Sadrita404/Differential-Swerve-Robot/USEFUL/BOM.xlsx

Differential Swerve Robot BOM
Summary |  |  |  |  | Low ($) | High ($)
Mechanical only |  |  |  |  | $110.00 | $158.00
Electrical, PCB build |  |  |  |  | $221.00 | $231.00
Electrical, breadboard build |  |  |  |  | $57.00 | $66.00
Total, PCB build |  |  |  |  | $331.00 | $389.00 | PCB at PCBWay price; JLC is cheaper. Excludes filament.
Total, breadboard build |  |  |  |  | $167.00 | $224.00 | No PCB, headers, JST, terminals, DIP switches, or buck. Excludes filament.
Category | Item | Spec | Qty needed | What to buy | Cost low ($) | Cost high ($) | Source | Notes | PCB build | Breadboard build
Mechanical | NEMA 17 stepper | 38-48mm body | 8 | 1x 10-pack | $60.00 | $90.00 | Amazon | Price depends on length. 2 spares in the pack. Motor wires included. | Y | Y
Mechanical | Pancake NEMA 17 stepper | Pancake | 1 | 1 | $10.00 | $10.00 | Amazon | Turret axis | Y | Y
Mechanical | M4x12 button head bolt | M4x12 | ~150 | Assortment / box | $10.00 | $20.00 | Amazon (budget) or McMaster | Amazon quality is usually poor; McMaster costs more | Y | Y
Mechanical | M3x10 button head bolt | M3x10 | 36 | Box | $5.00 | $5.00 | Amazon |  | Y | Y
Mechanical | U624 U-groove bearing | 4x13x7mm | 48-64 | 48: 40-pack + 10-pack; 64: 2x 40-pack | $22.00 | $30.00 | Amazon | 12-16 per module. More bearings = more stability, more friction. Packs: 10 for $7, 40 for $15 | Y | Y
Mechanical | 608 bearing | 8x22x7mm | 8 | 1x 10-pack | $3.00 | $3.00 | Amazon |  | Y | Y
Electrical | PCB (12-channel stepper carrier) | 4-layer, ~125x125mm | 1 | Fab order | $150.00 | $150.00 | PCBWay quote | PCBWay quoted $150. JLC is cheaper; replace with a JLC quote to lower this. 12 channels, only 9 used. | Y | N
Electrical | A4988 stepper driver | Stepstick | 9 | 1x 10-pack | $13.00 | $13.00 | Amazon | TMC2209, DRV8825 work as well | Y | Y
Electrical | Electrolytic capacitor | 100uF, 30V+ | 9 | Assortment | $1.00 | $1.00 | Amazon | Pennies each | Y | Y
Electrical | Pin headers, male + female | 2.54mm | As needed | Assortment | $5.00 | $5.00 | Amazon | Look for packs that have both male and female | Y | N
Electrical | JST XH male header | XH | 9 | Assortment | $8.00 | $8.00 | Amazon | Mating connectors usually come with motors | Y | N
Electrical | Screw terminal block | 2-pin, 5.08mm pitch | 3 | Assortment | $4.00 | $4.00 | Amazon |  | Y | N
Electrical | DIP switch | 3-position | 2 | Assortment | $5.00 | $5.00 | Amazon |  | Y | N
Electrical | MCU | ESP32/2560 etc. | 1 | 1 | $5.00 | $10.00 | Amazon |  | Y | Y
Electrical | Li-ion battery pack |  | 1 | 1 | $30.00 | $30.00 | Amazon |  | Y | Y
Electrical | Breadboard + jumper wires |  | 1 set | Kit | $8.00 | $12.00 | Amazon | Breadboard Approximate | N | Y
Electrical | 5V buck converter (optional) |  | 0-1 | 1 | $0.00 | $5.00 | Amazon | Only if powering the MCU from the main battery; a power bank works otherwise | Y | N
