Sadrita404/Differential-Swerve-Robot/PCB_ELECTRICAL/2_ASSEMBLY_DATA/12SW_standard/12StepperPCB_RevB_12SW_BOM.csv

Reference | Value | Footprint | MPN | Qty
C1,C4,C7,C10,C13,C16,C19,C22,C25,C28,C31,C34 | 100uF/50V | Capacitor_THT:CP_Radial_D8.0mm_P3.50mm | EEU-FR1H101 | 12
C37,C38 | 1000uF/50V | Capacitor_THT:CP_Radial_D12.5mm_P5.00mm | EEU-FR1H102 | 2
D1 | SMBJ30A | Diode_SMD:D_SMB | SMBJ30A | 1
J1-J12 | Stepstick_Ctrl | Connector_PinSocket_2.54mm:PinSocket_1x08_P2.54mm_Vertical | PPTC081LFBN-RC | 12
J13-J24 | Stepstick_Pwr | Connector_PinSocket_2.54mm:PinSocket_1x08_P2.54mm_Vertical | PPTC081LFBN-RC | 12
J25-J36 | Motor_JST_XH | Connector_JST:JST_XH_B4B-XH-A_1x04_P2.50mm_Vertical | B4B-XH-A(LF)(SN) | 12
J49 | IDC_Control_26p | Connector_IDC:IDC-Header_2x13_P2.54mm_Vertical | 302-S261 | 1
J50 | EN_Header | Connector_PinHeader_2.54mm:PinHeader_1x03_P2.54mm_Vertical | PREC003SAAN-RC | 1
J51 | VDD_5V_IN | TerminalBlock_Phoenix:TerminalBlock_Phoenix_MKDS-1,5-2-5.08_1x02_P5.08mm_Horizontal | 1715721 | 1
J52 | VMOT_IN_A | TerminalBlock_Phoenix:TerminalBlock_Phoenix_MKDS-3-2-5.08_1x02_P5.08mm_Horizontal | 1711725 | 1
J53 | VMOT_IN_B | TerminalBlock_Phoenix:TerminalBlock_Phoenix_MKDS-3-2-5.08_1x02_P5.08mm_Horizontal | 1711725 | 1
SW1-SW12 | Microstep_Sel | Button_Switch_THT:SW_DIP_SPSTx03_Slide_9.78x9.8mm_W7.62mm_P2.54mm | 206-3 | 12
