Sadrita404/Differential-Swerve-Robot/CAD_STLS/MAIN.step

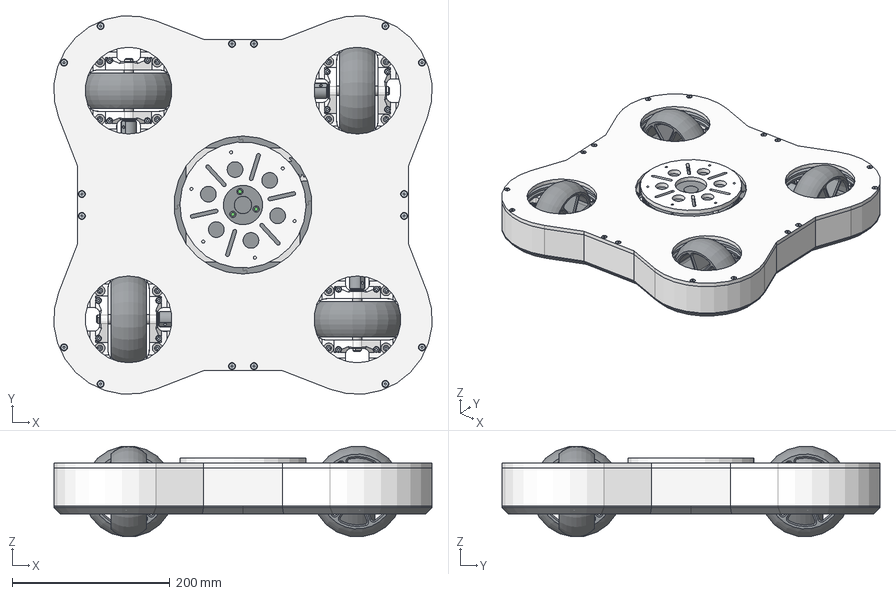
[picture p1: CAD file, 2026-11-04]
CAD_STLS/MAIN.step
479.2 x 479.2 x 114.7 mm
Hex socket countersunk head screw M4x0.7 x 8 x 16
1inSpacer:1__Solid1 x 5
AdapterPlate:1__Solid1
Spur Gear2:1__Solid1
17HM08-1204S Nema17 Pancake 21mm:1__Solid7 x 2
Spur Gear1:1__Solid1
PCB:1__Solid1
SlipRing:1__Solid1
Polycarbonate lid
17HM08-1204S Nema17 Pancake 21mm:1__Solid6
17HM08-1204S Nema17 Pancake 21mm:1__Solid13
17HM08-1204S Nema17 Pancake 21mm:1__Solid11
17HM08-1204S Nema17 Pancake 21mm:1__Solid4
17HM08-1204S Nema17 Pancake 21mm:1__Solid8
17HM08-1204S Nema17 Pancake 21mm:1__Solid9
17HM08-1204S Nema17 Pancake 21mm:1__Solid5
17HM08-1204S Nema17 Pancake 21mm:1__Solid3
17HM08-1204S Nema17 Pancake 21mm:1__Solid12
17HM08-1204S Nema17 Pancake 21mm:1__Solid10
17HM08-1204S Nema17 Pancake 21mm:1__Solid14
17HM08-1204S Nema17 Pancake 21mm:1__Solid1
17HM08-1204S Nema17 Pancake 21mm:1__Solid2
Hex socket head cap screw M4x0.70 x 8 x 32
Hex socket head cap screw M4x0.70 x 15 x 48
PCBspacer:1__Solid1 x 3
ModuleScaleTest:1__Solid79 x 32
SideCover x 4
Recessed Mount x 4
Hex socket head cap screw M4x0.70 x 12 x 44
8mm Axle x 4
Stepper Motor Gear x 8
Wheel x 4
Spacer 2 x 4
Raised Mount x 4
Inner Differential Gear x 4
Differential Ring Gear x 8
bas x 4
Revised Bearing x 4
Wheel Well x 4
Spacer 1 x 4
countersunk flat head cross recess screw_din_17HM19-2004S-9-solid1 x 8
radial ball bearing_68_din-1-solid1 x 8
nema17_middle-1-solid1 x 8
countersunk flat head cross recess screw_din_17HM19-2004S-7-solid1 x 8
nema17_bottom-1-solid2 x 8
countersunk flat head cross recess screw_din_17HM19-2004S-8-solid1 x 8
countersunk flat head cross recess screw_din_17HM19-2004S-10-solid1 x 8
nema17_bottom-1-solid1 x 8
nema17_top-1-solid1 x 8
nema17_shaft-1-solid1 x 8
radial ball bearing_68_din-3-solid1 x 8
Bearing Clip x 4
WheelGuard x 4
COVER__Boss-Extrude1_1 x 8
INNER RACE__Cut-Revolve1 x 8
BALL__Revolve1_6 x 64
COVER__Boss-Extrude1 x 8
OUTER RACE__Chamfer1 x 8
