Sadrita404/Differential-Swerve-Robot/CAD_STLS/Cover.dxf

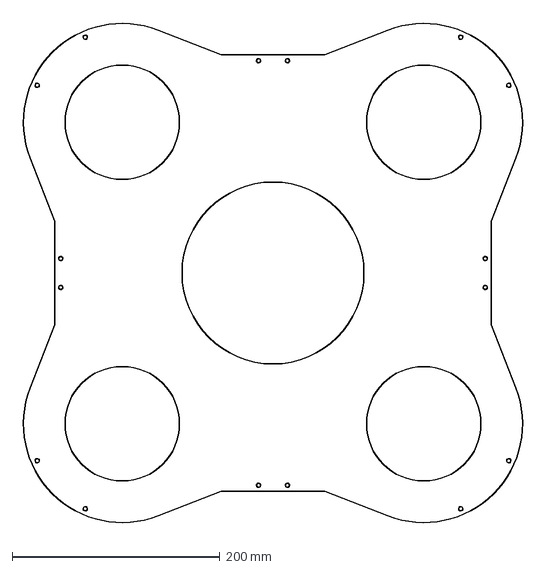
[picture p2: CAD file, 2026-11-04]
CAD_STLS/Cover.dxf
494.4 x 494.4 mm
