Sadrita404/Differential-Swerve-Robot/CAD_STLS/STL/DSP2_ShaftSpacer_4X.stl

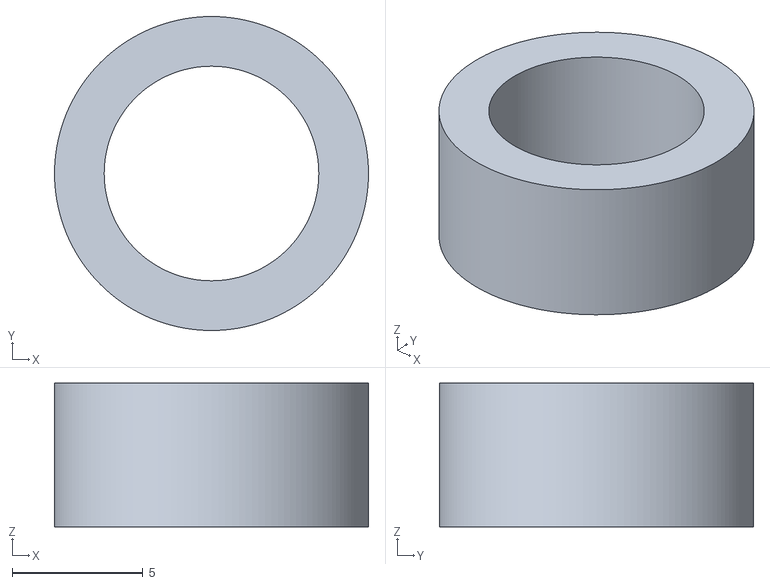
[picture p3: CAD file, 2026-11-04]
CAD_STLS/STL/DSP2_ShaftSpacer_4X.stl
12.0 x 12.0 x 5.50
