Sadrita404/Differential-Swerve-Robot/CAD_STLS/STL/PrintedLid/DSP2_PrintedLidQuater_4X.stl

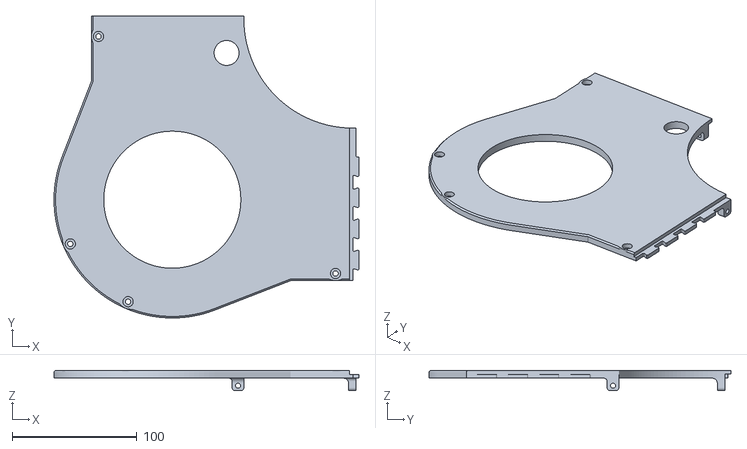
[picture p4: CAD file, 2026-11-04]
CAD_STLS/STL/PrintedLid/DSP2_PrintedLidQuater_4X.stl
244.9 x 242.5 x 16.4
