Sadrita404/Differential-Swerve-Robot/USEFUL/Roller spacing jig.stl

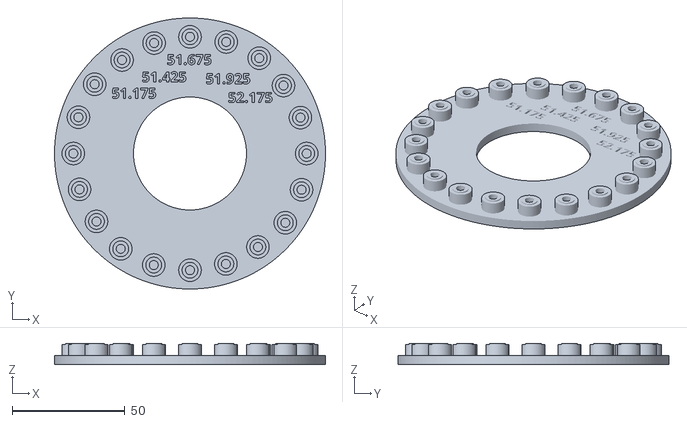
[picture p5: CAD file, 2026-11-04]
USEFUL/Roller spacing jig.stl
120.0 x 120.0 x 9.50
