Sadrita404/Differential-Swerve-Robot/CAD_STLS/STL/DSP2_TurretBase_1X.stl

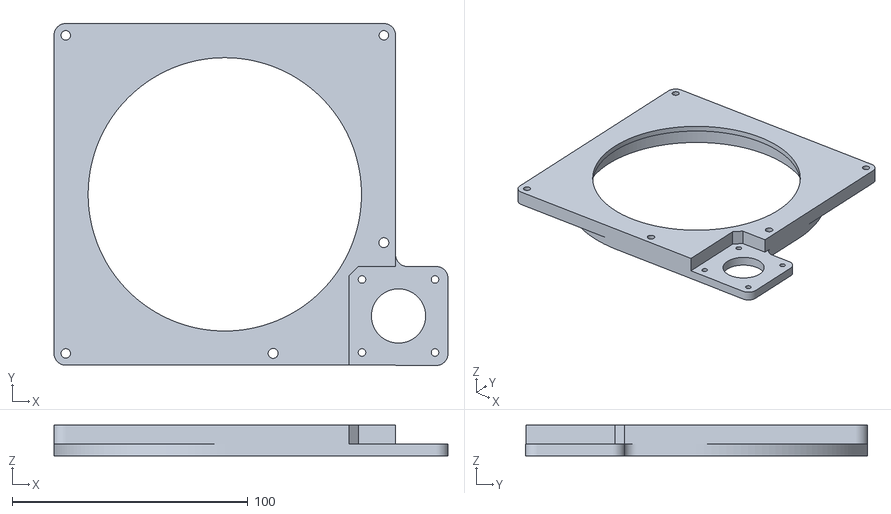
[picture p6: CAD file, 2026-11-04]
CAD_STLS/STL/DSP2_TurretBase_1X.stl
167.2 x 145.1 x 13.0
