Sadrita404/Differential-Swerve-Robot/USEFUL/StepperShaftClearanceJig.stl

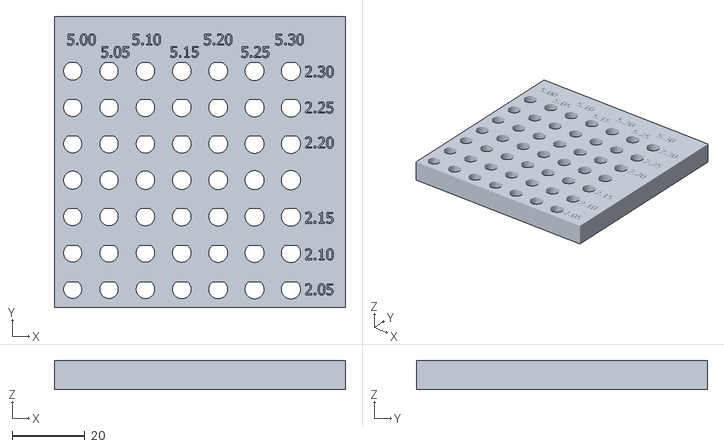
[picture p7: CAD file, 2026-11-04]
USEFUL/StepperShaftClearanceJig.stl
80.0 x 80.0 x 8.00
