Sadrita404/Differential-Swerve-Robot/CAD_STLS/STL/DSP2_WheelFrame_4X.stl

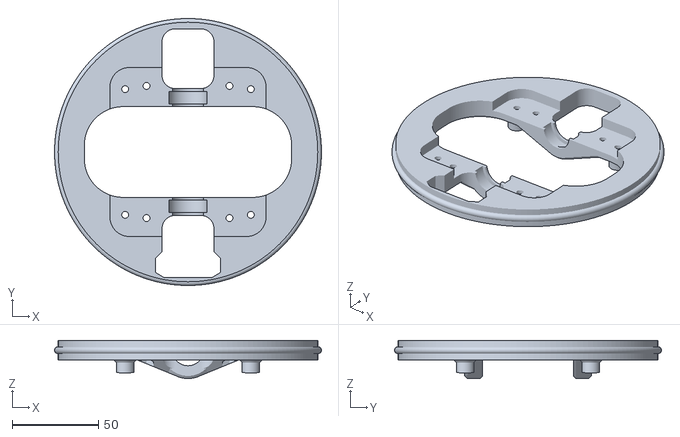
[picture p8: CAD file, 2026-11-04]
CAD_STLS/STL/DSP2_WheelFrame_4X.stl
154.5 x 154.5 x 22.0
