Sadrita404/Differential-Swerve-Robot/CAD_STLS/STL/DSP2_Ring_8X.stl

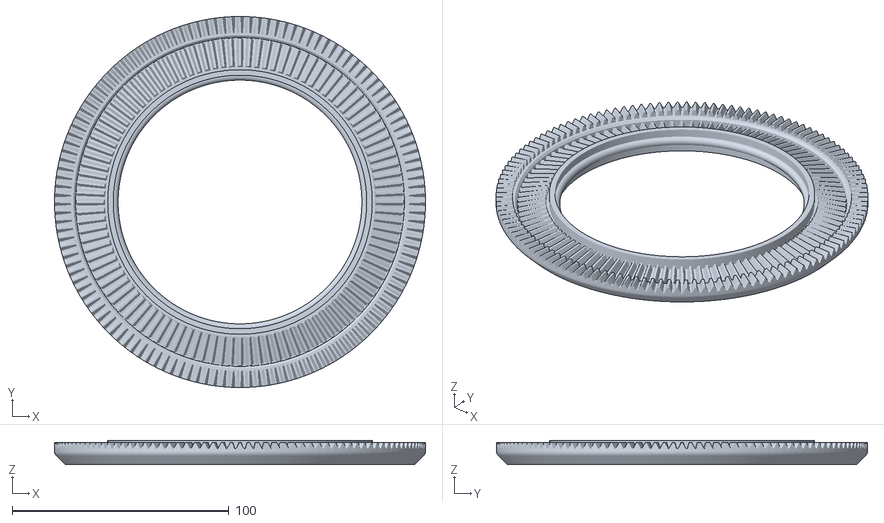
[picture p9: CAD file, 2026-11-04]
CAD_STLS/STL/DSP2_Ring_8X.stl
171.2 x 171.2 x 11.2
