Sadrita404/Differential-Swerve-Robot/CAD_STLS/STL/DSP2_ShortMount_4X.stl

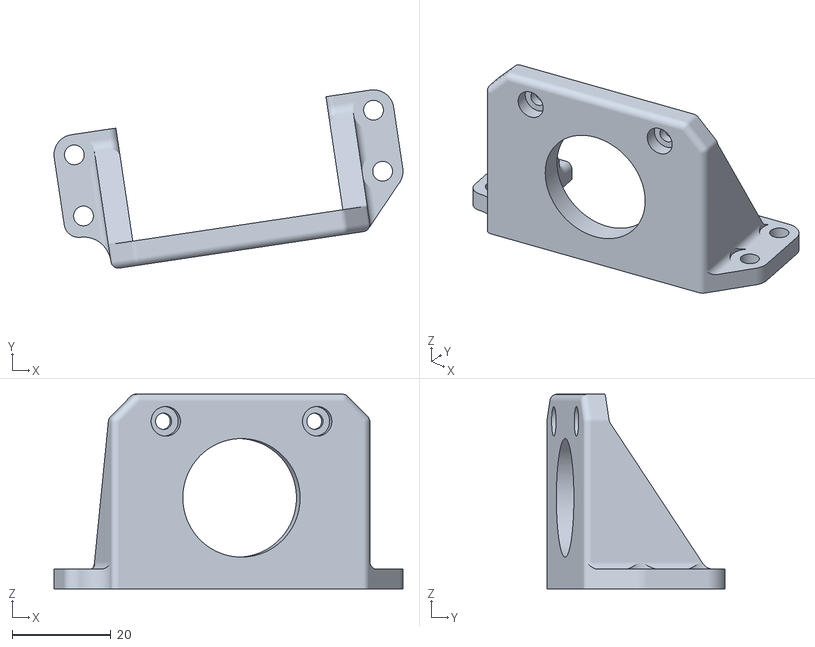
[picture p10: CAD file, 2026-11-04]
CAD_STLS/STL/DSP2_ShortMount_4X.stl
70.7 x 36.1 x 39.4
