Sadrita404/Differential-Swerve-Robot/CAD_STLS/STL/DSP2_TurretGear_1X.stl

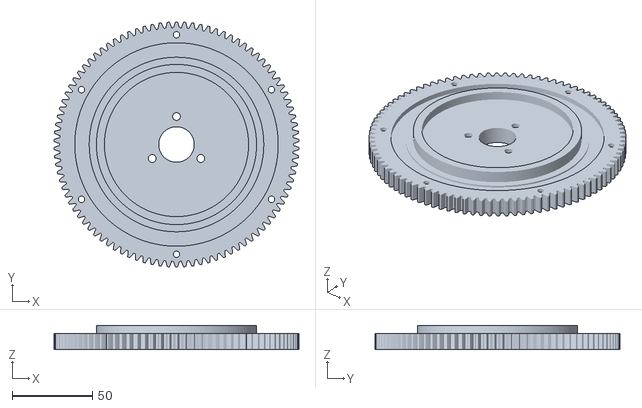
[picture p11: CAD file, 2026-11-04]
CAD_STLS/STL/DSP2_TurretGear_1X.stl
153.0 x 153.0 x 15.0
