Sadrita404/Differential-Swerve-Robot/CAD_STLS/STL/DSP2_Base_4X.stl

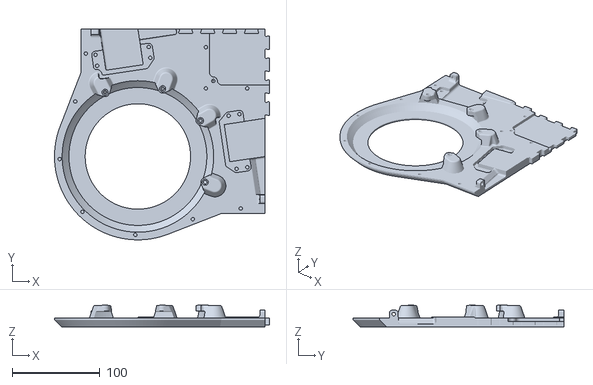
[picture p12: CAD file, 2026-11-04]
CAD_STLS/STL/DSP2_Base_4X.stl
244.9 x 240.0 x 24.8
