Sadrita404/Differential-Swerve-Robot/CAD_STLS/STL/DSP2_Side_4X.stl

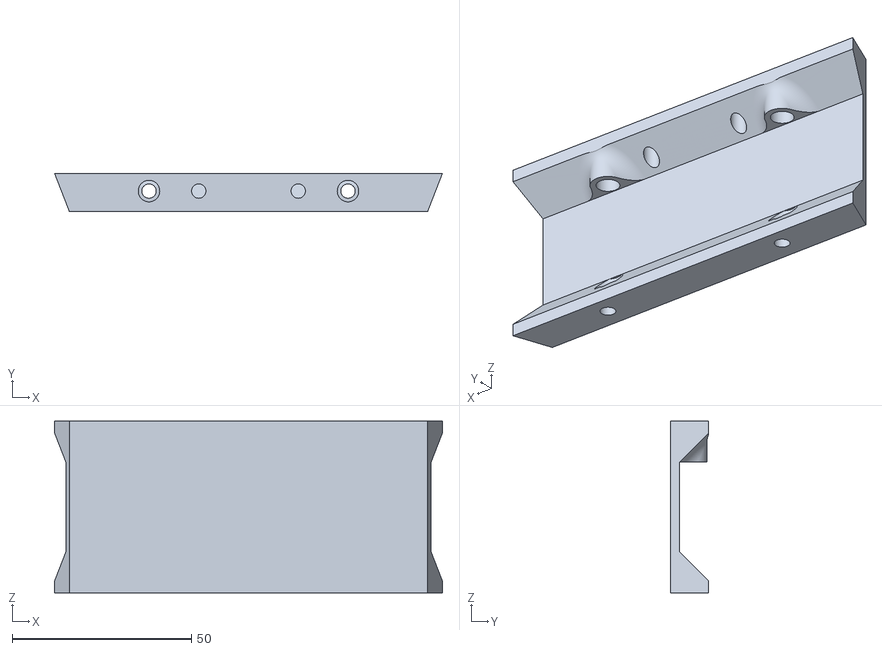
[picture p13: CAD file, 2026-11-04]
CAD_STLS/STL/DSP2_Side_4X.stl
108.3 x 10.7 x 48.0
