Sadrita404/Differential-Swerve-Robot/CAD_STLS/STL/DSP2_Wheel_4X.stl

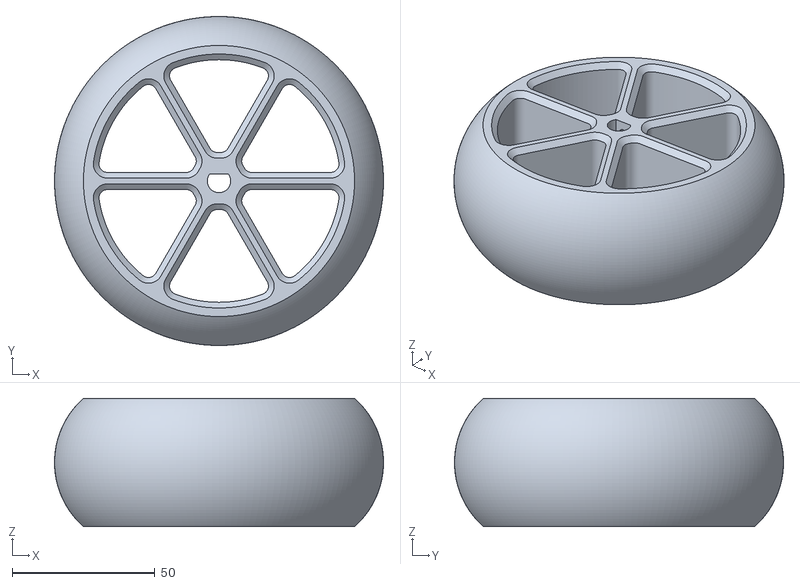
[picture p14: CAD file, 2026-11-04]
CAD_STLS/STL/DSP2_Wheel_4X.stl
115.3 x 115.3 x 45.0
