Sadrita404/Differential-Swerve-Robot/CAD_STLS/STL/DSP2_6820Bearing_1X.stl

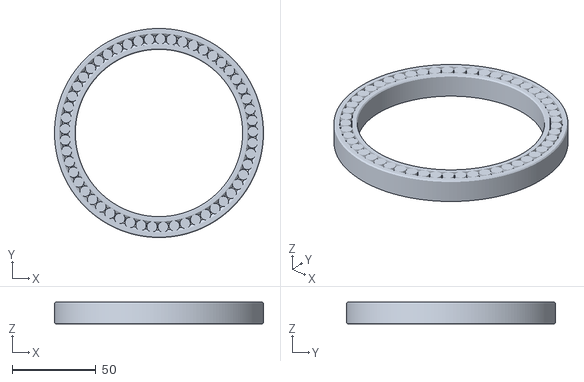
[picture p15: CAD file, 2026-11-04]
CAD_STLS/STL/DSP2_6820Bearing_1X.stl
125.0 x 125.0 x 13.0
