Sadrita404/Differential-Swerve-Robot/CAD_STLS/STL/DSP2_WheelClamp_8X.stl

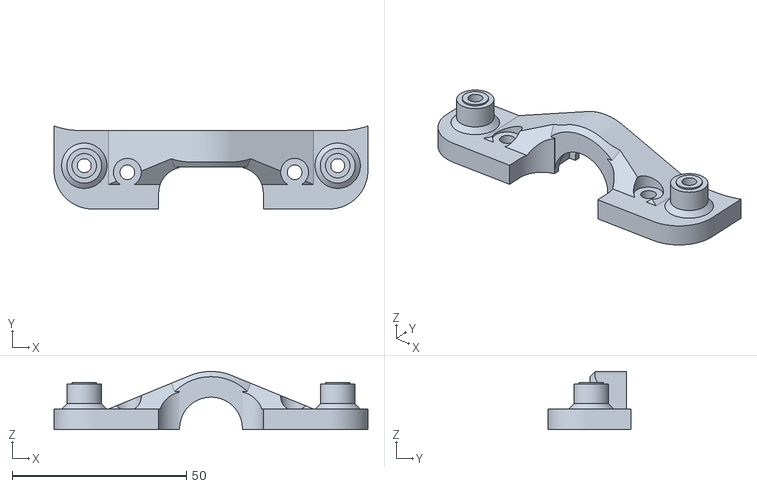
[picture p16: CAD file, 2026-11-04]
CAD_STLS/STL/DSP2_WheelClamp_8X.stl
90.1 x 23.9 x 16.7
