Sadrita404/Differential-Swerve-Robot/CAD_STLS/STL/DSP2_TurretSpacer_5X.stl

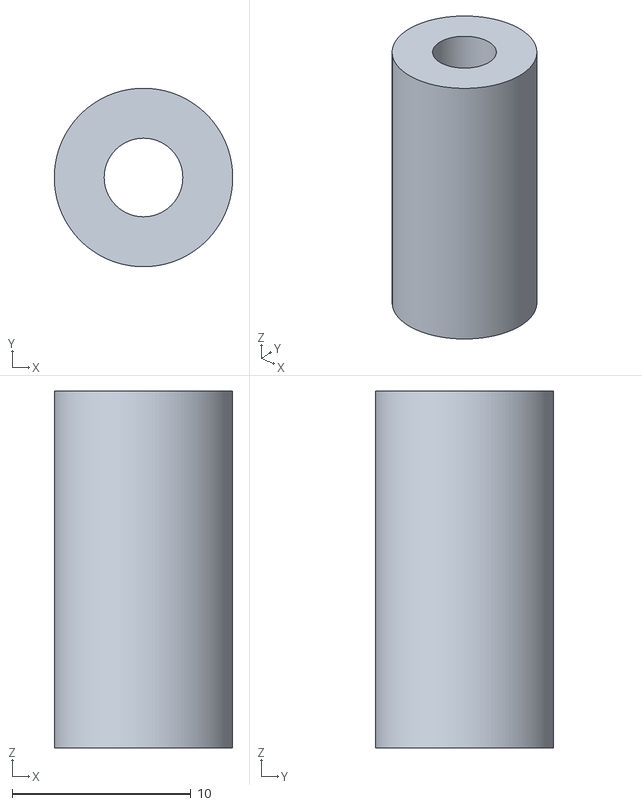
[picture p17: CAD file, 2026-11-04]
CAD_STLS/STL/DSP2_TurretSpacer_5X.stl
10.0 x 10.0 x 20.0
