Sadrita404/Differential-Swerve-Robot/CAD_STLS/STL/DSP2_TurretAdapterPlate_1X.stl

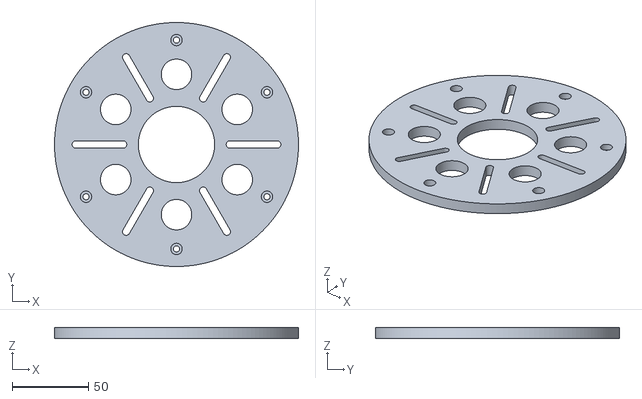
[picture p18: CAD file, 2026-11-04]
CAD_STLS/STL/DSP2_TurretAdapterPlate_1X.stl
160.0 x 160.0 x 7.00
