Sadrita404/Differential-Swerve-Robot/CAD_STLS/STL/DSP2_ShaftBevelGear_4X.stl

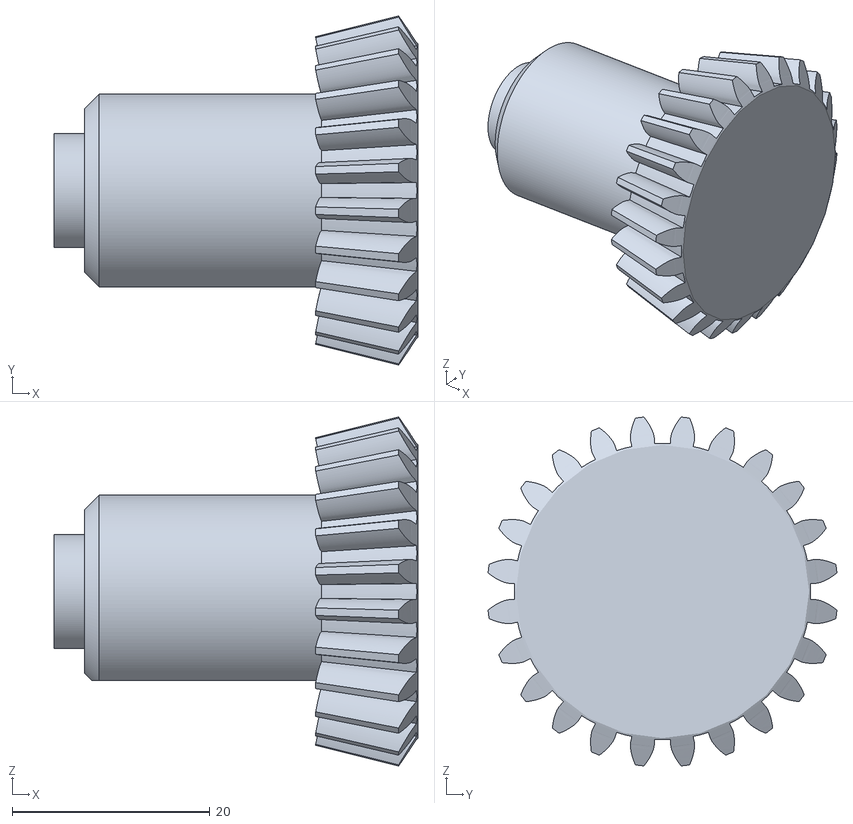
[picture p19: CAD file, 2026-11-04]
CAD_STLS/STL/DSP2_ShaftBevelGear_4X.stl
36.8 x 35.3 x 35.3
