Sadrita404/Differential-Swerve-Robot/CAD_STLS/STL/DSP2_WheelGuard_4X.stl

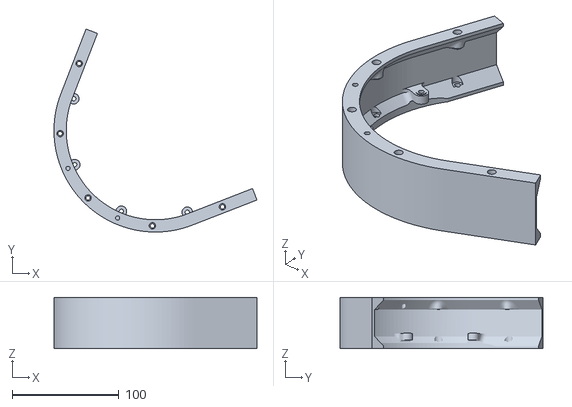
[picture p20: CAD file, 2026-11-04]
CAD_STLS/STL/DSP2_WheelGuard_4X.stl
190.0 x 190.0 x 48.0
