Sadrita404/Differential-Swerve-Robot/CAD_STLS/STL/DSP2_AdapterPlateSpacer_6X.stl

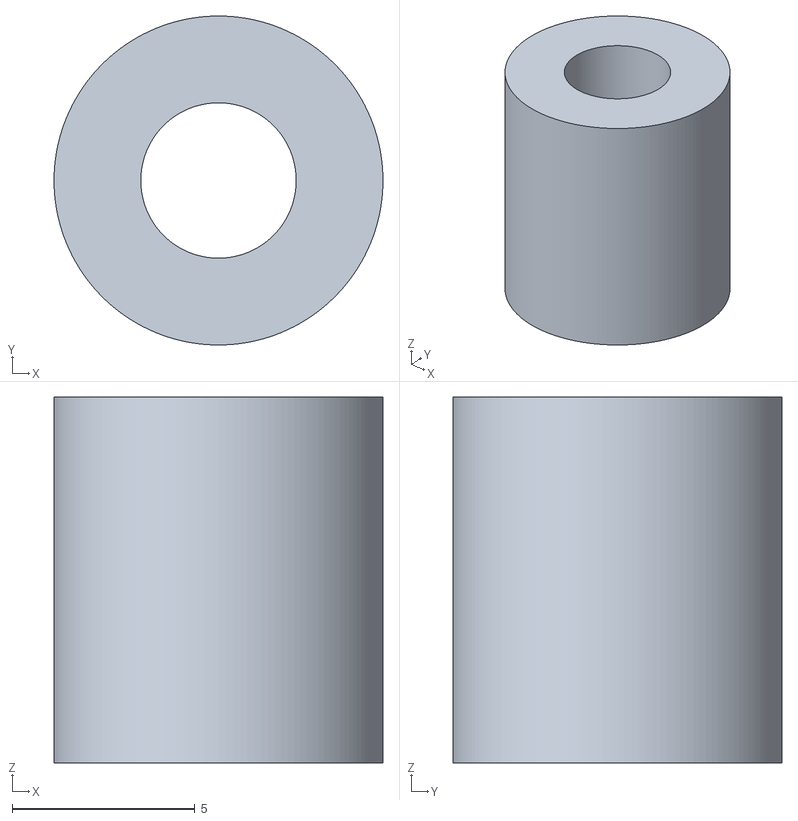
[picture p21: CAD file, 2026-11-04]
CAD_STLS/STL/DSP2_AdapterPlateSpacer_6X.stl
9.00 x 9.00 x 10.0
