Sadrita404/Differential-Swerve-Robot/CAD_STLS/STL/DSP2_TallMount_4X.stl

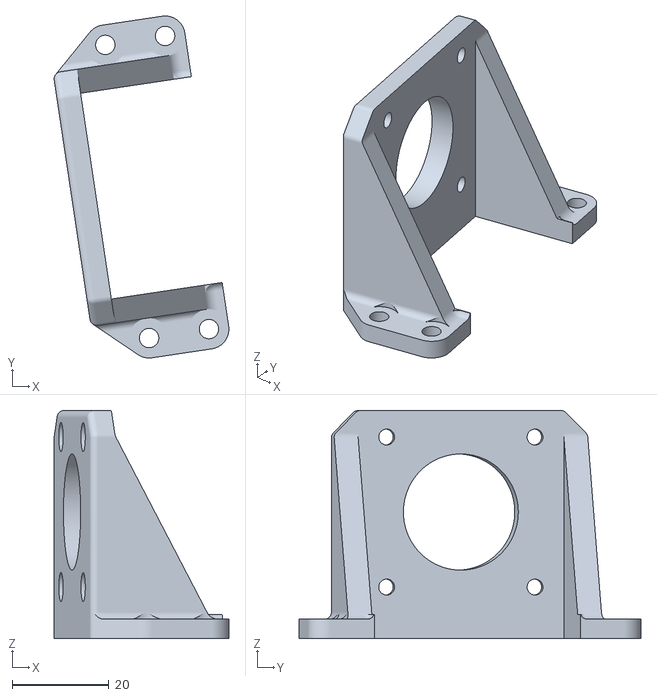
[picture p22: CAD file, 2026-11-04]
CAD_STLS/STL/DSP2_TallMount_4X.stl
36.1 x 70.7 x 47.1
