Sadrita404/Differential-Swerve-Robot/CAD_STLS/STL/DSP2_Axle_4x.stl

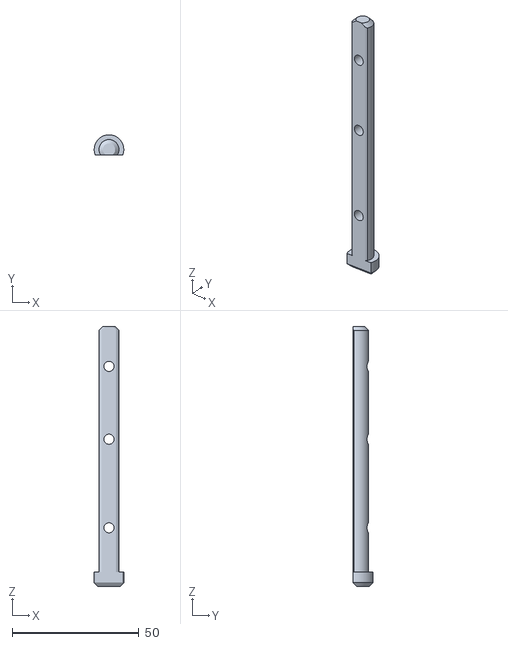
[picture p23: CAD file, 2026-11-04]
CAD_STLS/STL/DSP2_Axle_4x.stl
11.7 x 8.09 x 102.8
