Sadrita404/Differential-Swerve-Robot/PCB_ELECTRICAL/2_ASSEMBLY_DATA/2SW_variant/12StepperPCB_RevB_2SW_Schematic.pdf

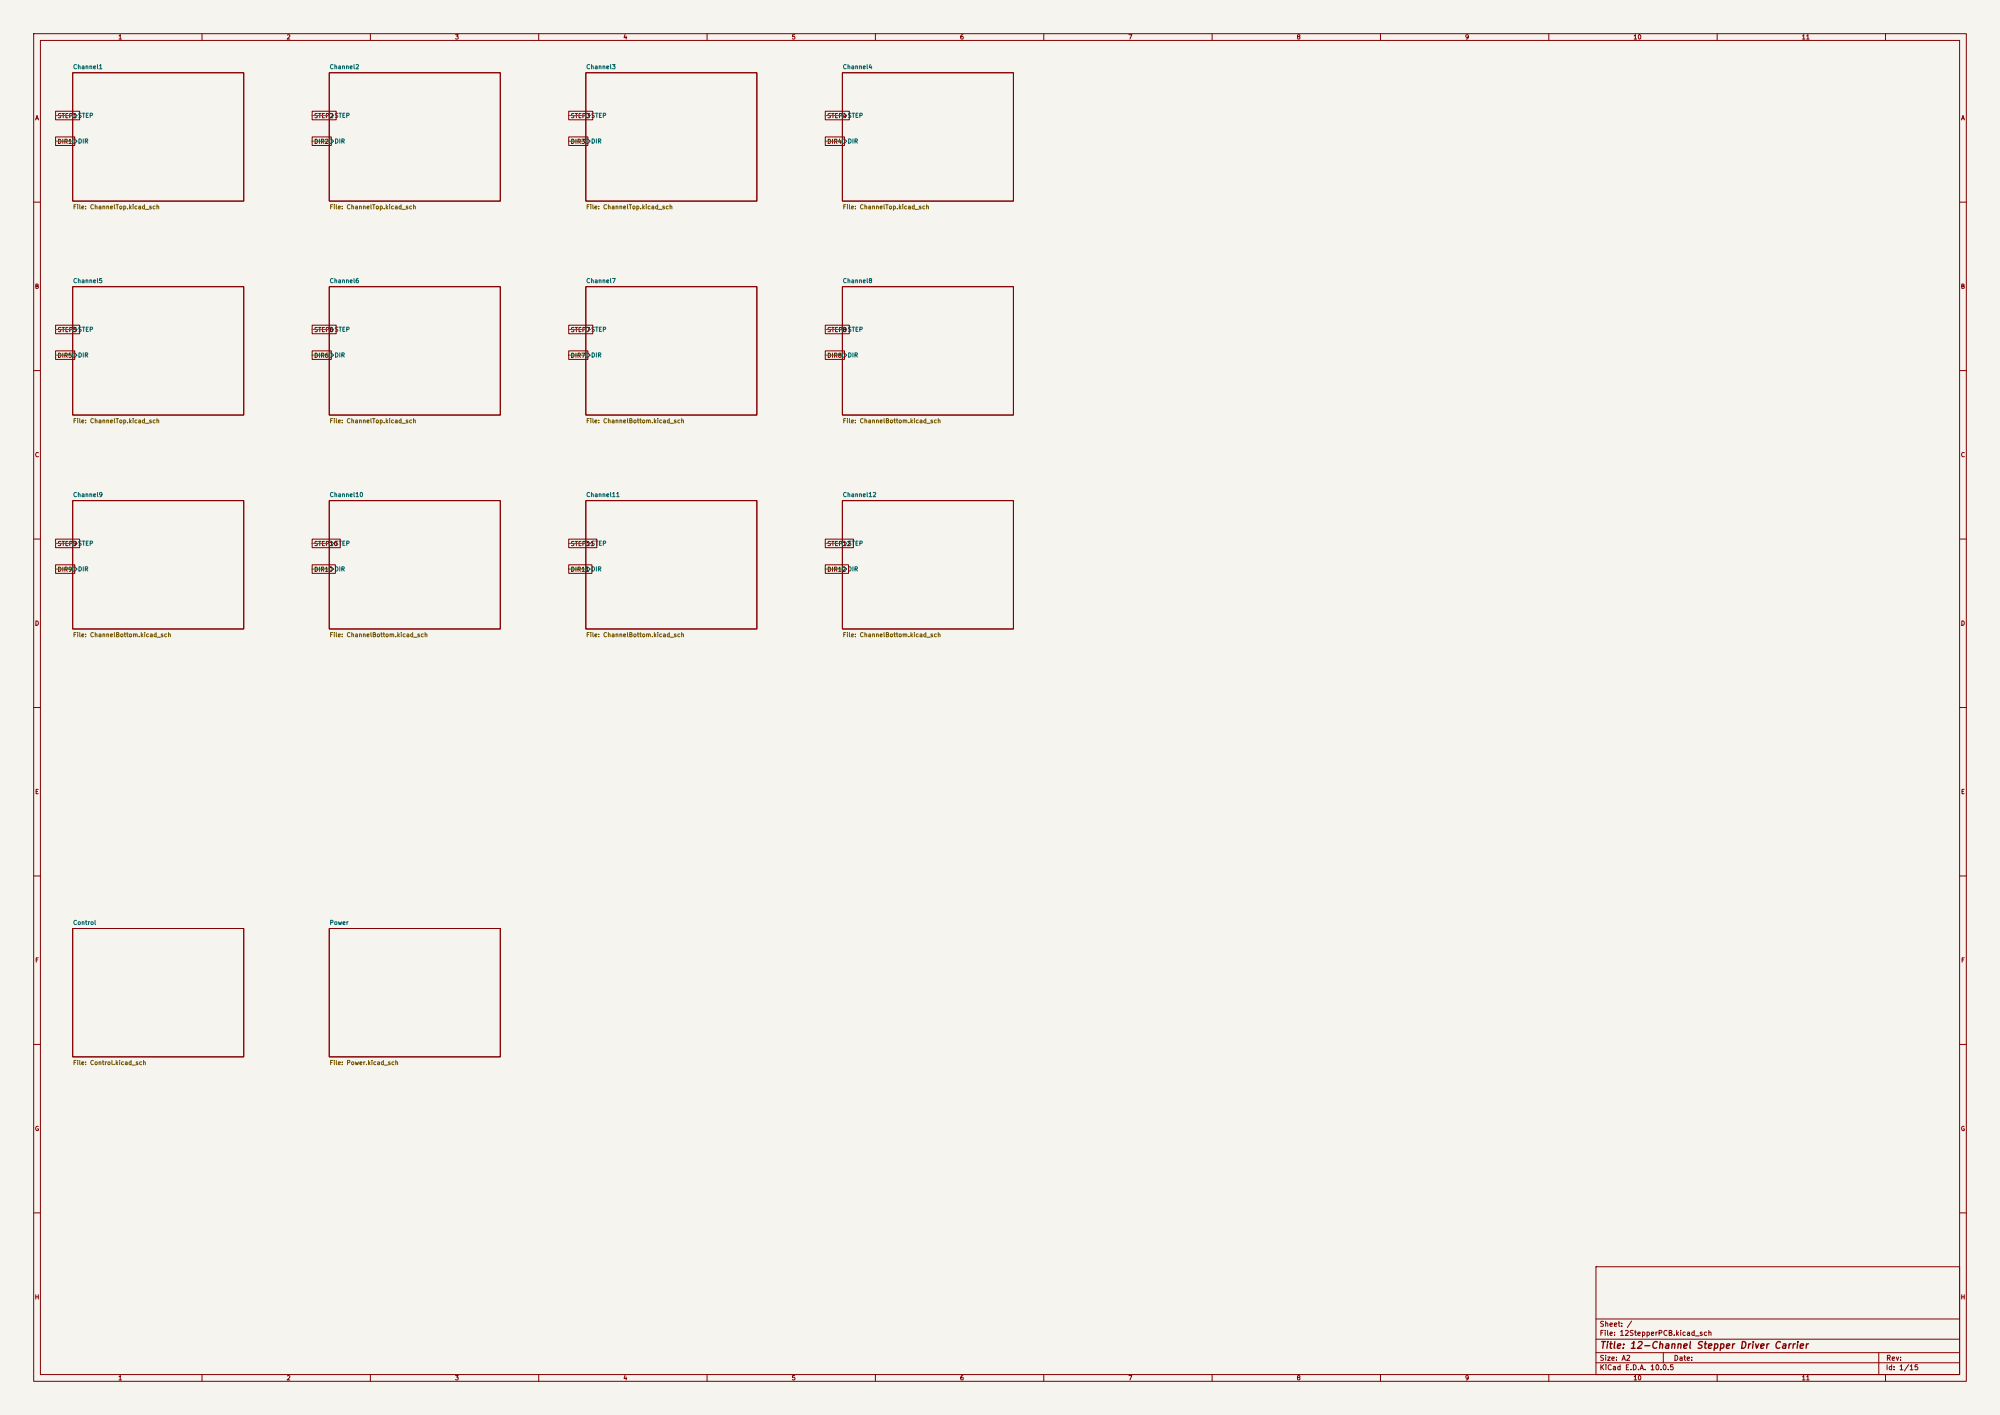
[picture p24: page 1]

Sheet: /
File: 12StepperPCB.kicad_sch
Title: 12-Channel Stepper Driver Carrier

Size: A2 | Rev:
KiCad E.D.A. 10.0.5 | Id: 1/15

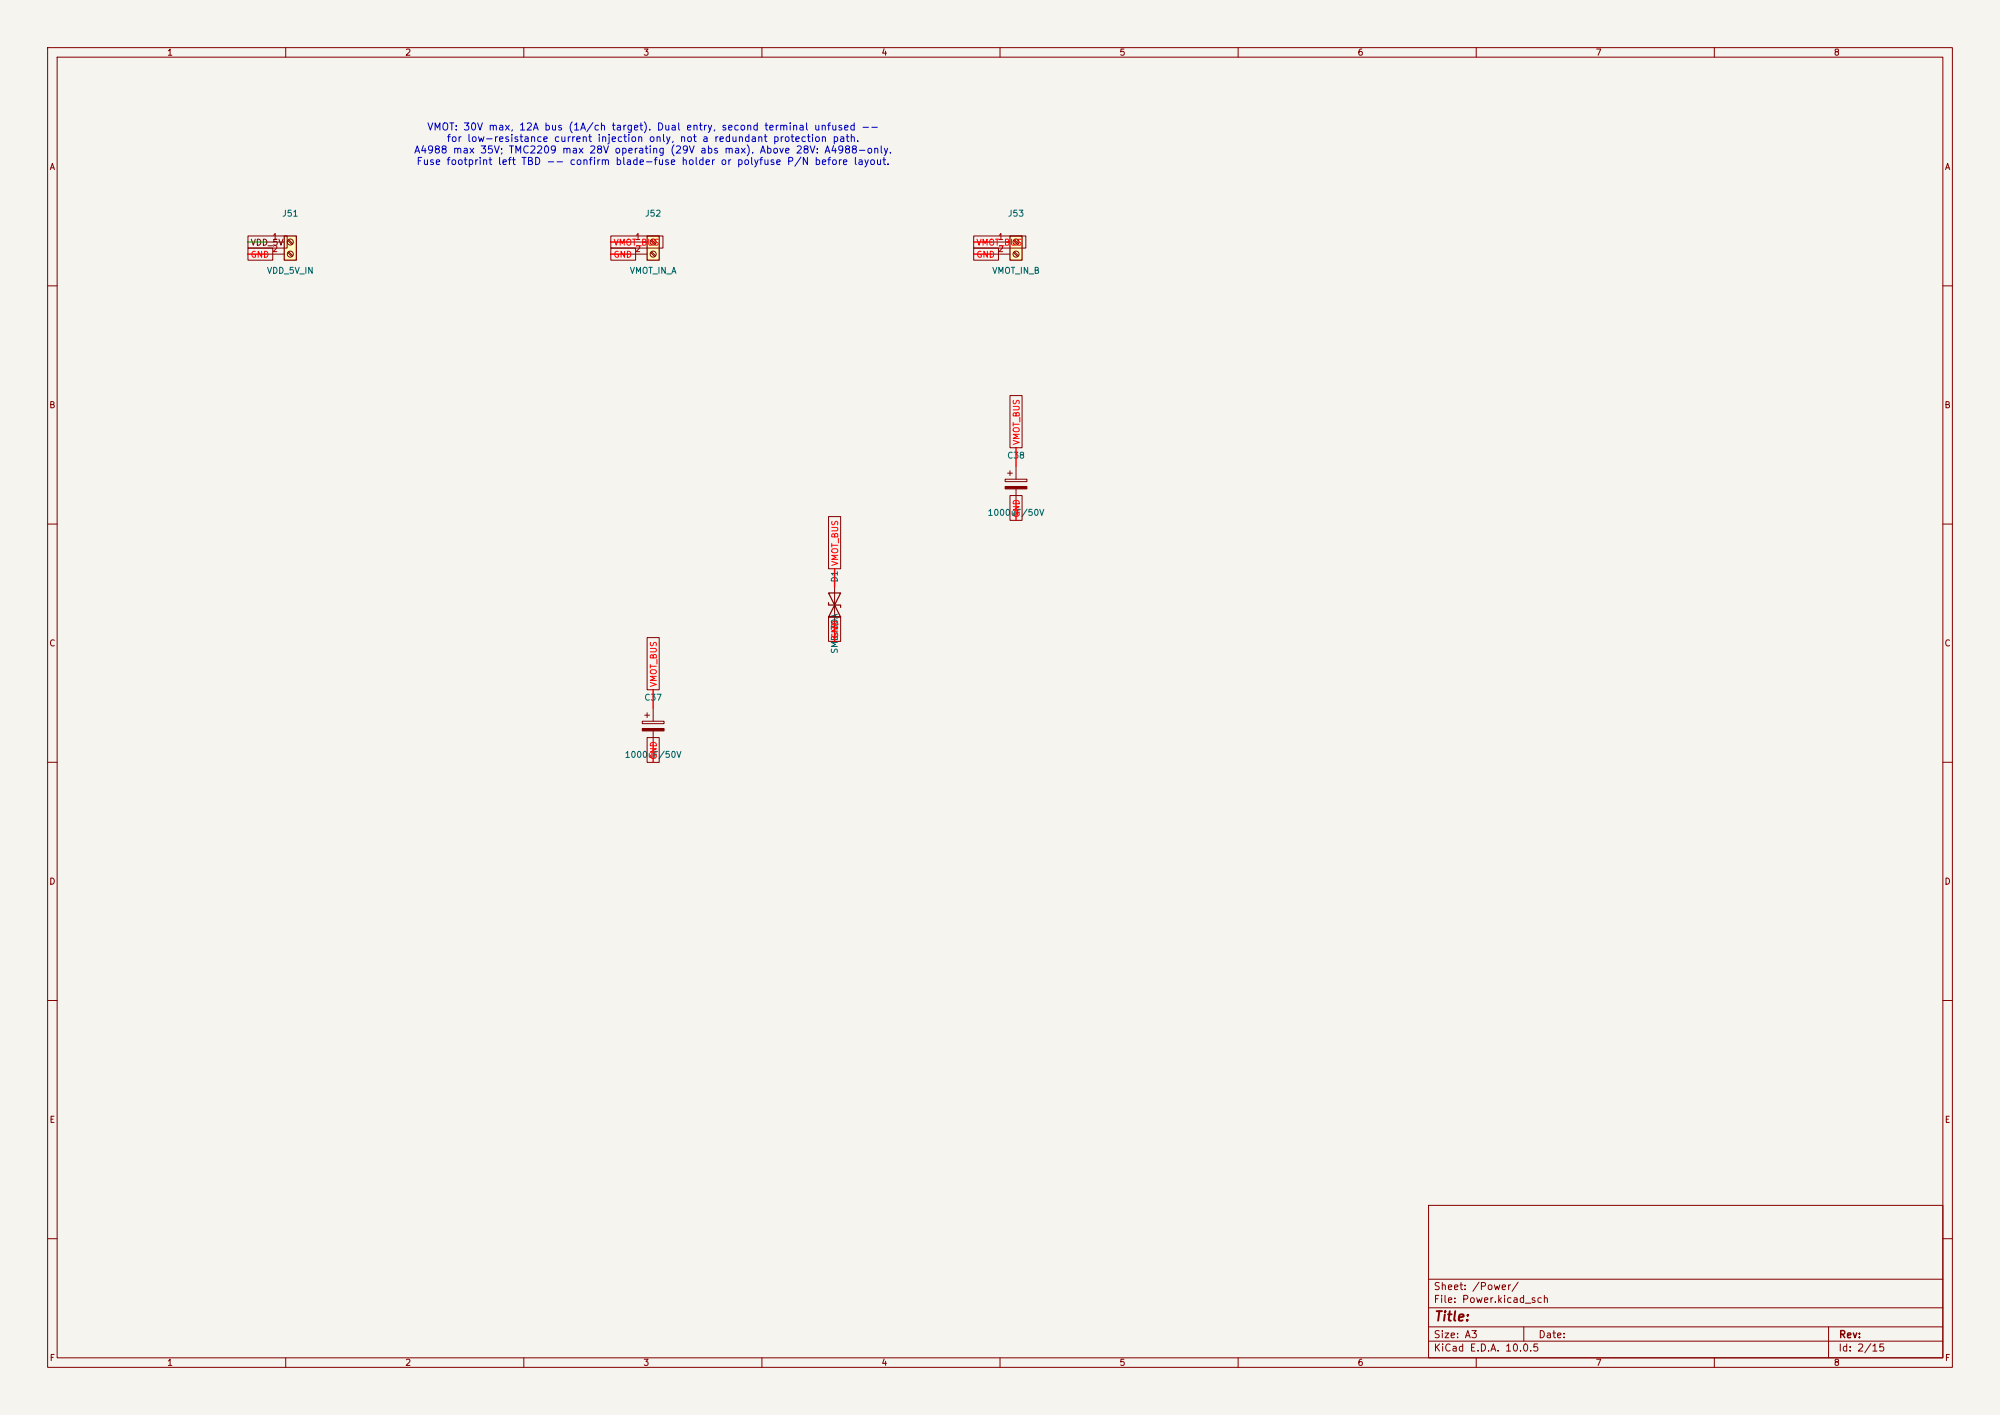
[picture p25: page 2]

VMOT: 30V max, 12A bus (1A/ch target). Dual entry, second terminal unfused --
for low-resistance current injection only, not a redundant protection path.
A4988 max 35V; TMC2209 max 28V operating (29V abs max). Above 28V: A4988-only.
Fuse footprint left TBD -- confirm blade-fuse holder or polyfuse P/N before layout.

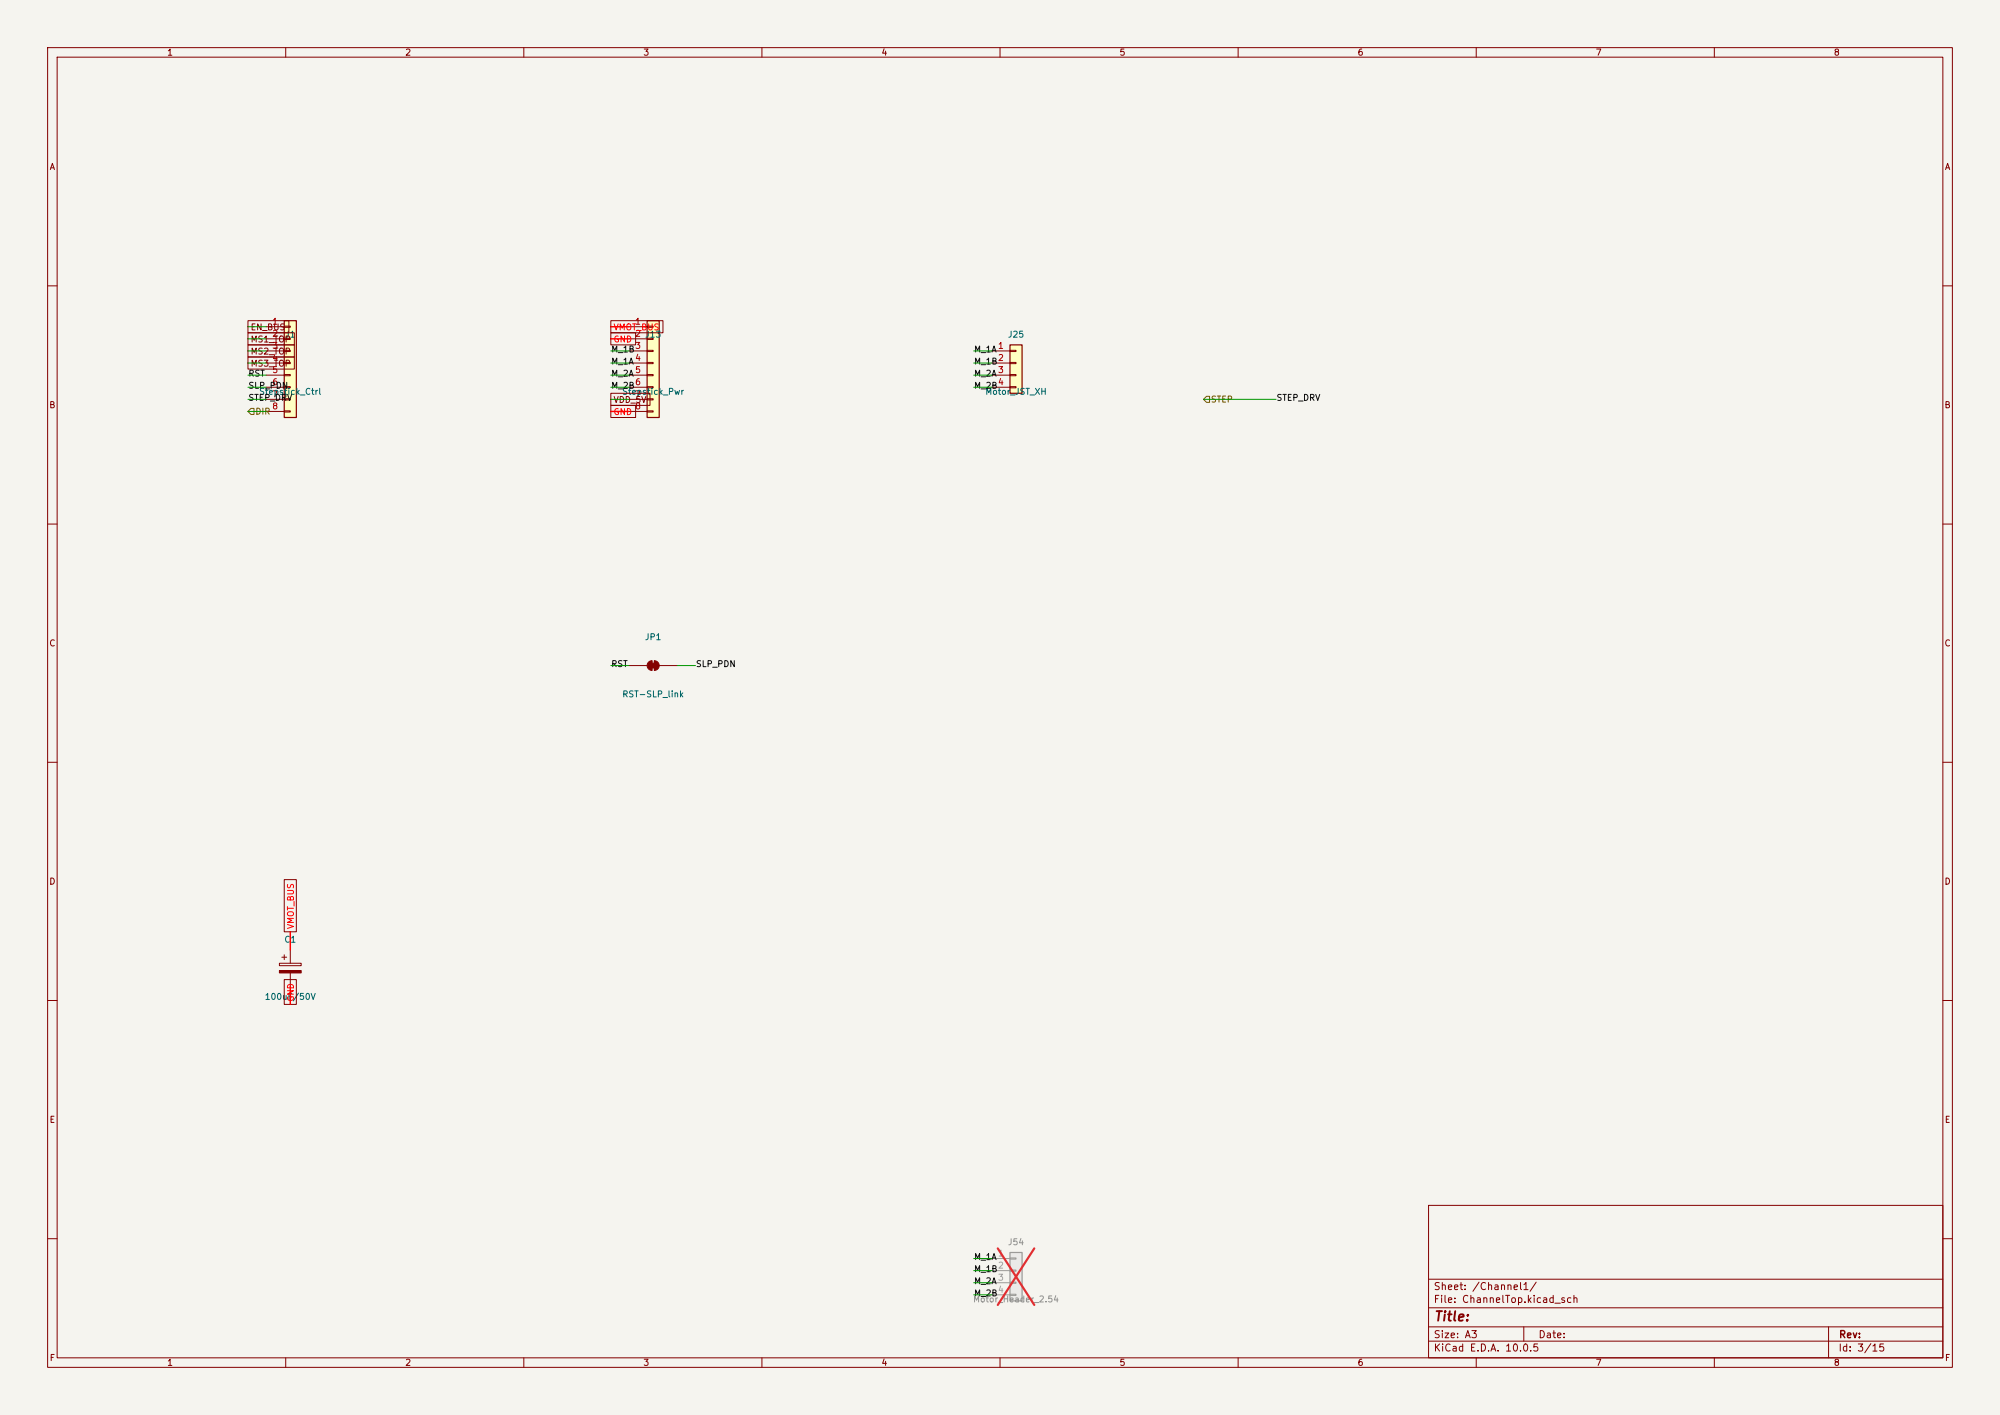
[picture p26: page 3]

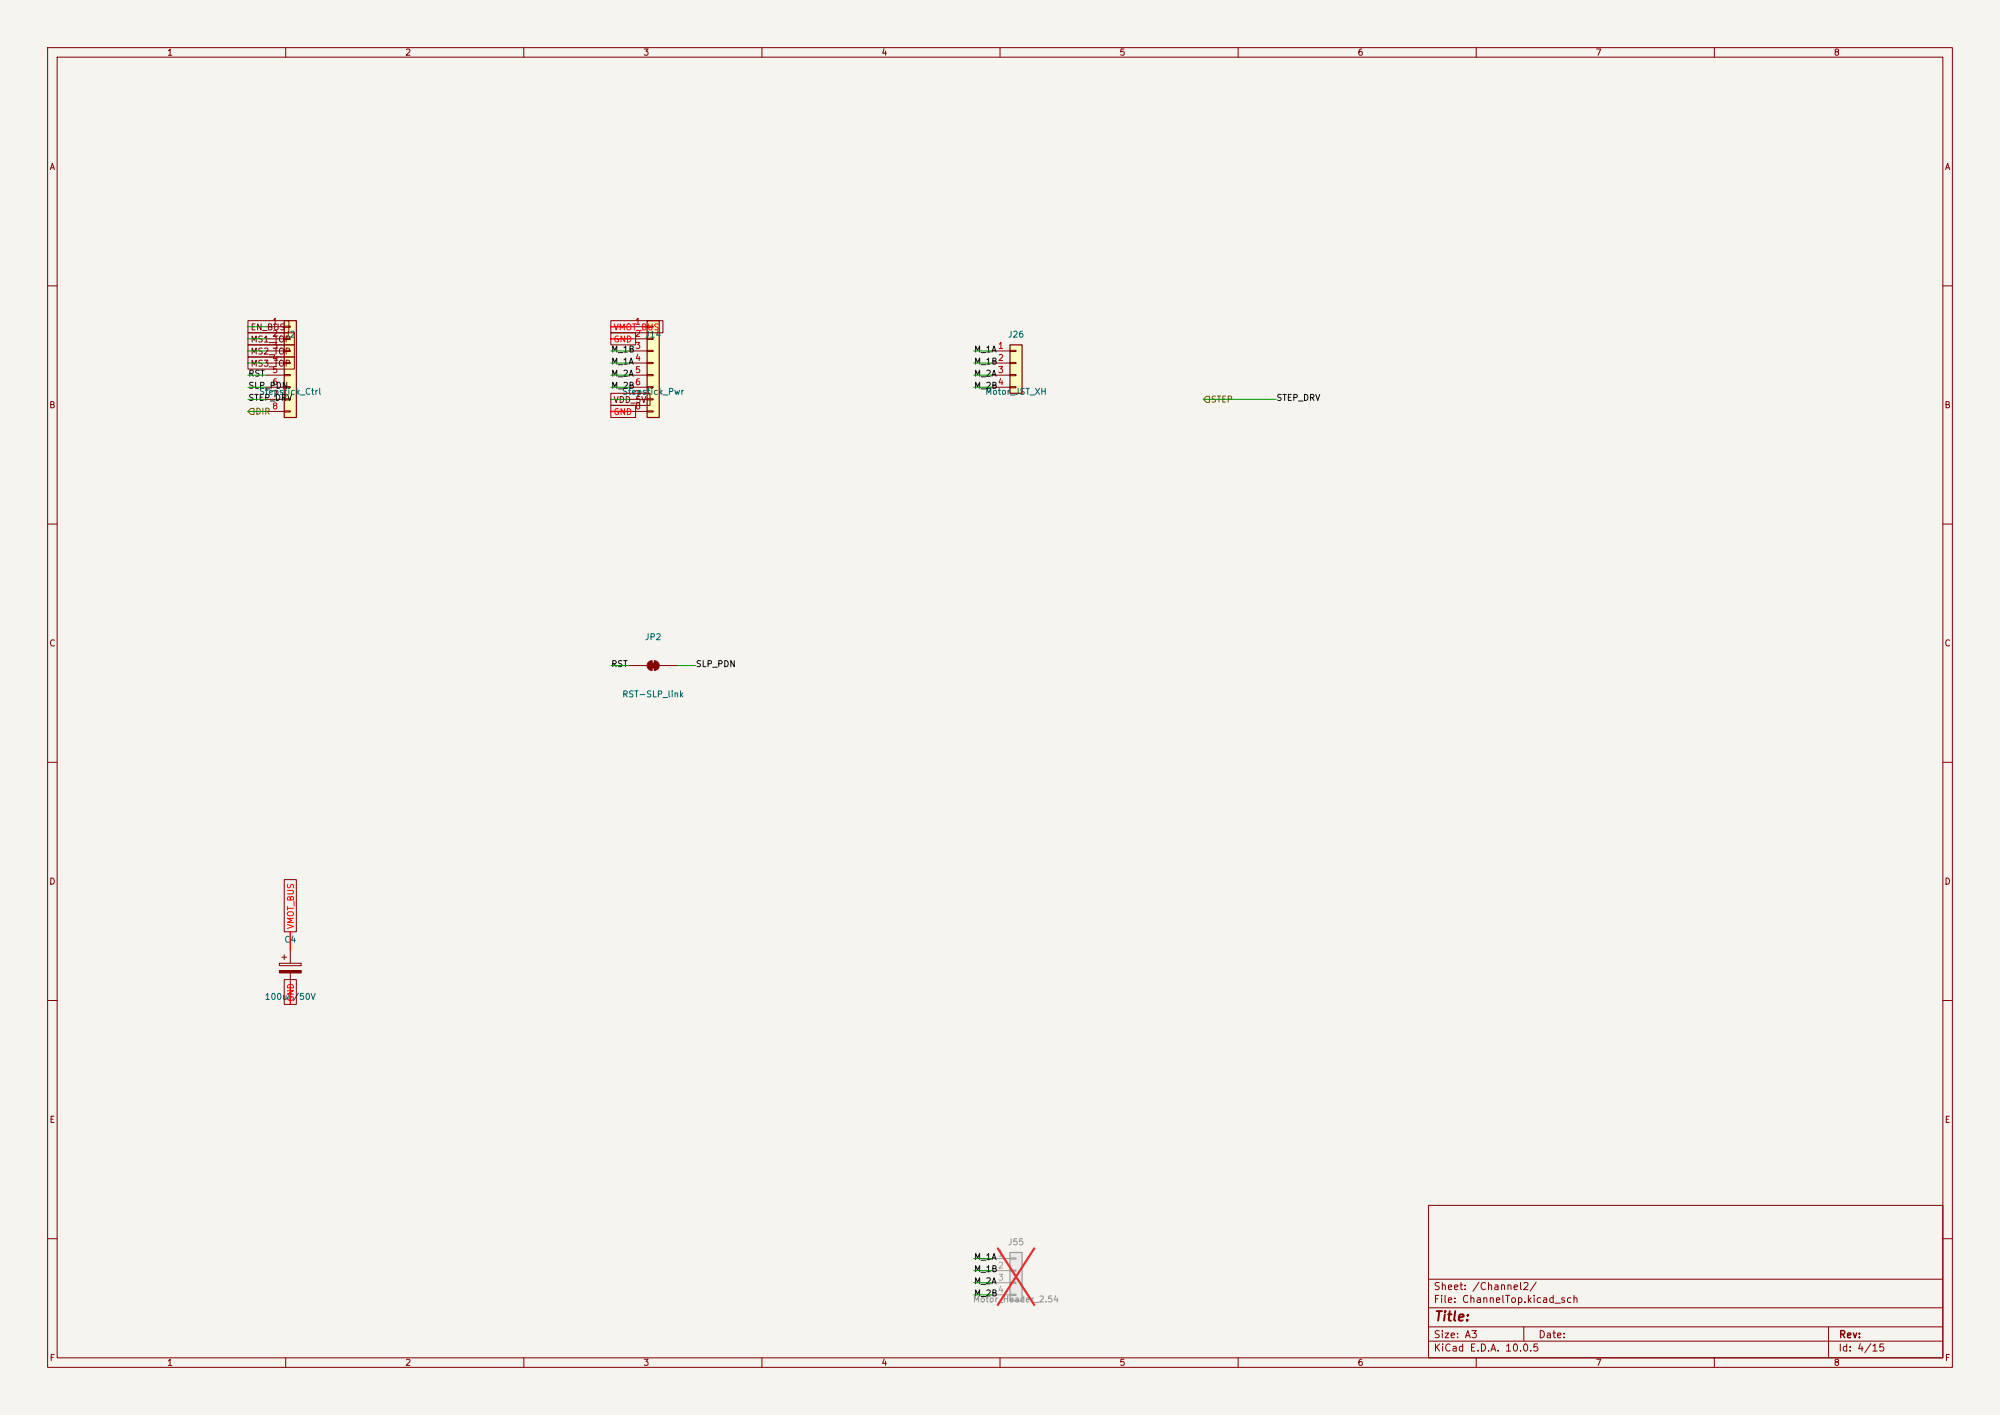
[picture p27: page 4]

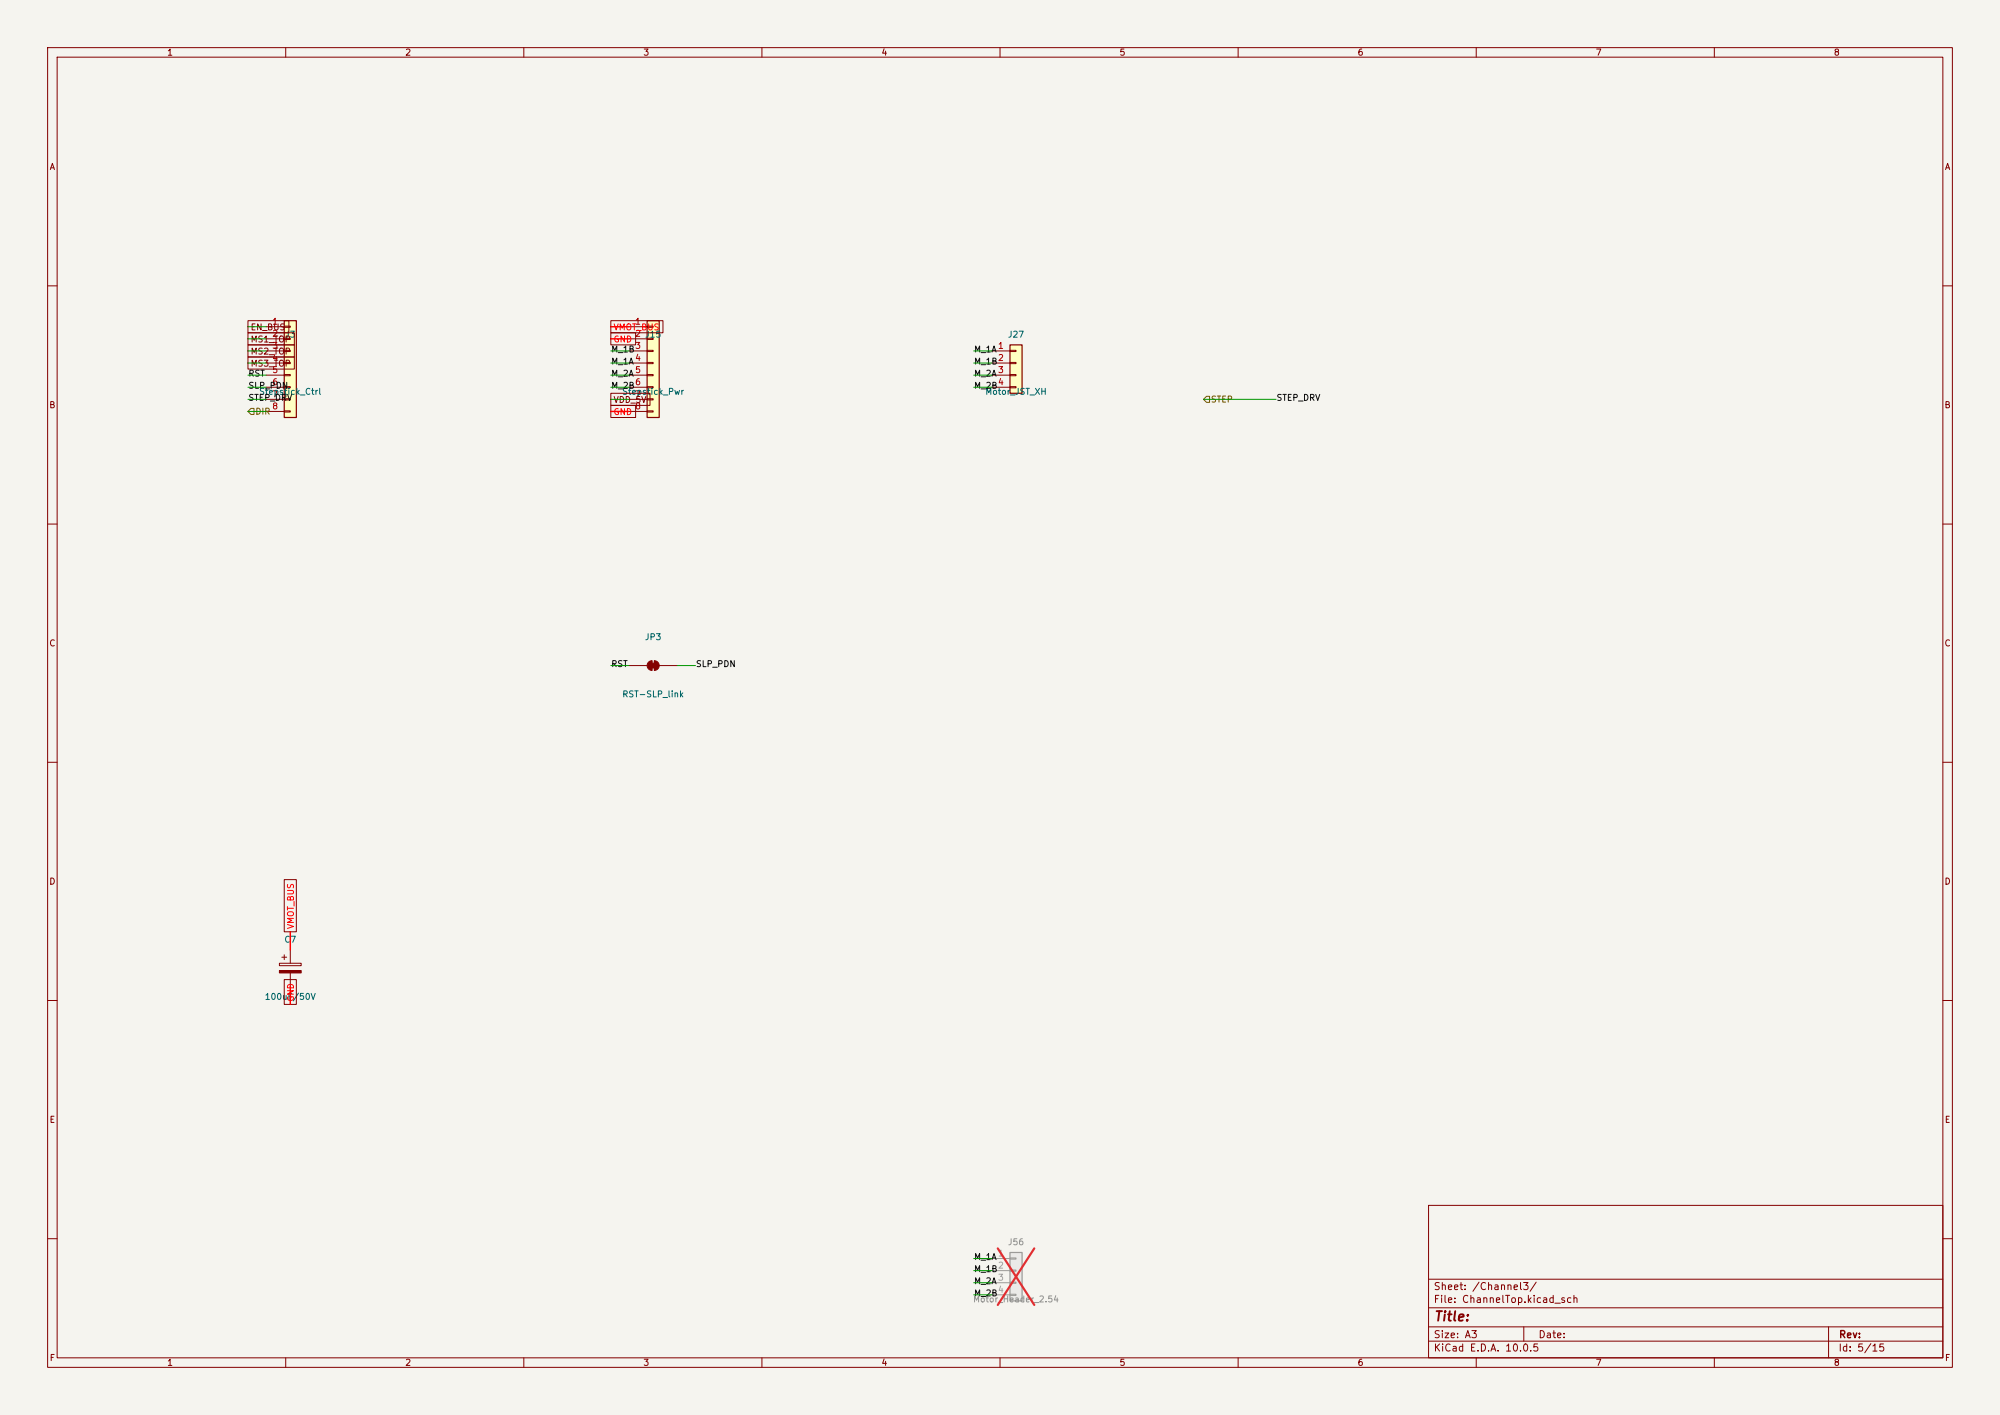
[picture p28: page 5]

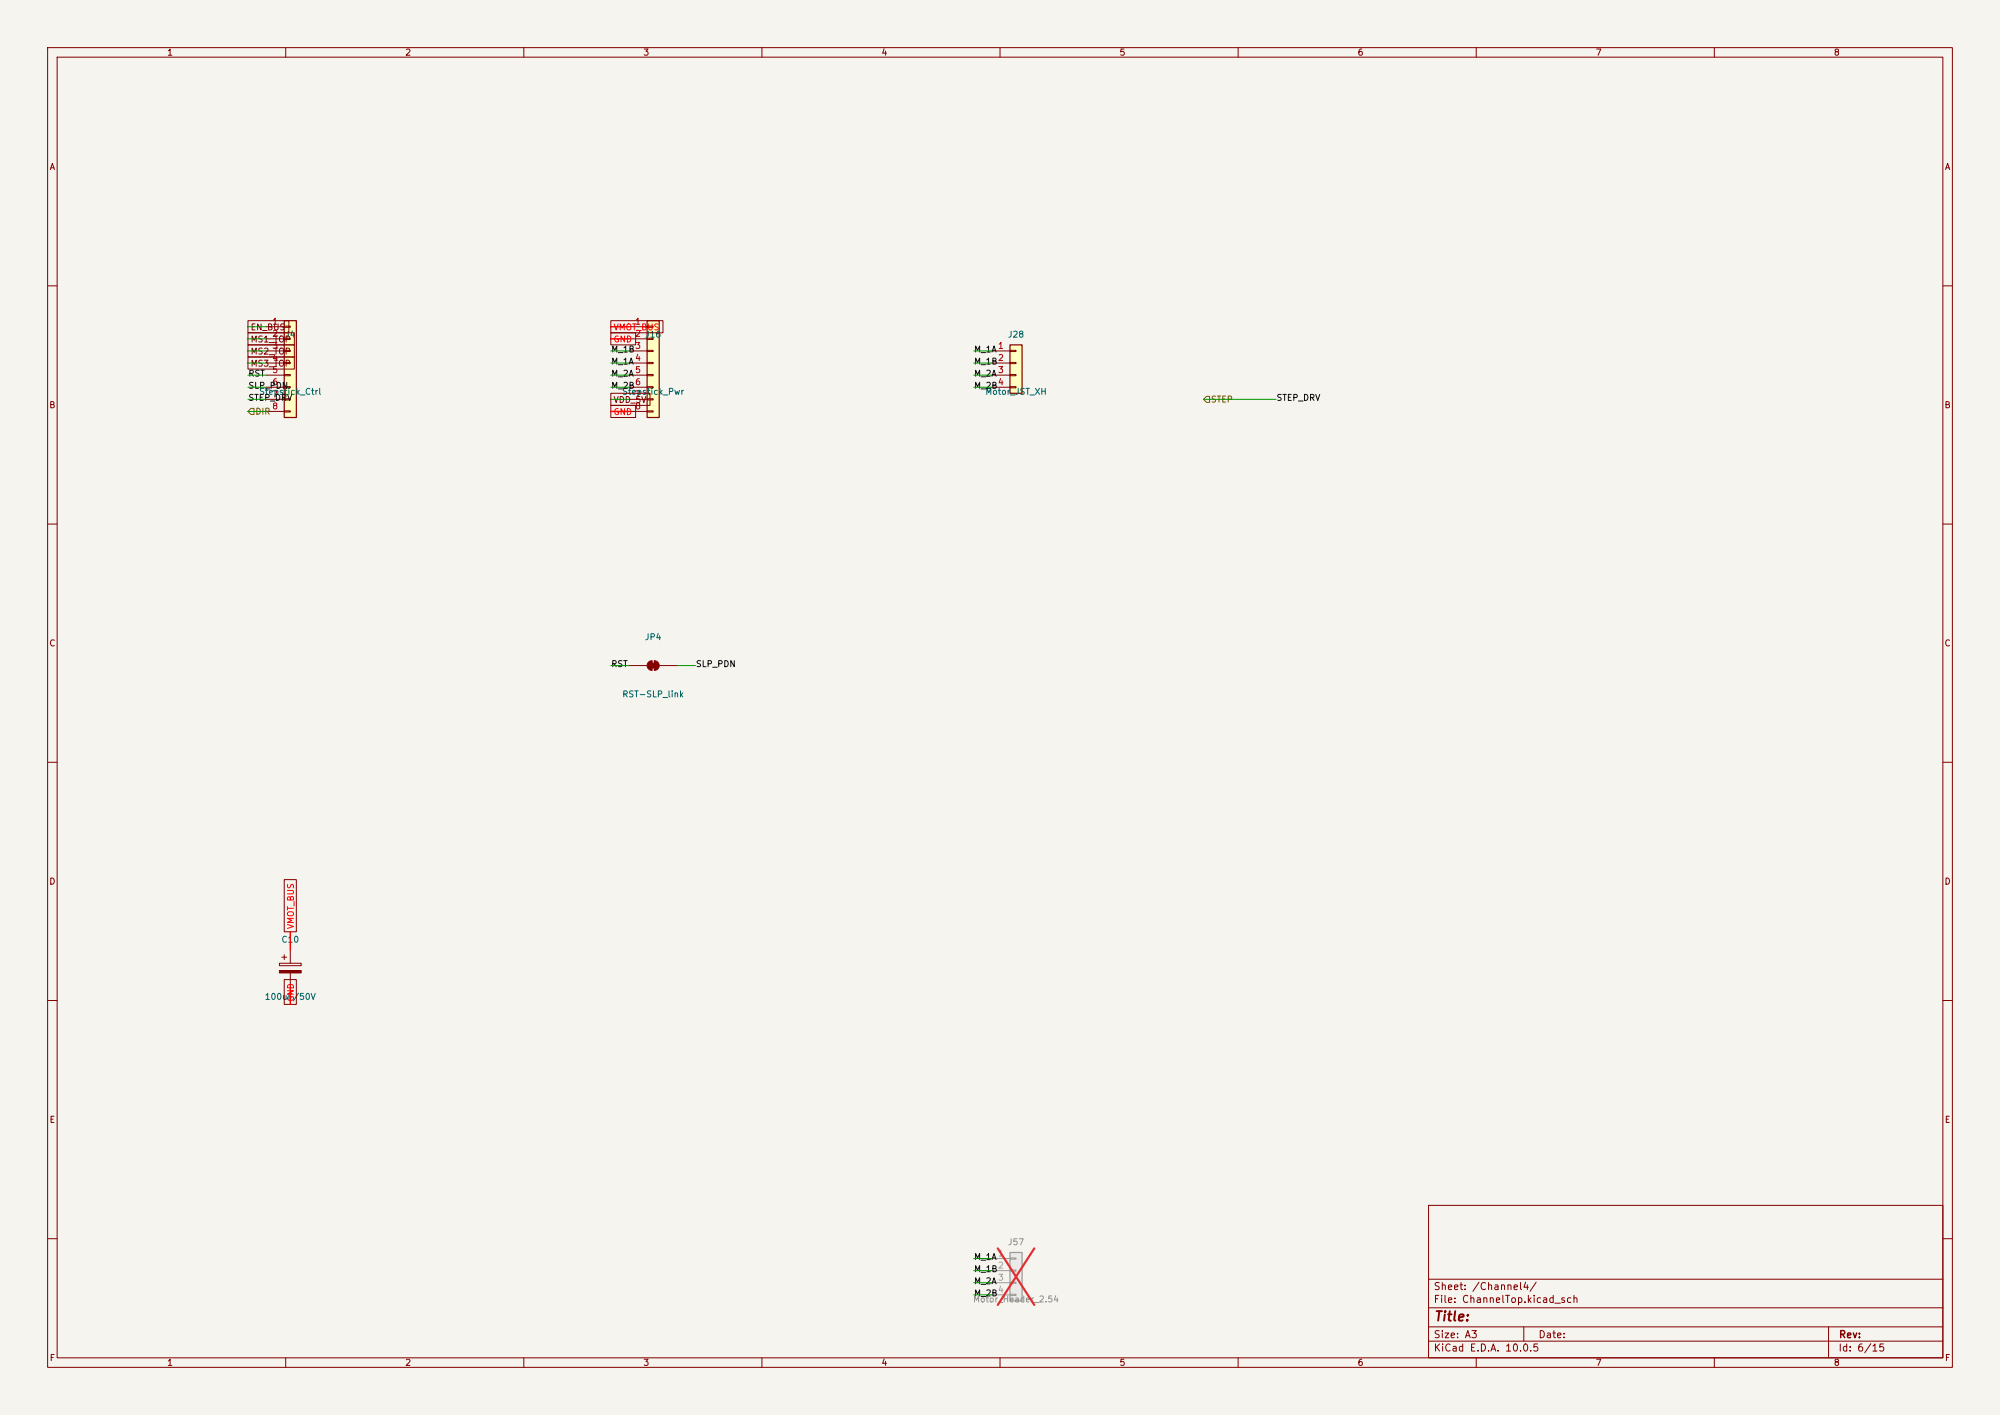
[picture p29: page 6]

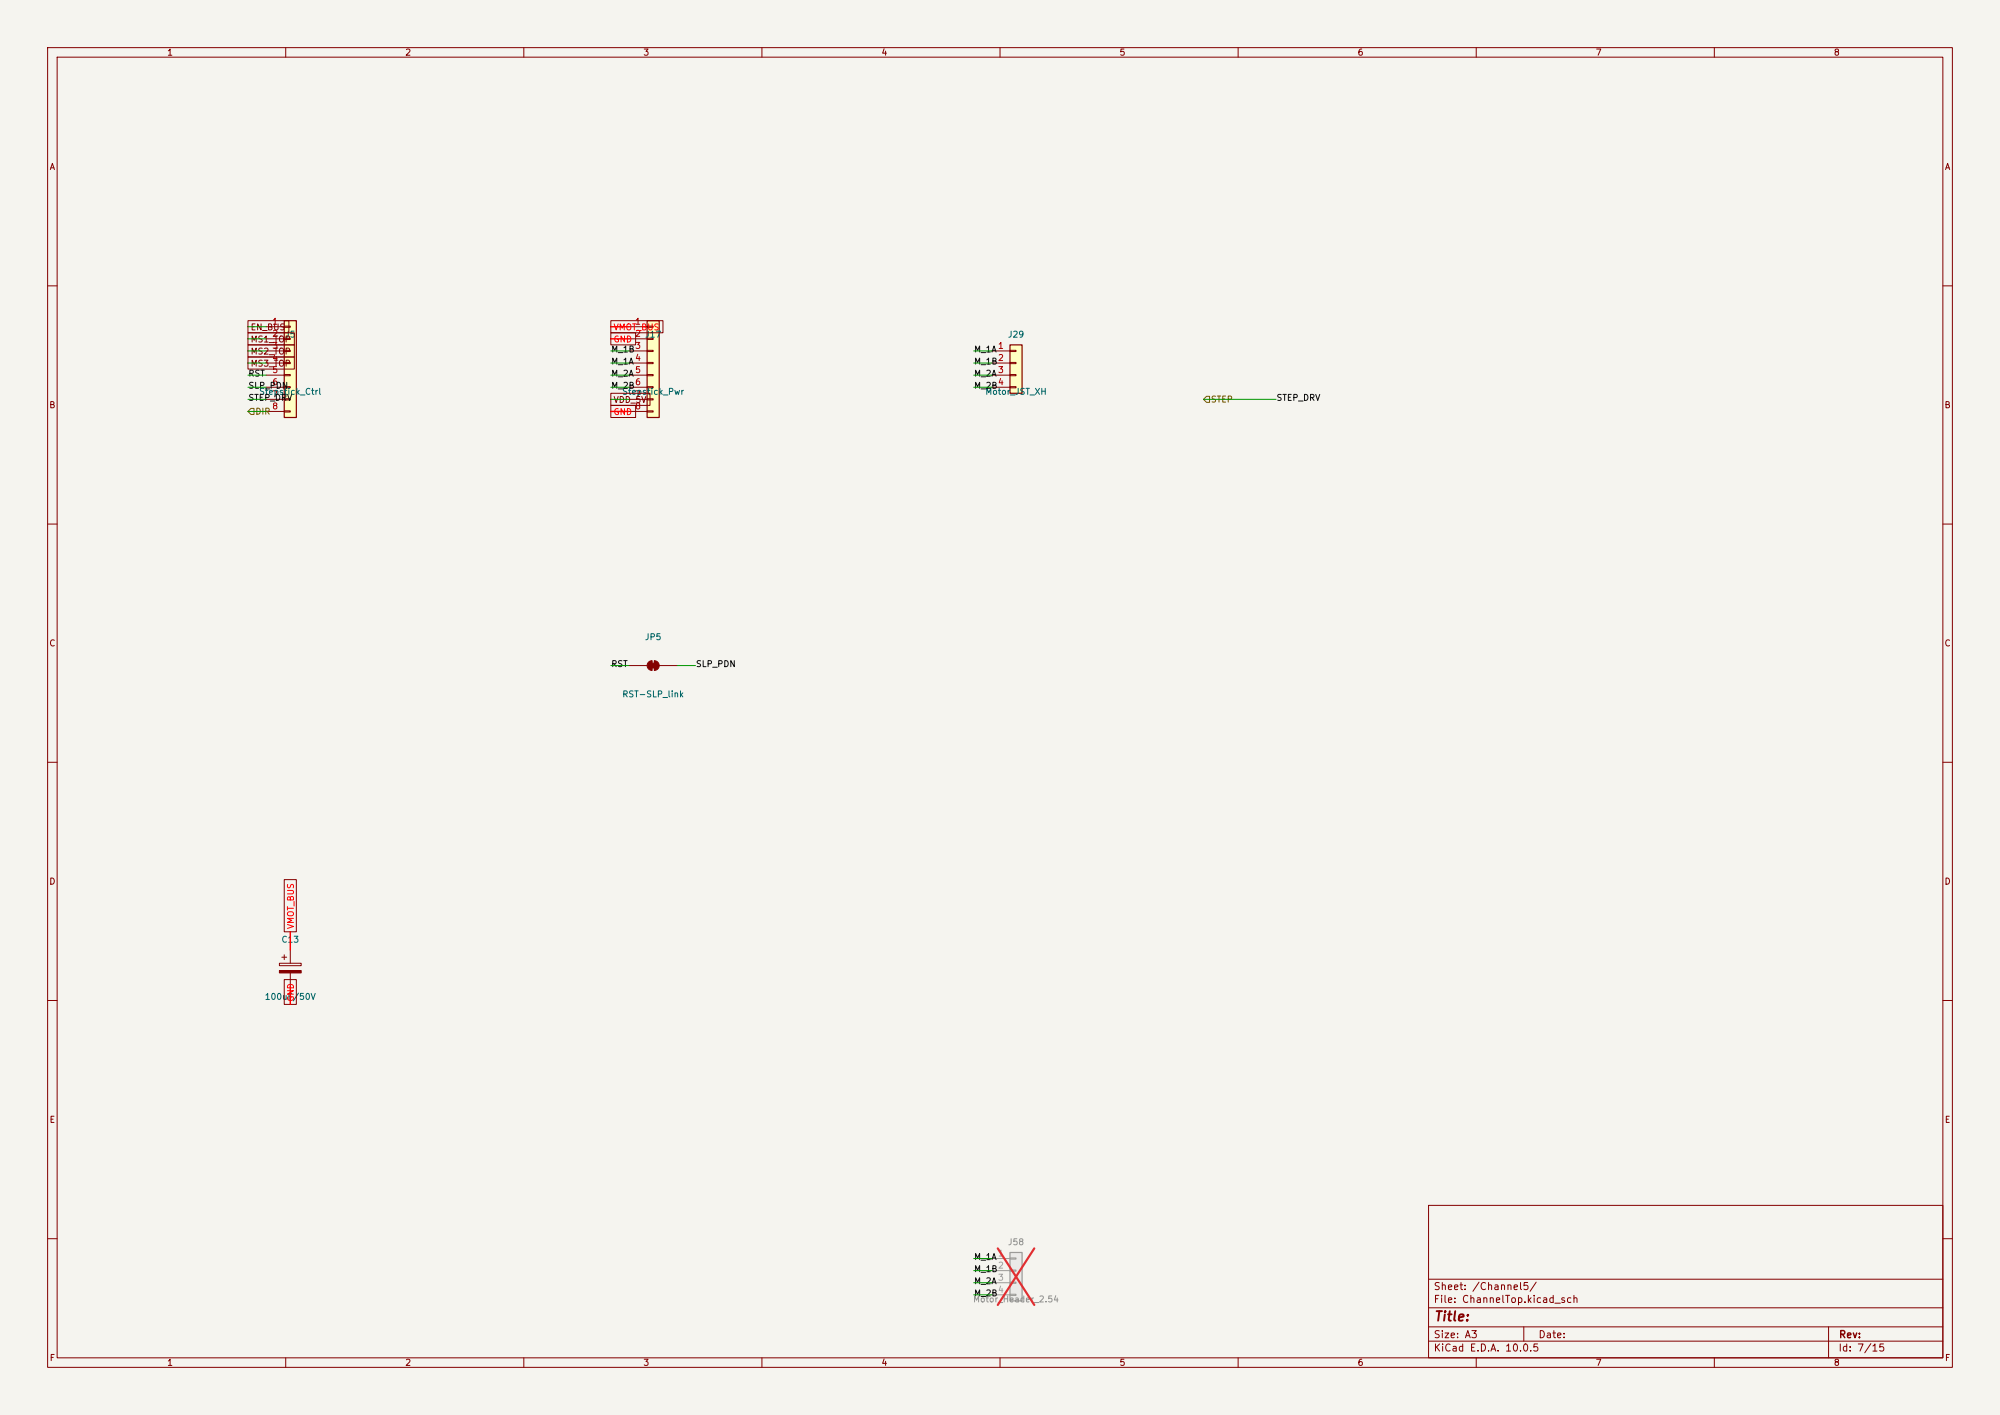
[picture p30: page 7]

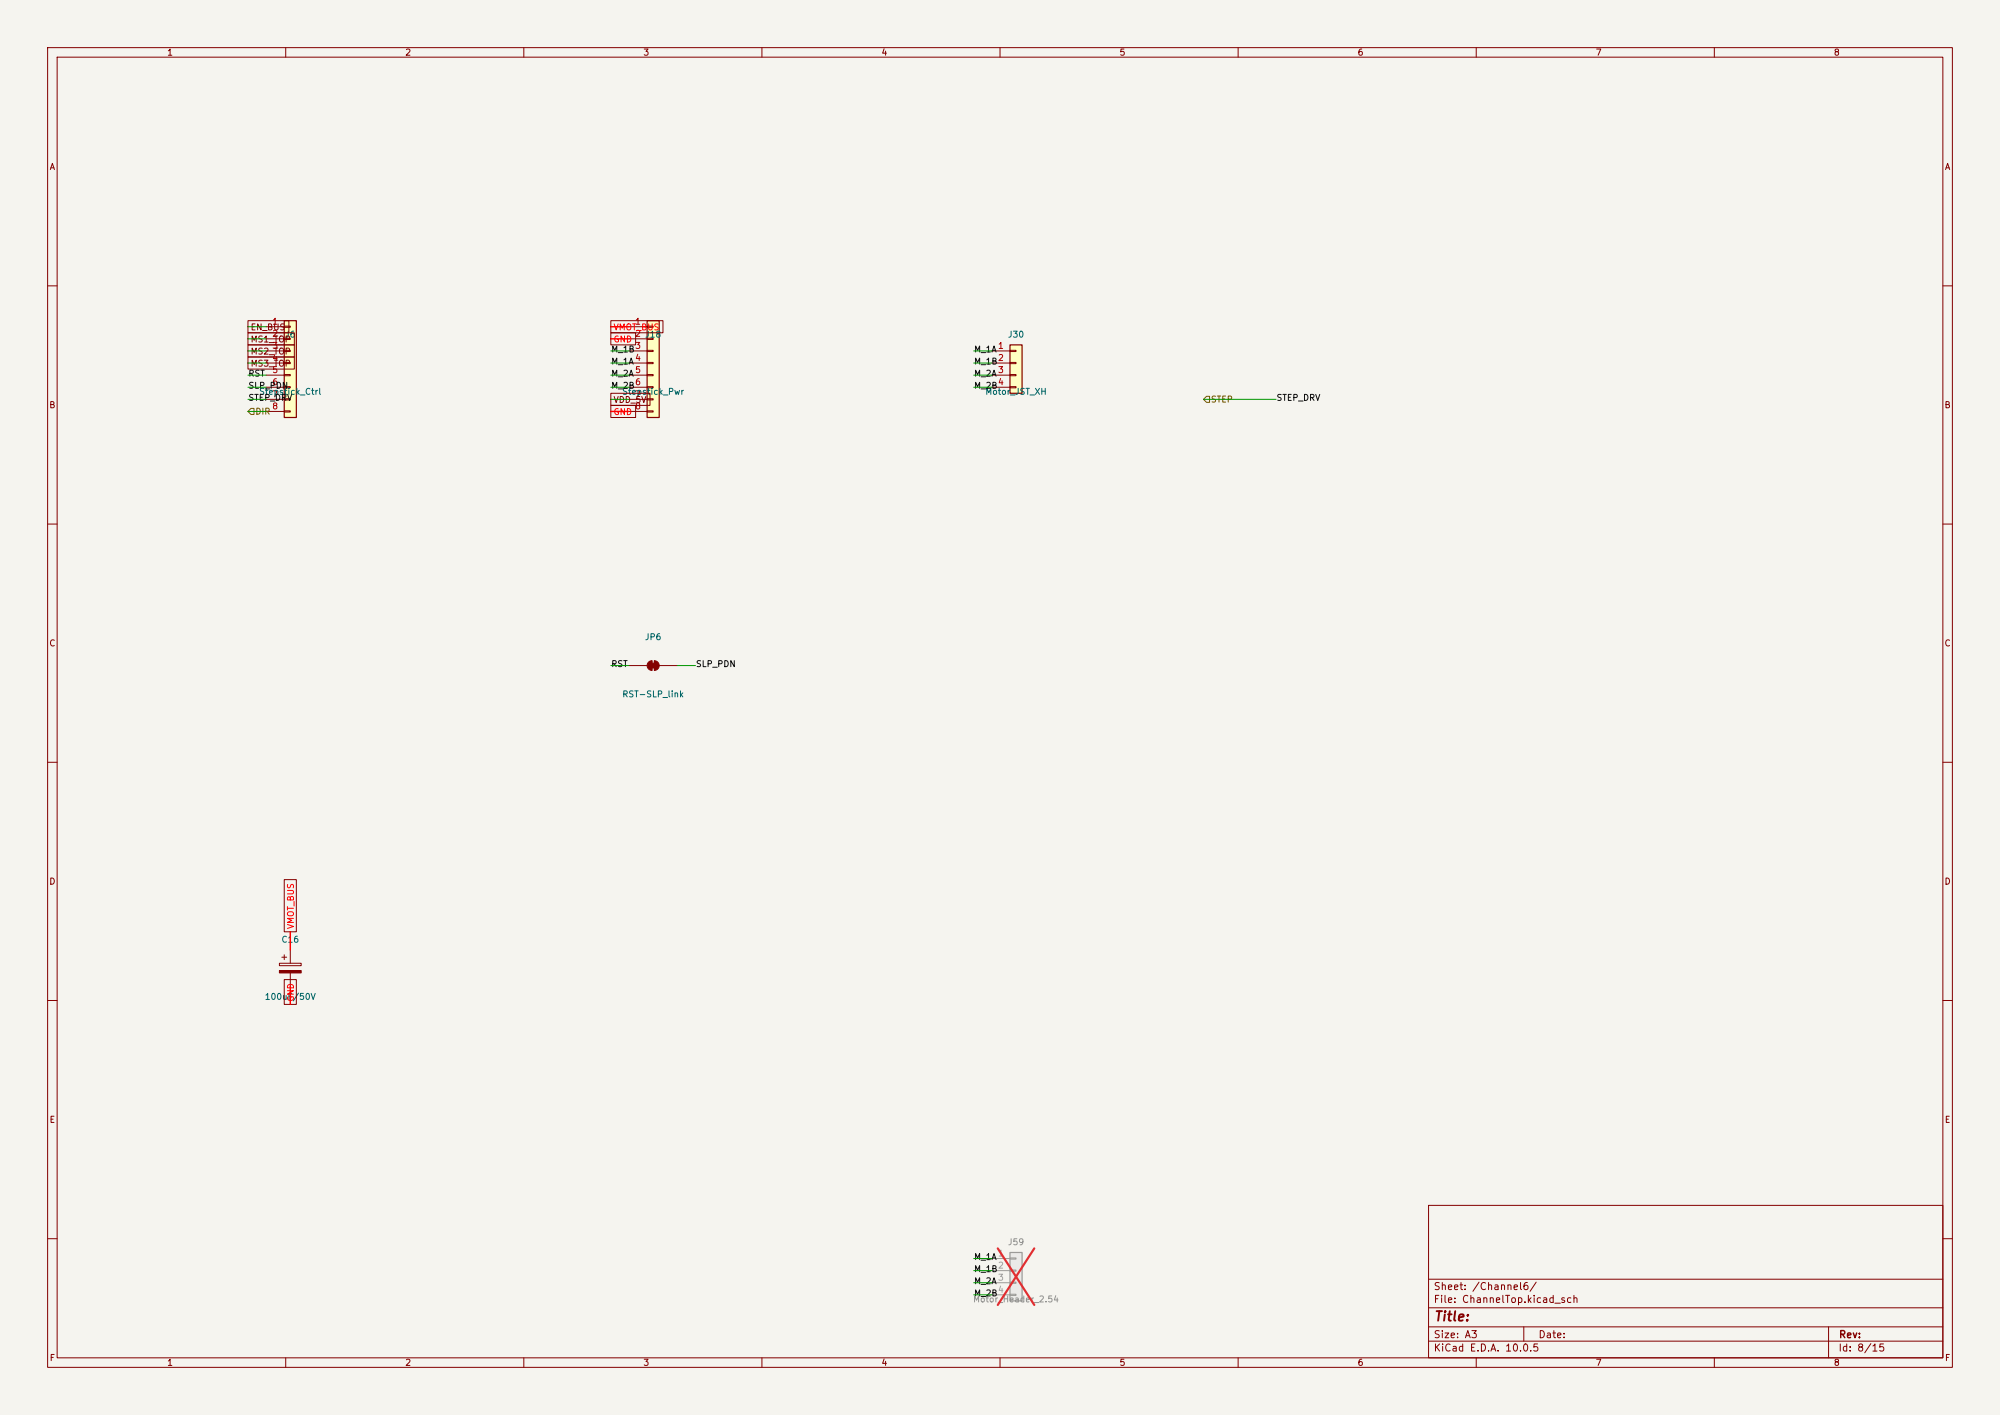
[picture p31: page 8]

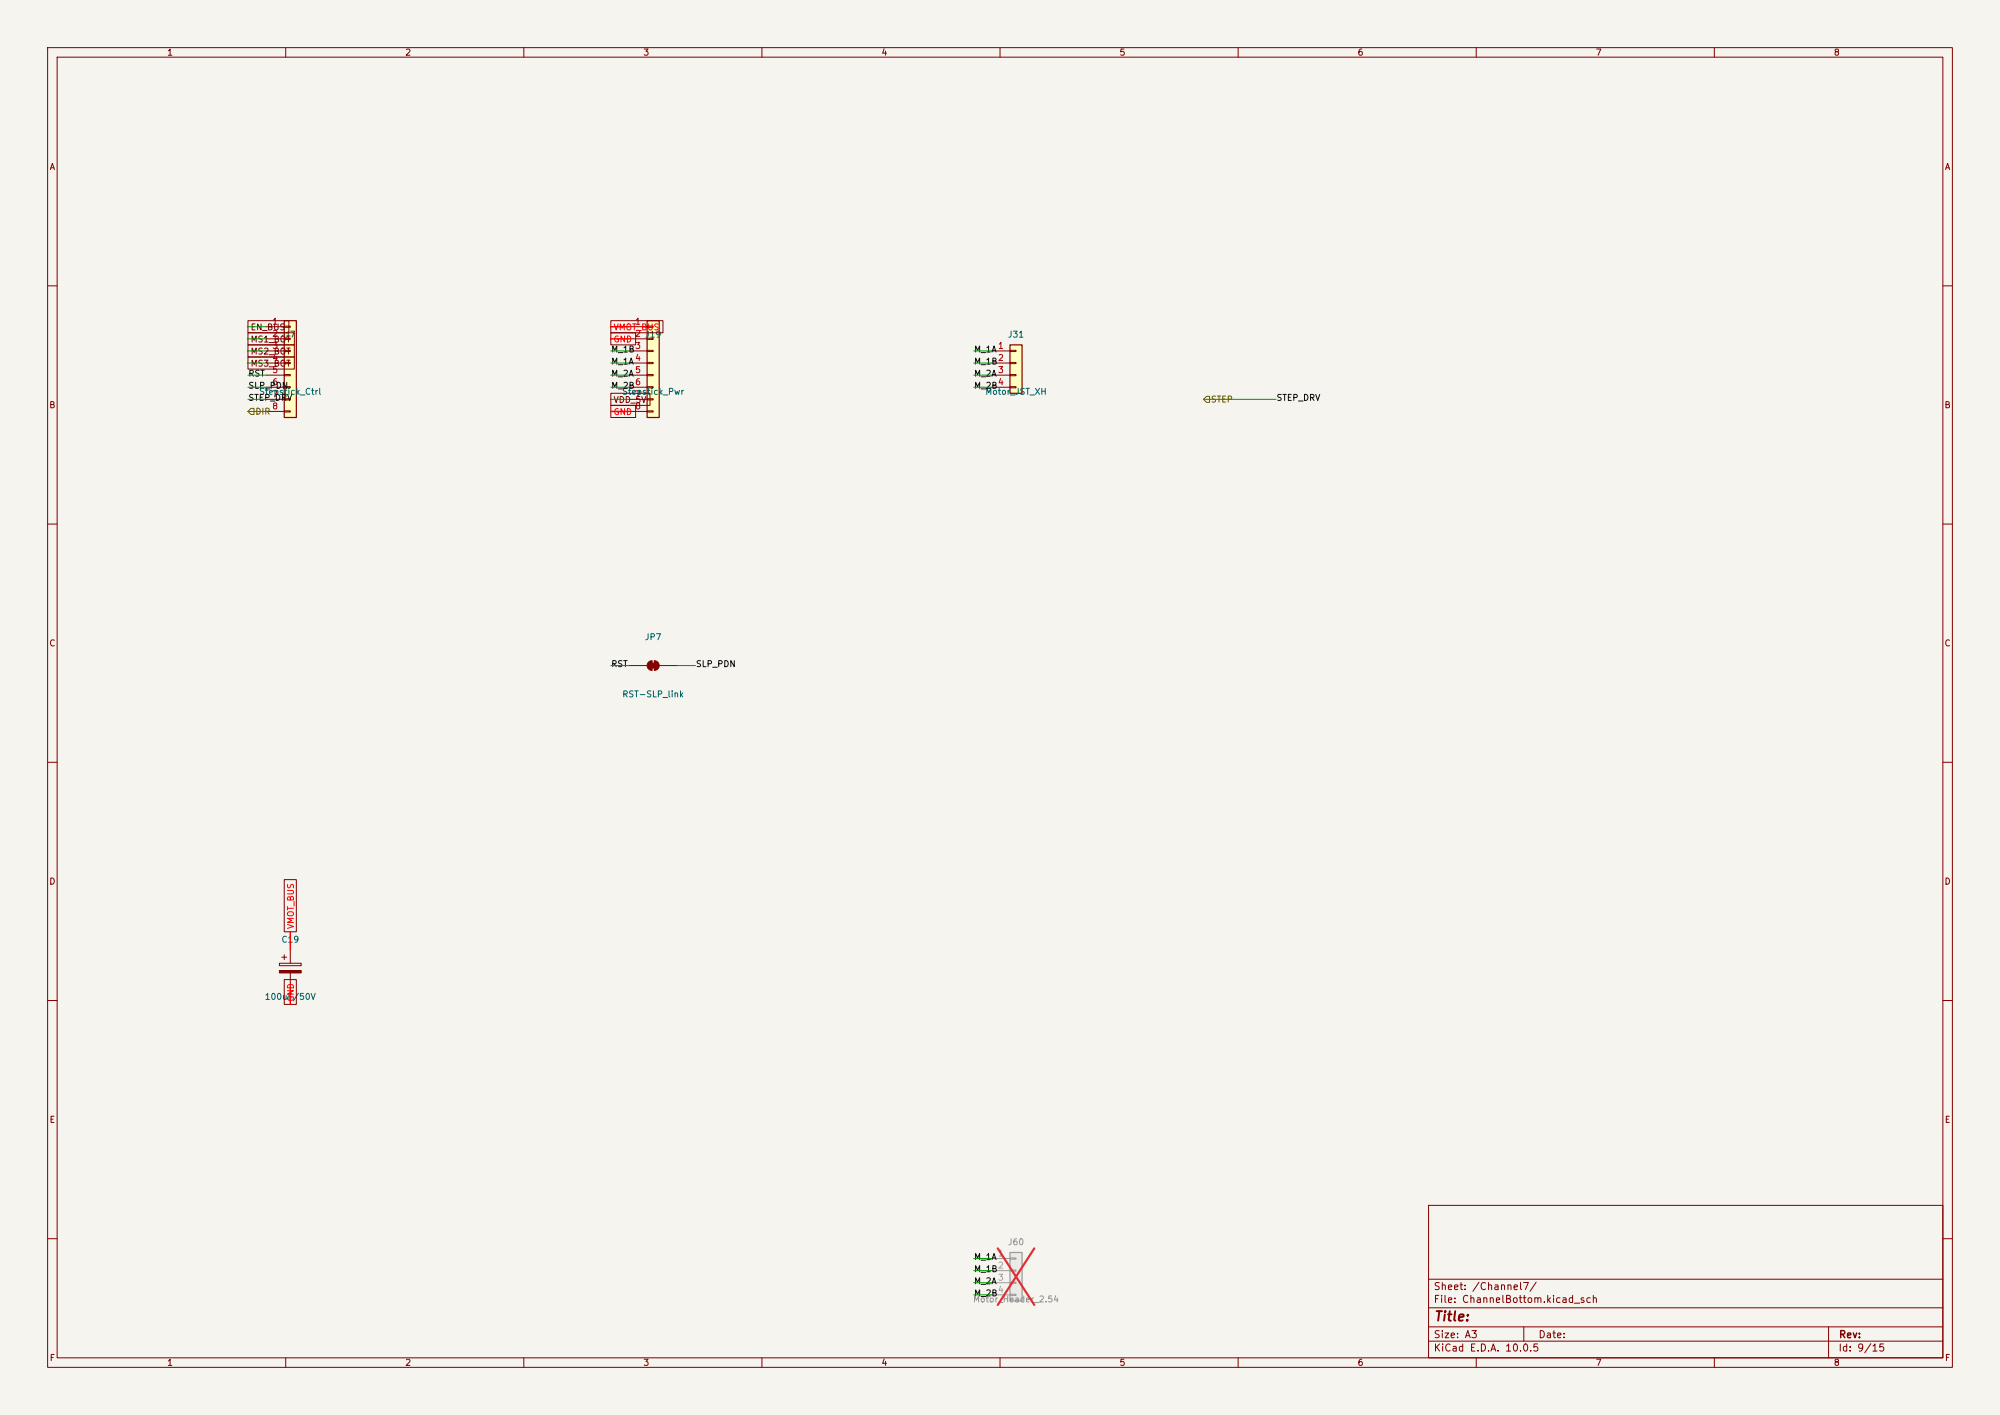
[picture p32: page 9]

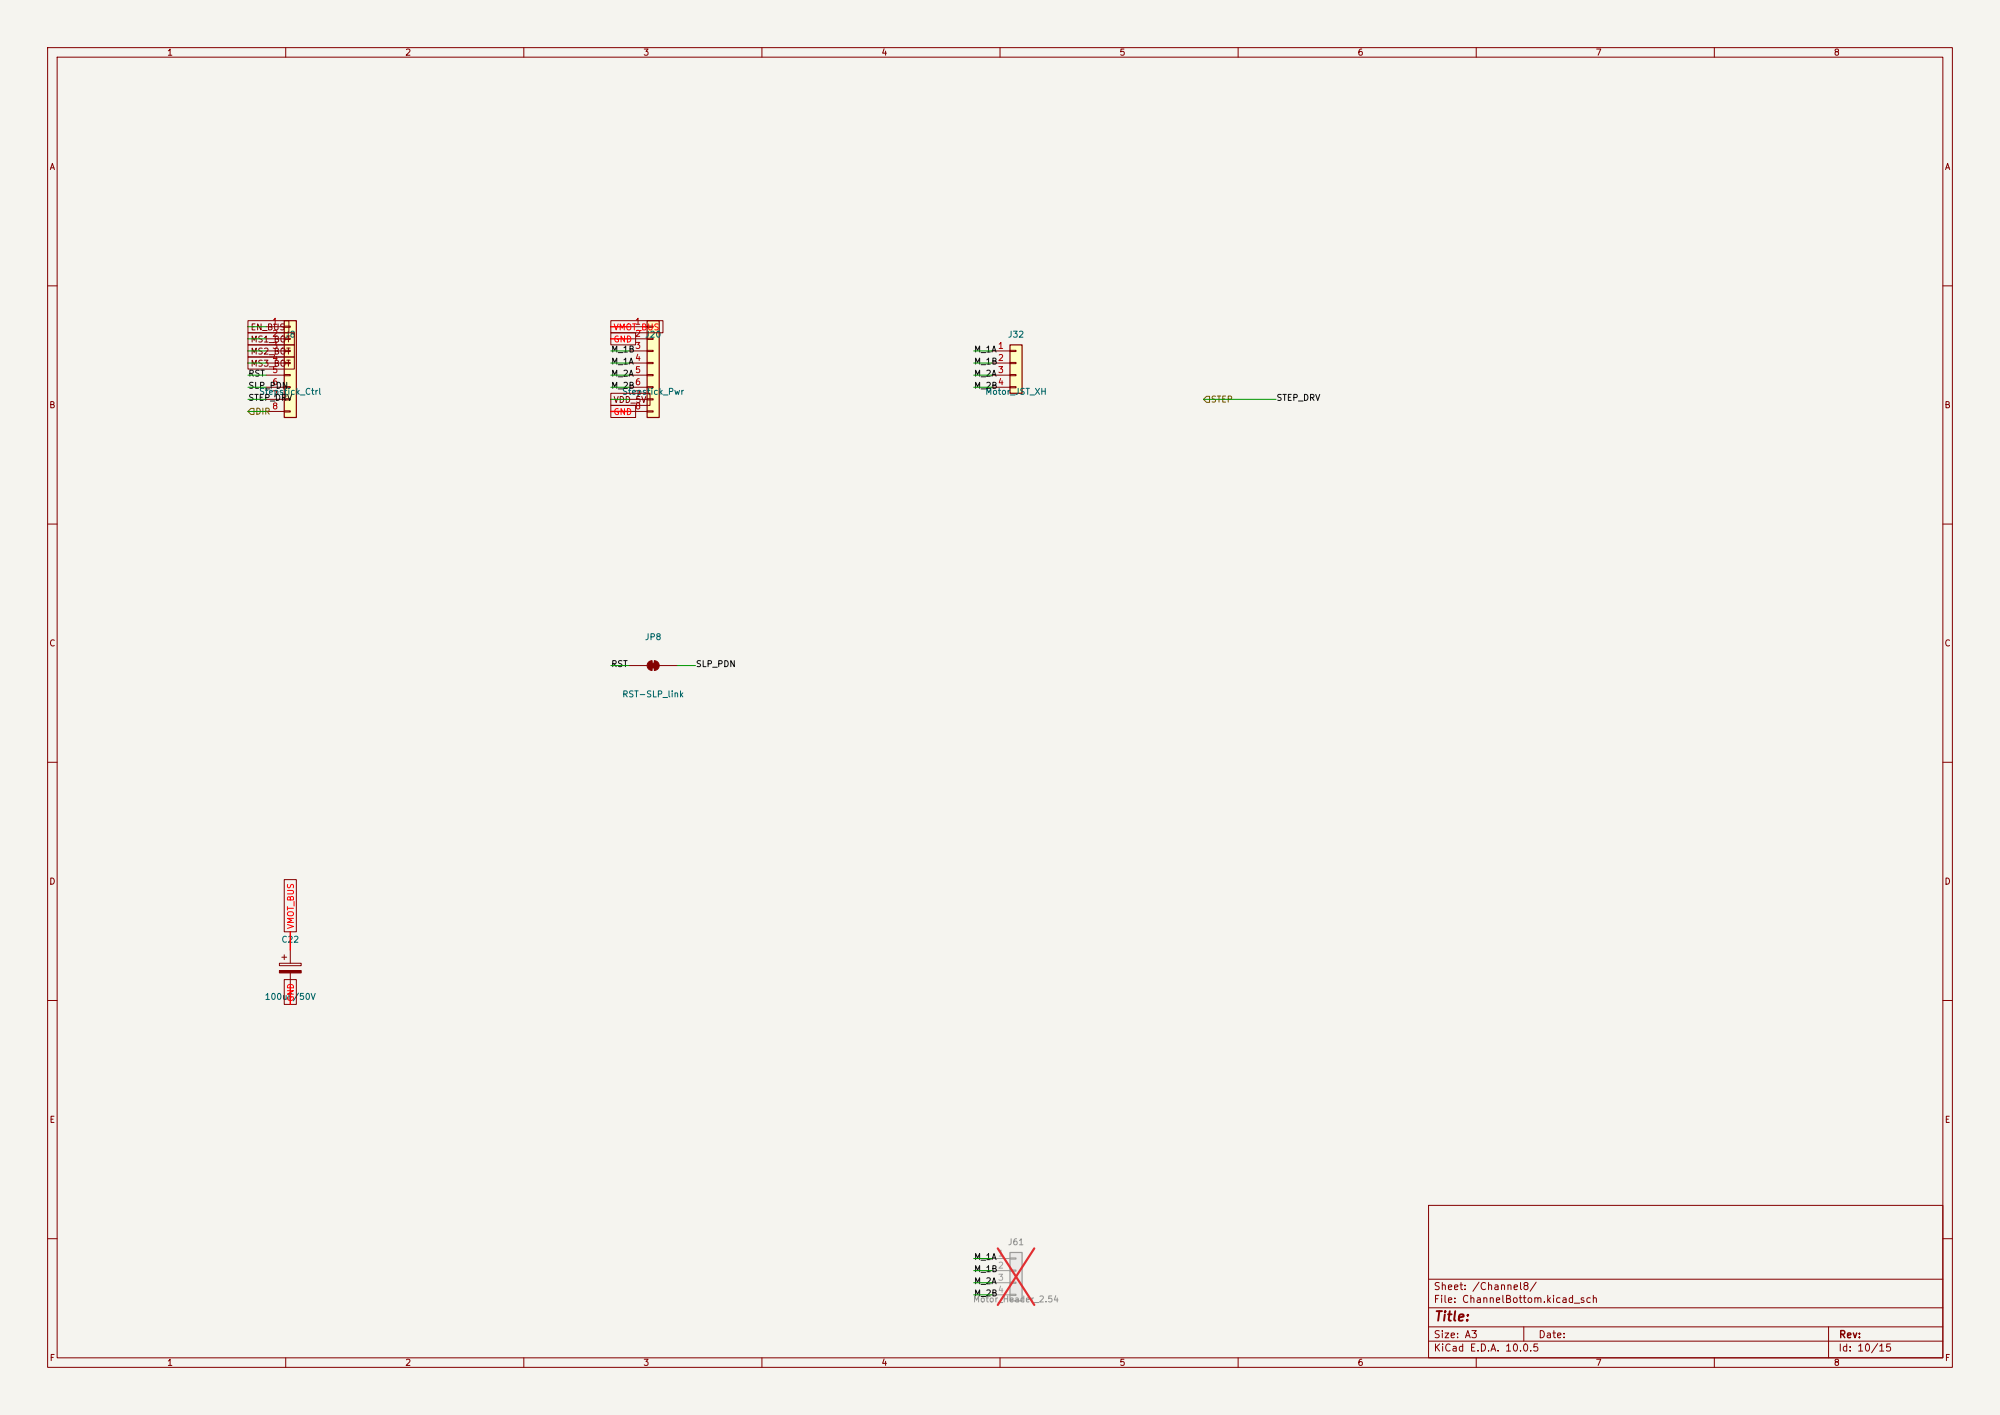
[picture p33: page 10]

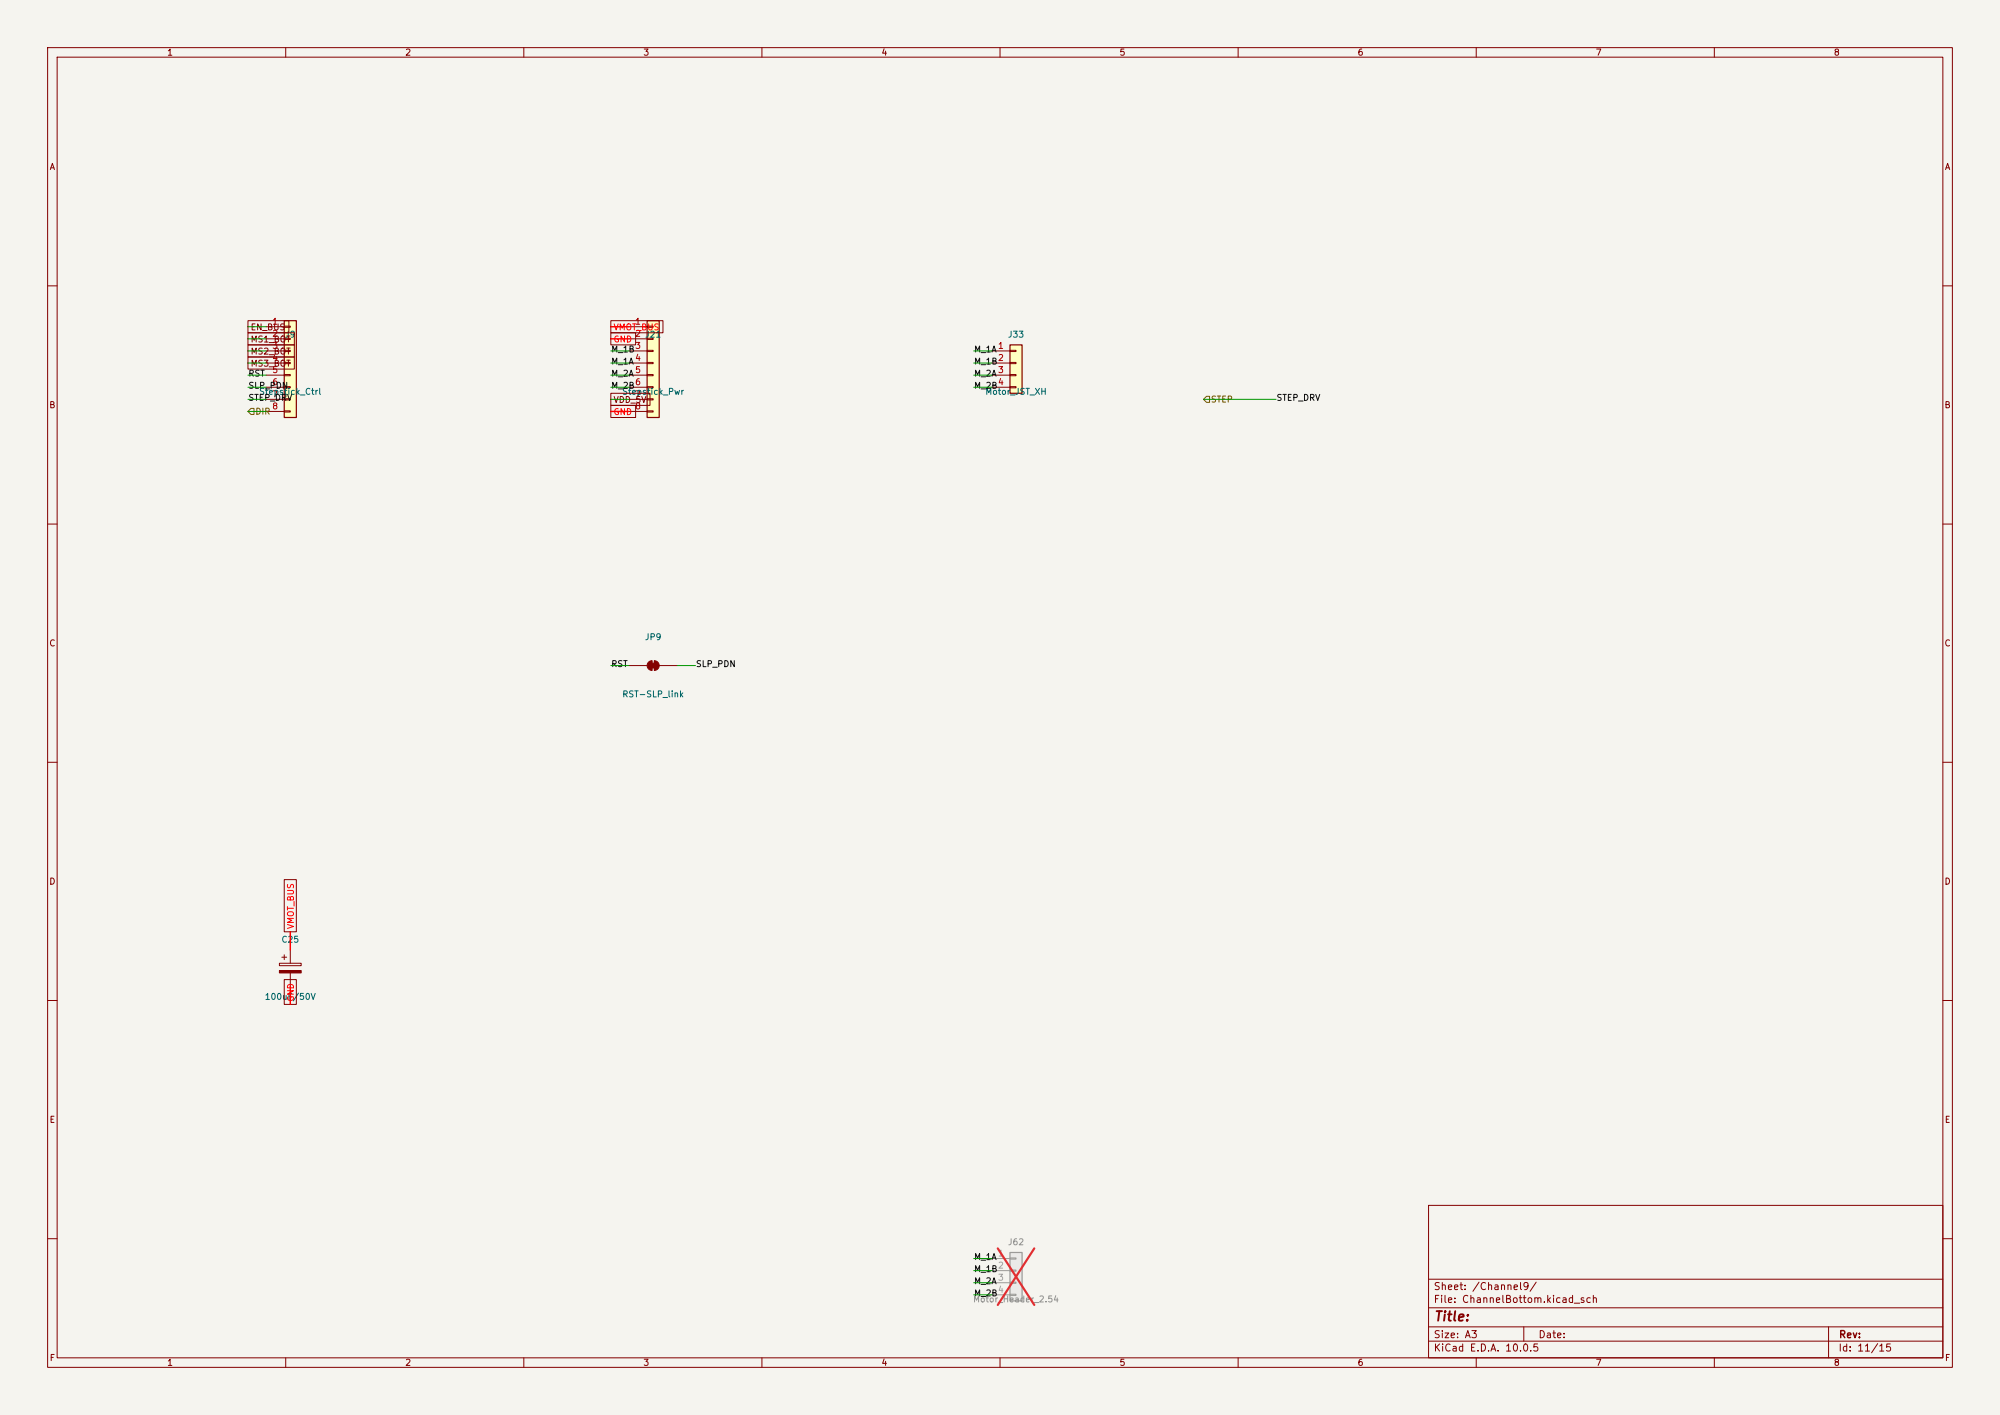
[picture p34: page 11]

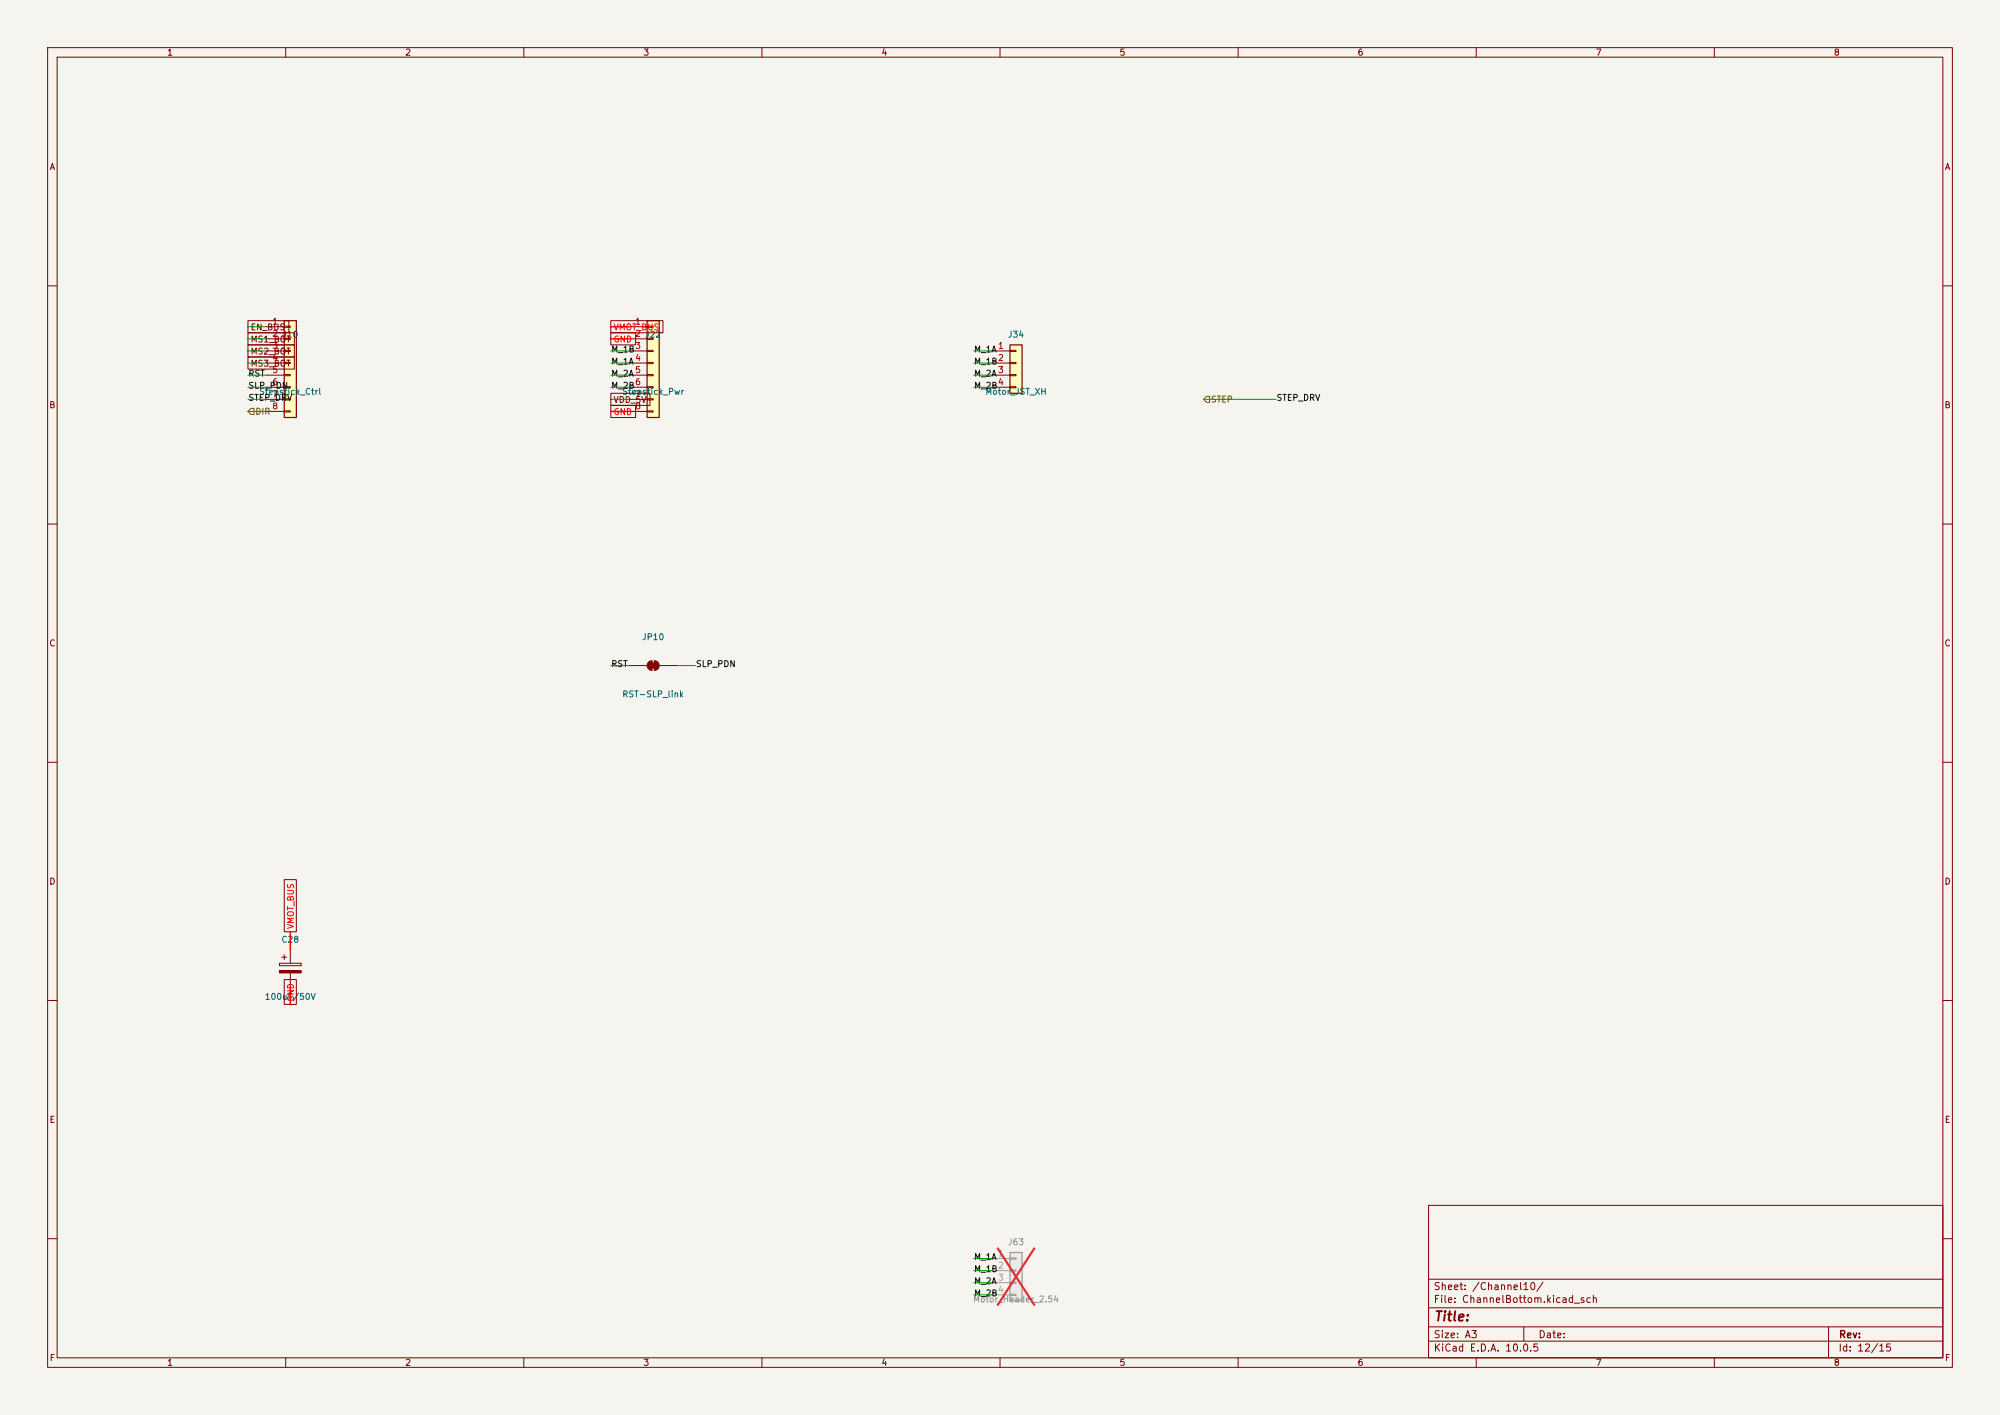
[picture p35: page 12]

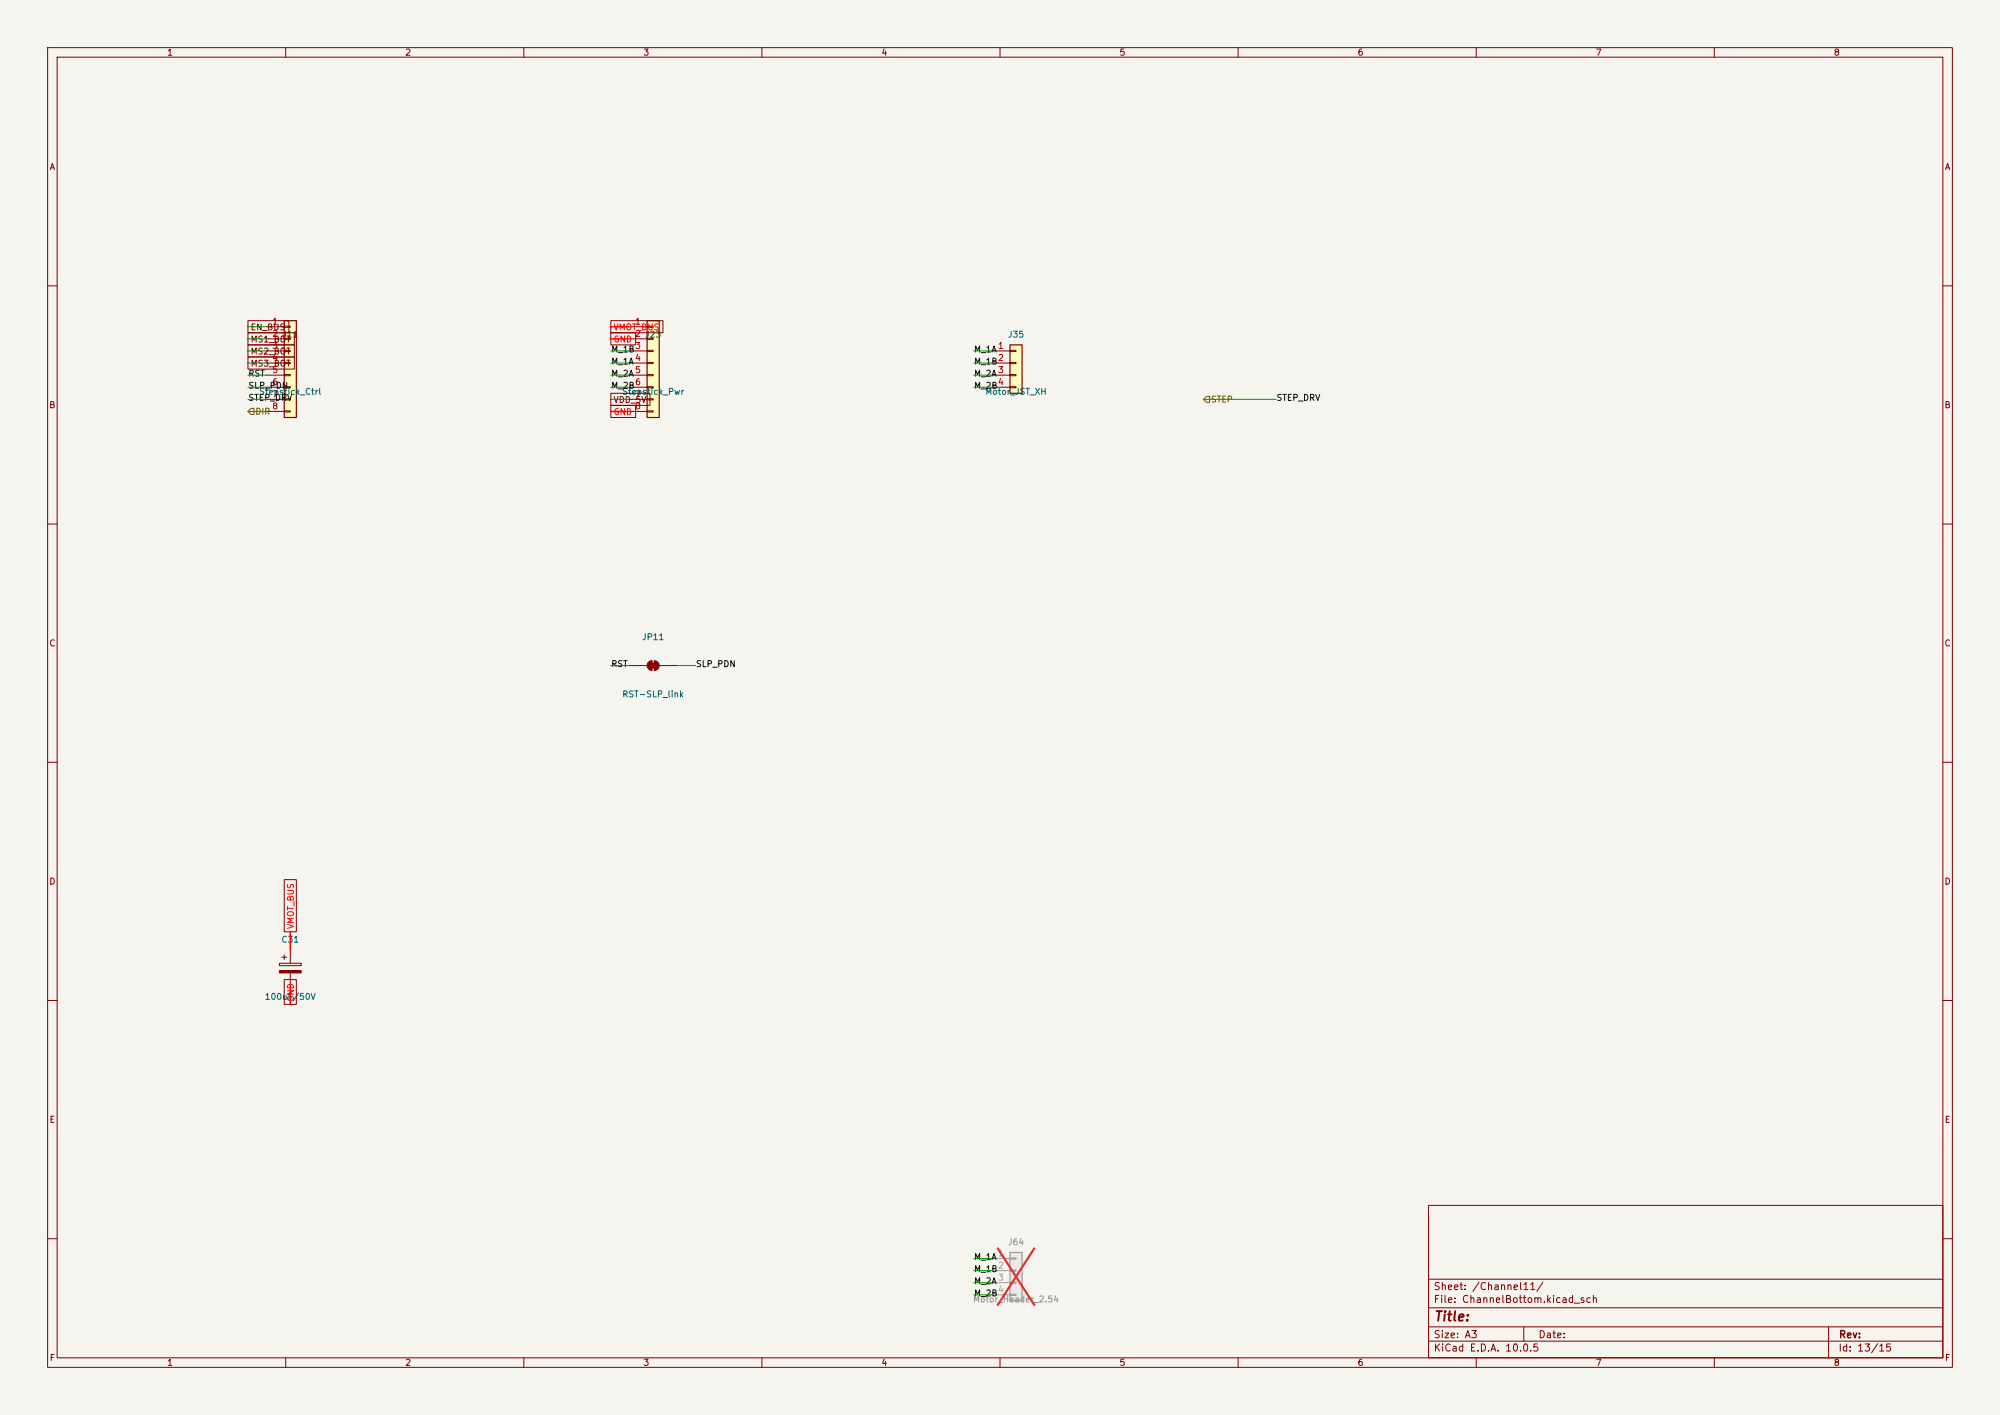
[picture p36: page 13]

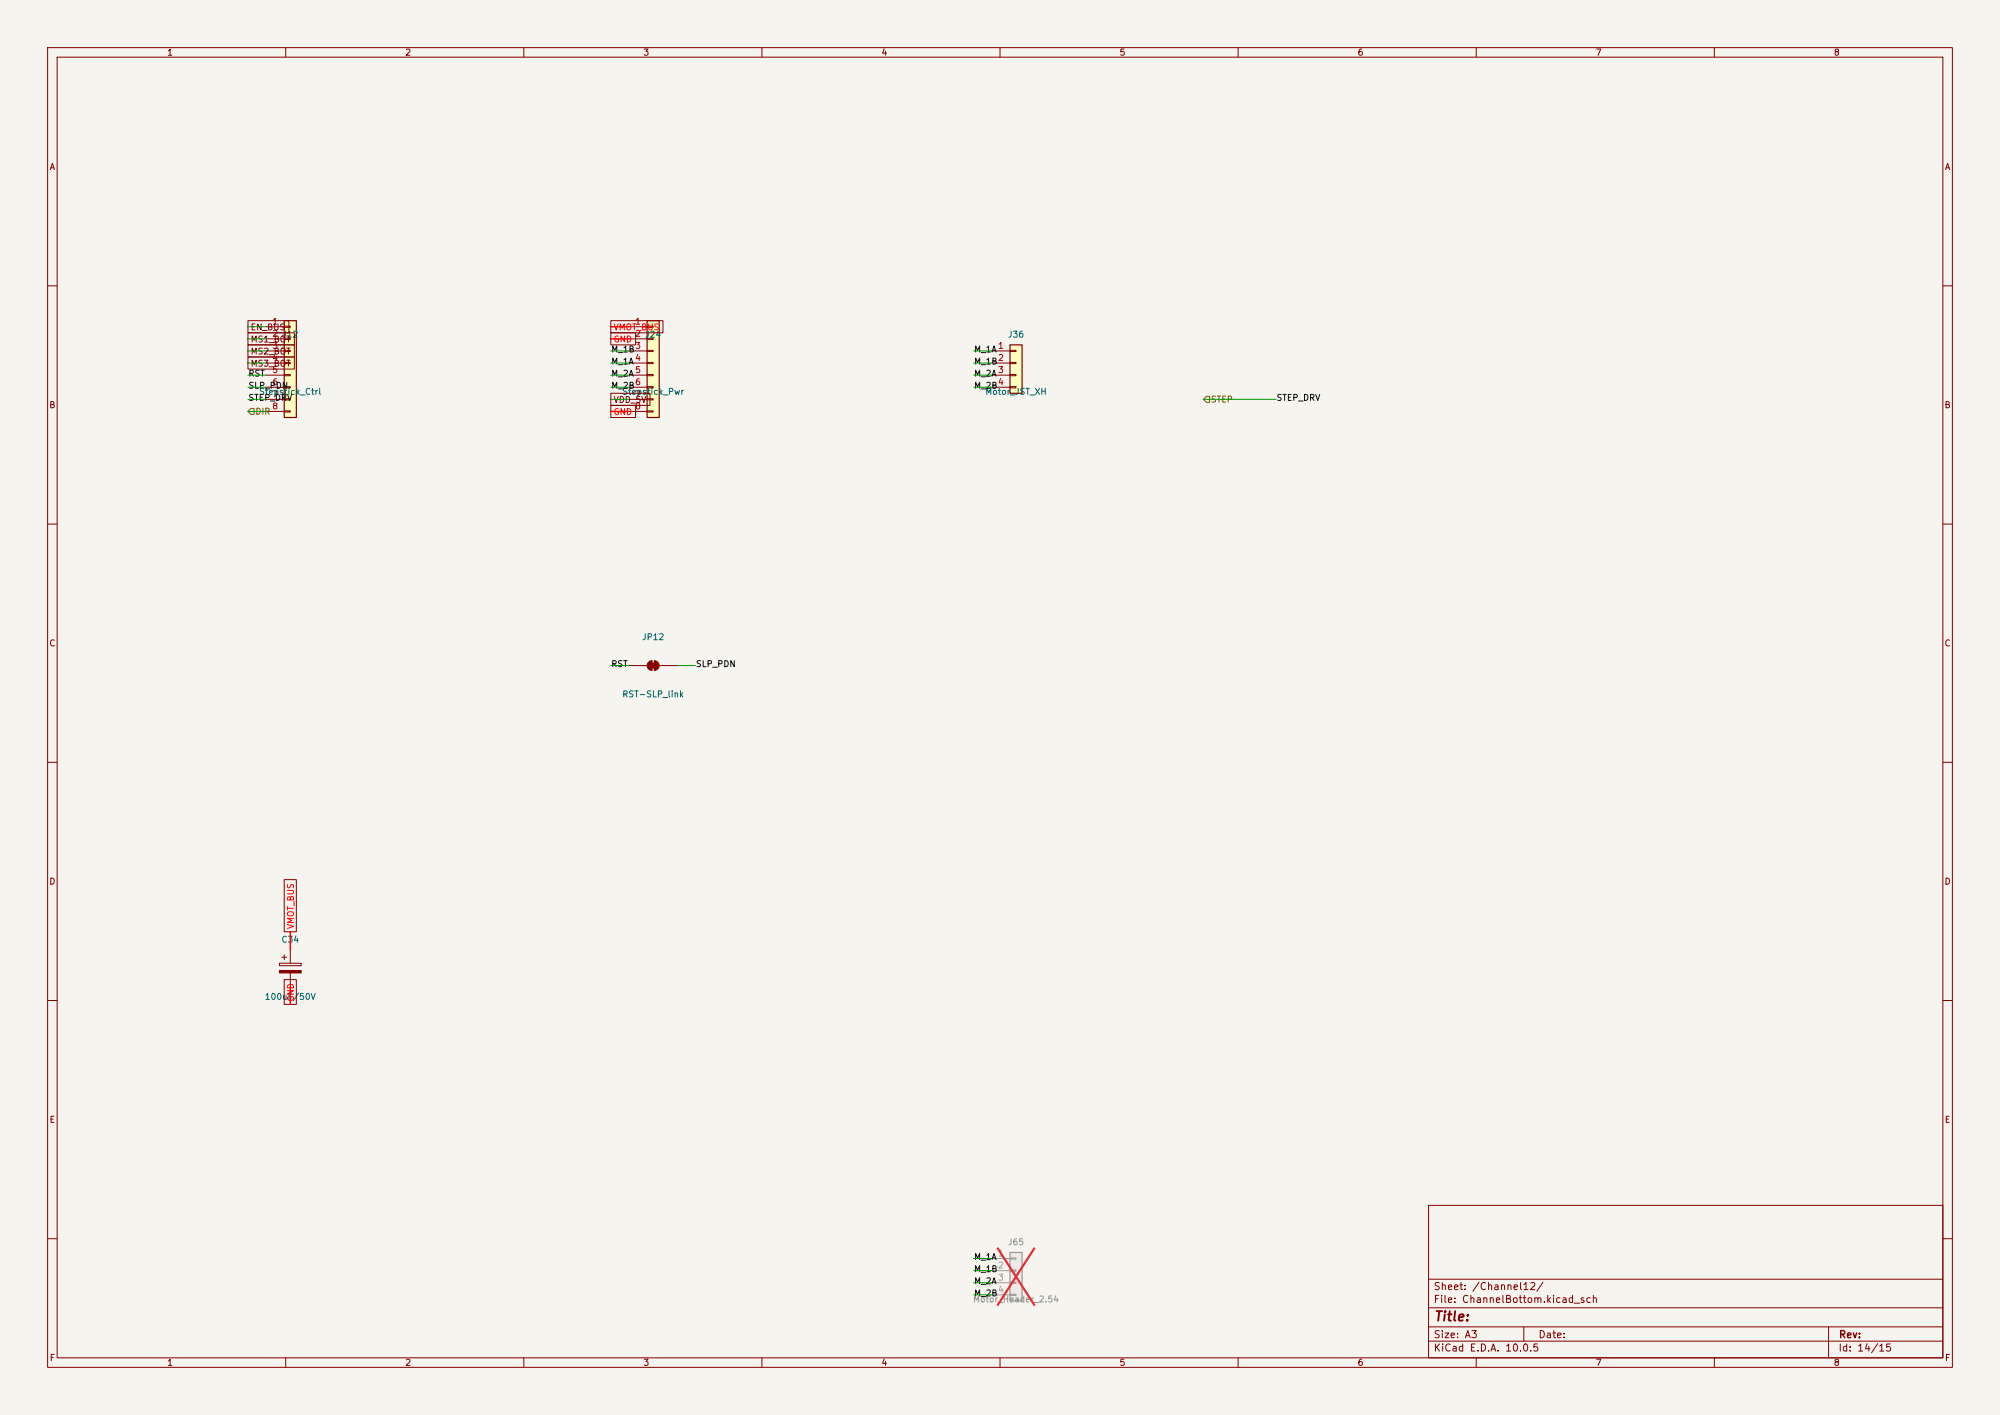
[picture p37: page 14]

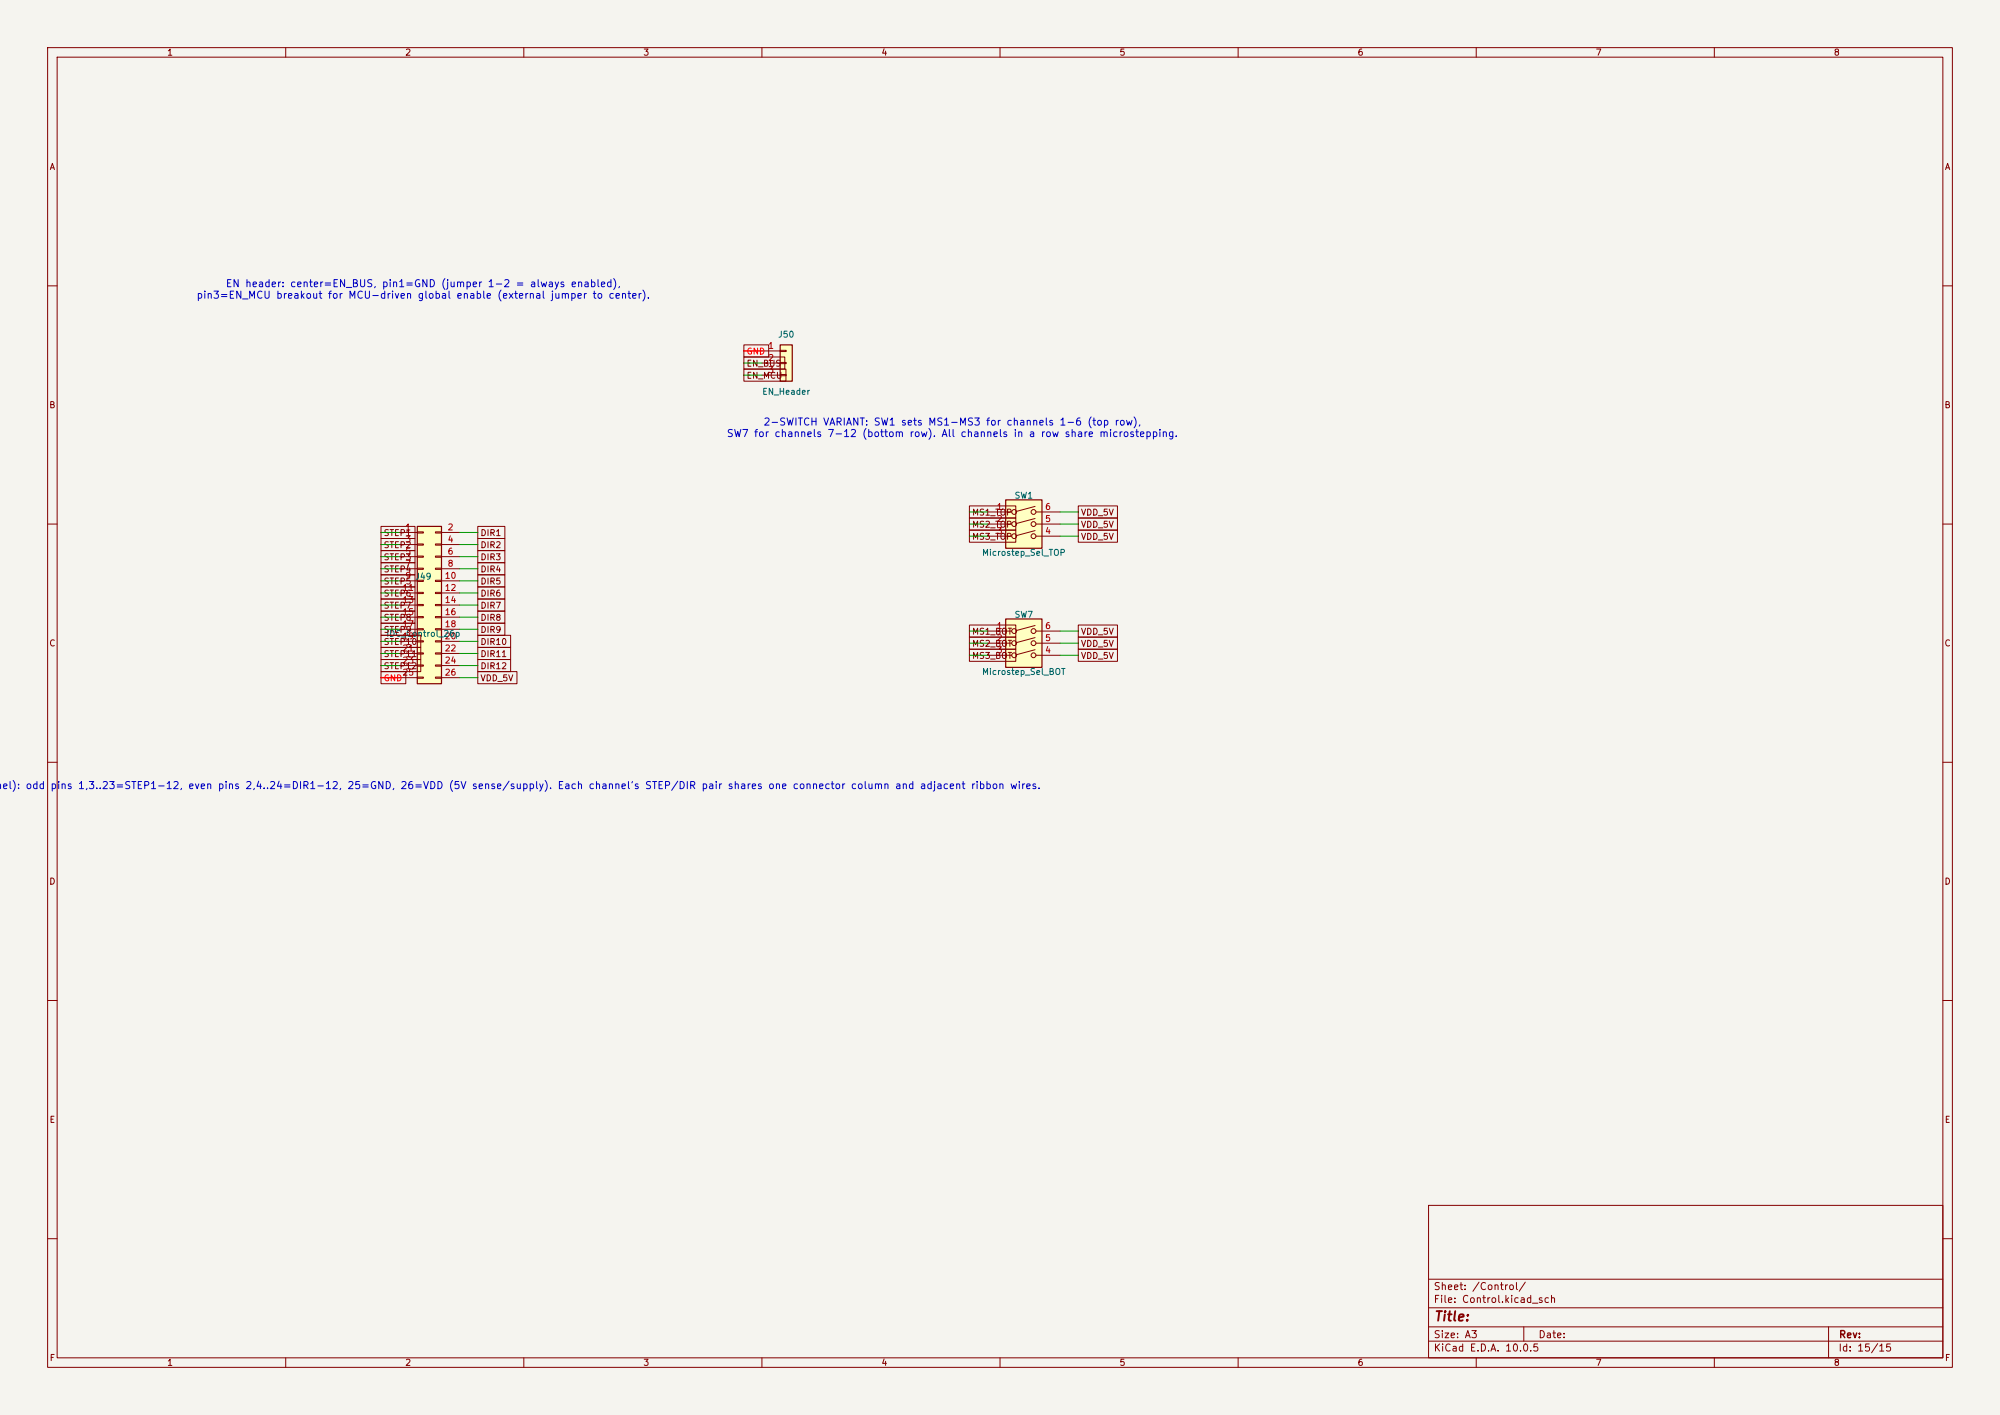
[picture p38: page 15]

EN header: center=EN_BUS, pin1=GND (jumper 1-2 = always enabled),
pin3=EN_MCU breakout for MCU-driven global enable (external jumper to center).

2-SWITCH VARIANT: SW1 sets MS1-MS3 for channels 1-6 (top row),

SW7 for channels 7-12 (bottom row). All channels in a row share microstepping.

IDC pin map (interleaved per channel): odd pins 1,3..23=STEP1-12, even pins 2,4..24=DIR1-12, 25=GND, 26=VDD (5V sense/supply). Each channel's STEP/DIR pair shares one connector column and adjacent ribbon wires.
