Sadrita404/Differential-Swerve-Robot/PCB_ELECTRICAL/2_ASSEMBLY_DATA/12SW_standard/12StepperPCB_RevB_12SW_Assembly_Top.pdf

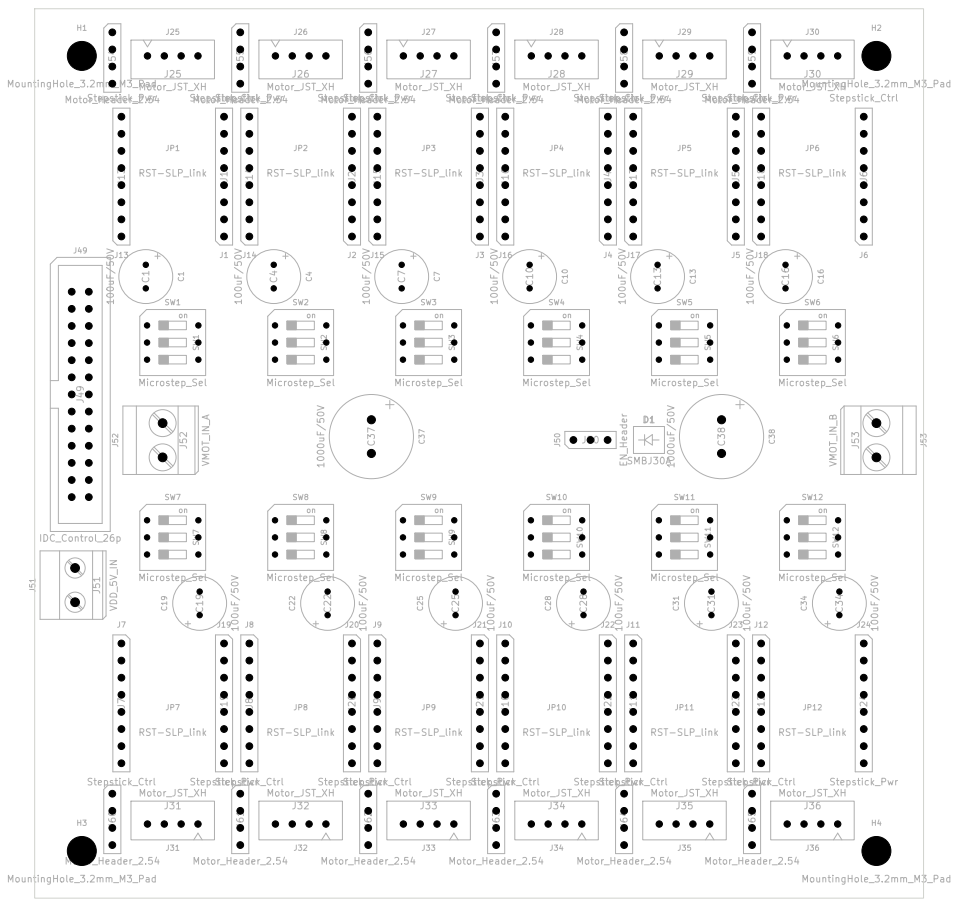
[picture p40: page 1]
