Sadrita404/Differential-Swerve-Robot/PCB_ELECTRICAL/2_ASSEMBLY_DATA/2SW_variant/12StepperPCB_RevB_2SW_Assembly_Bottom.pdf

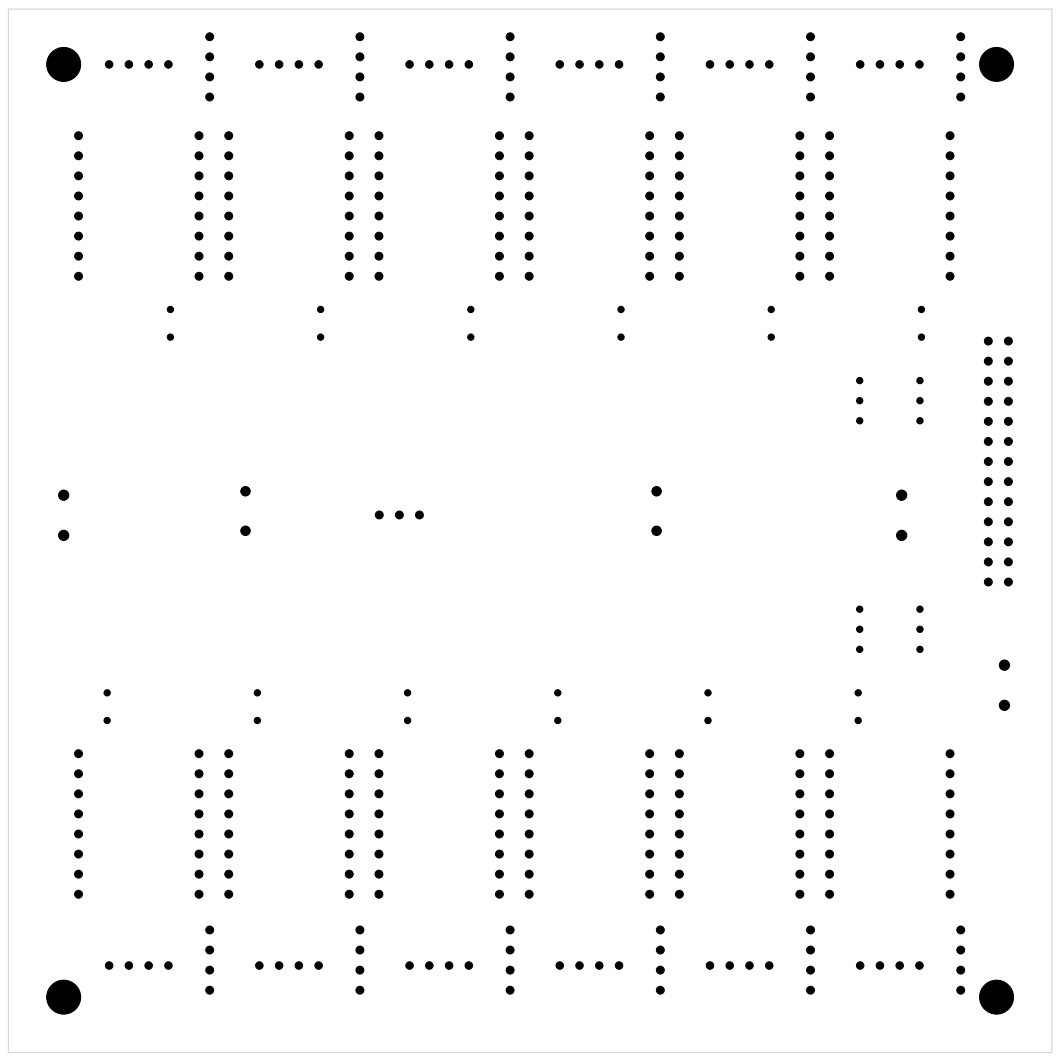
[picture p41: page 1]
