Sadrita404/Differential-Swerve-Robot/PCB_ELECTRICAL/3_KICAD_SOURCE/12SW_standard/12StepperPCB.kicad_pcb

## KiCad design PCB_ELECTRICAL/3_KICAD_SOURCE/12SW_standard/12StepperPCB.kicad_pcb (2026-11-04)

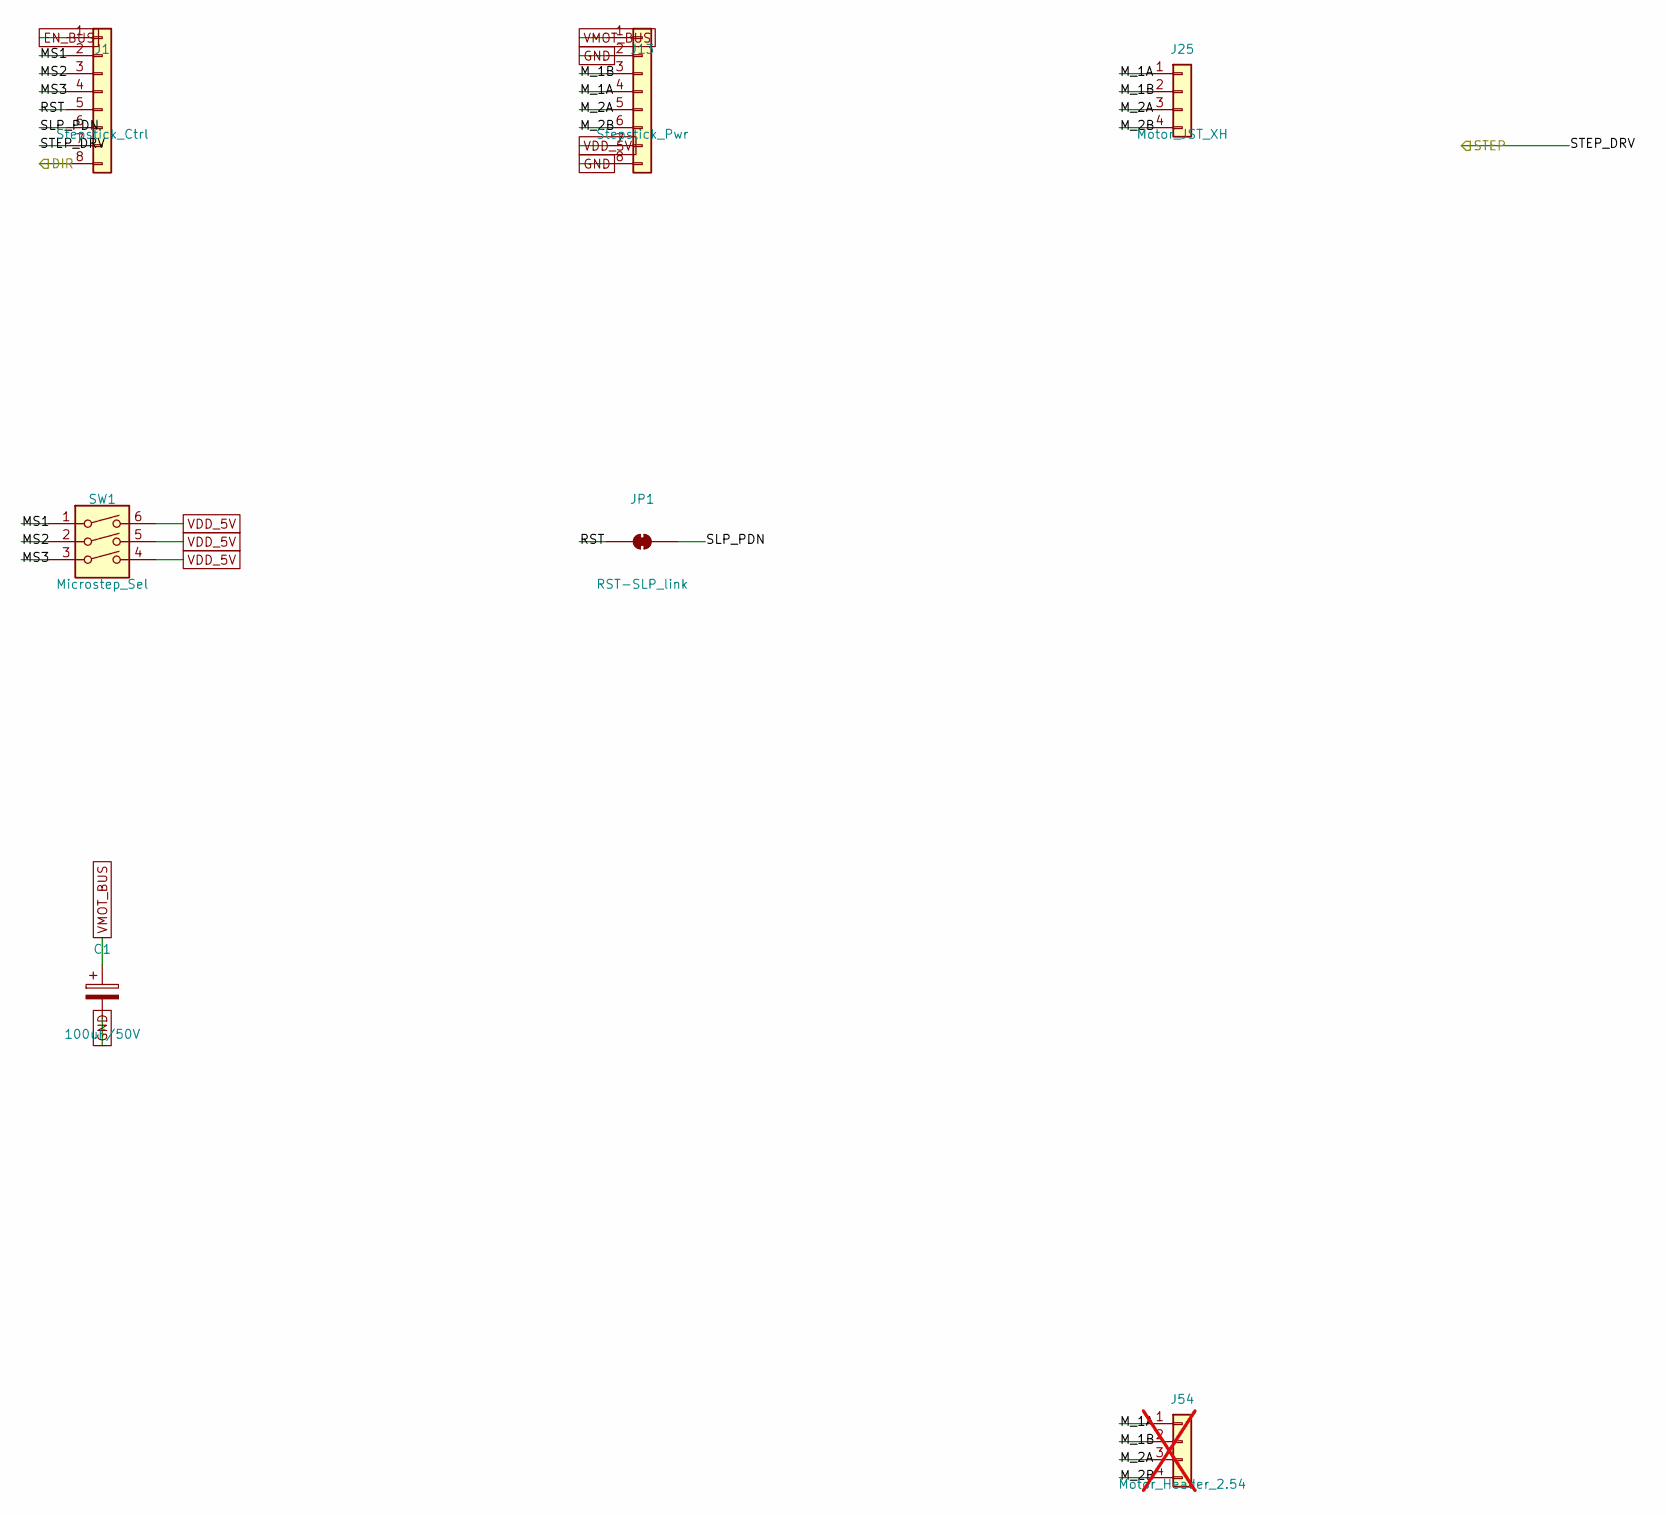
[picture p43: schematic Channel.kicad_sch]

Parts:
C1: 100uF/50V; CP_Radial_D8.0mm_P3.50mm; MPN EEU-FR1H101
J1: Stepstick_Ctrl; PinSocket_1x08_P2.54mm_Vertical; MPN PPTC081LFBN-RC
J13: Stepstick_Pwr; PinSocket_1x08_P2.54mm_Vertical; MPN PPTC081LFBN-RC
J25: Motor_JST_XH; JST_XH_B4B-XH-A_1x04_P2.50mm_Vertical; MPN B4B-XH-A(LF)(SN)
J54: Motor_Header_2.54; PinHeader_1x04_P2.54mm_Vertical; MPN PREC004SAAN-RC; not fitted
JP1: RST-SLP_link; SolderJumper-2_P1.3mm_Bridged_RoundedPad1.0x1.5mm
SW1: Microstep_Sel; SW_DIP_SPSTx03_Slide_9.78x9.8mm_W7.62mm_P2.54mm; MPN 206-3

Connections:
/Channel1/MS1: J1.2, SW1.1
/Channel1/MS2: J1.3, SW1.2
/Channel1/MS3: J1.4, SW1.3
/Channel1/M_1A: J13.4, J25.1, J54.1
/Channel1/M_1B: J13.3, J25.2, J54.2
/Channel1/M_2A: J13.5, J25.3, J54.3
/Channel1/M_2B: J13.6, J25.4, J54.4
/Channel1/RST: J1.5, JP1.1 (A)
/Channel1/SLP_PDN: J1.6, JP1.2 (B)
DIR1: J1.8; also elsewhere on the board
EN_BUS: J1.1; also elsewhere on the board
GND: C1.2, J13.2, J13.8; also elsewhere on the board
STEP1: J1.7; also elsewhere on the board
VDD_5V: J13.7, SW1.4, SW1.5, SW1.6; also elsewhere on the board
VMOT_BUS: C1.1, J13.1; also elsewhere on the board

Parts of its further copies:
C4, C7, C10, C13, C16, C19, C22, C25, C28, C31, C34: 100uF/50V; CP_Radial_D8.0mm_P3.50mm; MPN EEU-FR1H101
J2, J3, J4, J5, J6, J7, J8, J9, J10, J11, J12: Stepstick_Ctrl; PinSocket_1x08_P2.54mm_Vertical; MPN PPTC081LFBN-RC
J14, J15, J16, J17, J18, J19, J20, J21, J22, J23, J24: Stepstick_Pwr; PinSocket_1x08_P2.54mm_Vertical; MPN PPTC081LFBN-RC
J26, J27, J28, J29, J30, J31, J32, J33, J34, J35, J36: Motor_JST_XH; JST_XH_B4B-XH-A_1x04_P2.50mm_Vertical; MPN B4B-XH-A(LF)(SN)
J55, J56, J57, J58, J59, J60, J61, J62, J63, J64, J65: Motor_Header_2.54; PinHeader_1x04_P2.54mm_Vertical; MPN PREC004SAAN-RC; not fitted
JP2, JP3, JP4, JP5, JP6, JP7, JP8, JP9, JP10, JP11, JP12: RST-SLP_link; SolderJumper-2_P1.3mm_Bridged_RoundedPad1.0x1.5mm
SW2, SW3, SW4, SW5, SW6, SW7, SW8, SW9, SW10, SW11, SW12: Microstep_Sel; SW_DIP_SPSTx03_Slide_9.78x9.8mm_W7.62mm_P2.54mm; MPN 206-3

Connections of its further copies:
/Channel2/MS1: J2.2, SW2.1
/Channel2/MS2: J2.3, SW2.2
/Channel2/MS3: J2.4, SW2.3
/Channel2/M_1A: J14.4, J26.1, J55.1
/Channel2/M_1B: J14.3, J26.2, J55.2
/Channel2/M_2A: J14.5, J26.3, J55.3
/Channel2/M_2B: J14.6, J26.4, J55.4
/Channel2/RST: J2.5, JP2.1 (A)
/Channel2/SLP_PDN: J2.6, JP2.2 (B)
/Channel3/MS1: J3.2, SW3.1
/Channel3/MS2: J3.3, SW3.2
/Channel3/MS3: J3.4, SW3.3
/Channel3/M_1A: J15.4, J27.1, J56.1
/Channel3/M_1B: J15.3, J27.2, J56.2
/Channel3/M_2A: J15.5, J27.3, J56.3
/Channel3/M_2B: J15.6, J27.4, J56.4
/Channel3/RST: J3.5, JP3.1 (A)
/Channel3/SLP_PDN: J3.6, JP3.2 (B)
/Channel4/MS1: J4.2, SW4.1
/Channel4/MS2: J4.3, SW4.2
/Channel4/MS3: J4.4, SW4.3
/Channel4/M_1A: J16.4, J28.1, J57.1
/Channel4/M_1B: J16.3, J28.2, J57.2
/Channel4/M_2A: J16.5, J28.3, J57.3
/Channel4/M_2B: J16.6, J28.4, J57.4
/Channel4/RST: J4.5, JP4.1 (A)
/Channel4/SLP_PDN: J4.6, JP4.2 (B)
/Channel5/MS1: J5.2, SW5.1
/Channel5/MS2: J5.3, SW5.2
/Channel5/MS3: J5.4, SW5.3
/Channel5/M_1A: J17.4, J29.1, J58.1
/Channel5/M_1B: J17.3, J29.2, J58.2
/Channel5/M_2A: J17.5, J29.3, J58.3
/Channel5/M_2B: J17.6, J29.4, J58.4
/Channel5/RST: J5.5, JP5.1 (A)
/Channel5/SLP_PDN: J5.6, JP5.2 (B)
/Channel6/MS1: J6.2, SW6.1
/Channel6/MS2: J6.3, SW6.2
/Channel6/MS3: J6.4, SW6.3
/Channel6/M_1A: J18.4, J30.1, J59.1
/Channel6/M_1B: J18.3, J30.2, J59.2
/Channel6/M_2A: J18.5, J30.3, J59.3
/Channel6/M_2B: J18.6, J30.4, J59.4
/Channel6/RST: J6.5, JP6.1 (A)
/Channel6/SLP_PDN: J6.6, JP6.2 (B)
/Channel7/MS1: J7.2, SW7.1
/Channel7/MS2: J7.3, SW7.2
/Channel7/MS3: J7.4, SW7.3
/Channel7/M_1A: J19.4, J31.1, J60.1
/Channel7/M_1B: J19.3, J31.2, J60.2
/Channel7/M_2A: J19.5, J31.3, J60.3
/Channel7/M_2B: J19.6, J31.4, J60.4
/Channel7/RST: J7.5, JP7.1 (A)
/Channel7/SLP_PDN: J7.6, JP7.2 (B)
/Channel8/MS1: J8.2, SW8.1
/Channel8/MS2: J8.3, SW8.2
/Channel8/MS3: J8.4, SW8.3
/Channel8/M_1A: J20.4, J32.1, J61.1
/Channel8/M_1B: J20.3, J32.2, J61.2
/Channel8/M_2A: J20.5, J32.3, J61.3
/Channel8/M_2B: J20.6, J32.4, J61.4
/Channel8/RST: J8.5, JP8.1 (A)
/Channel8/SLP_PDN: J8.6, JP8.2 (B)
/Channel9/MS1: J9.2, SW9.1
/Channel9/MS2: J9.3, SW9.2
/Channel9/MS3: J9.4, SW9.3
/Channel9/M_1A: J21.4, J33.1, J62.1
/Channel9/M_1B: J21.3, J33.2, J62.2
/Channel9/M_2A: J21.5, J33.3, J62.3
/Channel9/M_2B: J21.6, J33.4, J62.4
/Channel9/RST: J9.5, JP9.1 (A)
/Channel9/SLP_PDN: J9.6, JP9.2 (B)
/Channel10/MS1: J10.2, SW10.1
/Channel10/MS2: J10.3, SW10.2
/Channel10/MS3: J10.4, SW10.3
/Channel10/M_1A: J22.4, J34.1, J63.1
/Channel10/M_1B: J22.3, J34.2, J63.2
/Channel10/M_2A: J22.5, J34.3, J63.3
/Channel10/M_2B: J22.6, J34.4, J63.4
/Channel10/RST: J10.5, JP10.1 (A)
/Channel10/SLP_PDN: J10.6, JP10.2 (B)
/Channel11/MS1: J11.2, SW11.1
/Channel11/MS2: J11.3, SW11.2
/Channel11/MS3: J11.4, SW11.3
/Channel11/M_1A: J23.4, J35.1, J64.1
/Channel11/M_1B: J23.3, J35.2, J64.2
/Channel11/M_2A: J23.5, J35.3, J64.3
/Channel11/M_2B: J23.6, J35.4, J64.4
/Channel11/RST: J11.5, JP11.1 (A)
/Channel11/SLP_PDN: J11.6, JP11.2 (B)
/Channel12/MS1: J12.2, SW12.1
/Channel12/MS2: J12.3, SW12.2
/Channel12/MS3: J12.4, SW12.3
/Channel12/M_1A: J24.4, J36.1, J65.1
/Channel12/M_1B: J24.3, J36.2, J65.2
/Channel12/M_2A: J24.5, J36.3, J65.3
/Channel12/M_2B: J24.6, J36.4, J65.4
/Channel12/RST: J12.5, JP12.1 (A)
/Channel12/SLP_PDN: J12.6, JP12.2 (B)
DIR2: J2.8; also elsewhere on the board
DIR3: J3.8; also elsewhere on the board
DIR4: J4.8; also elsewhere on the board
DIR5: J5.8; also elsewhere on the board
DIR6: J6.8; also elsewhere on the board
DIR7: J7.8; also elsewhere on the board
DIR8: J8.8; also elsewhere on the board
DIR9: J9.8; also elsewhere on the board
DIR10: J10.8; also elsewhere on the board
DIR11: J11.8; also elsewhere on the board
DIR12: J12.8; also elsewhere on the board
EN_BUS: J2.1, J3.1, J4.1, J5.1, J6.1, J7.1, J8.1, J9.1, J10.1, J11.1, J12.1; also elsewhere on the board
GND: C4.2, C7.2, C10.2, C13.2, C16.2, C19.2, C22.2, C25.2, C28.2, C31.2, C34.2, J14.2, J14.8, J15.2, J15.8, J16.2, J16.8, J17.2, J17.8, J18.2, J18.8, J19.2, J19.8, J20.2, J20.8, J21.2, J21.8, J22.2, J22.8, J23.2, J23.8, J24.2, J24.8; also elsewhere on the board
STEP2: J2.7; also elsewhere on the board
STEP3: J3.7; also elsewhere on the board
STEP4: J4.7; also elsewhere on the board
STEP5: J5.7; also elsewhere on the board
STEP6: J6.7; also elsewhere on the board
STEP7: J7.7; also elsewhere on the board
STEP8: J8.7; also elsewhere on the board
STEP9: J9.7; also elsewhere on the board
STEP10: J10.7; also elsewhere on the board
STEP11: J11.7; also elsewhere on the board
STEP12: J12.7; also elsewhere on the board
VDD_5V: J14.7, J15.7, J16.7, J17.7, J18.7, J19.7, J20.7, J21.7, J22.7, J23.7, J24.7, SW2.4, SW2.5, SW2.6, SW3.4, SW3.5, SW3.6, SW4.4, SW4.5, SW4.6, SW5.4, SW5.5, SW5.6, SW6.4, SW6.5, SW6.6, SW7.4, SW7.5, SW7.6, SW8.4, SW8.5, SW8.6, SW9.4, SW9.5, SW9.6, SW10.4, SW10.5, SW10.6, SW11.4, SW11.5, SW11.6, SW12.4, SW12.5, SW12.6; also elsewhere on the board
VMOT_BUS: C4.1, C7.1, C10.1, C13.1, C16.1, C19.1, C22.1, C25.1, C28.1, C31.1, C34.1, J14.1, J15.1, J16.1, J17.1, J18.1, J19.1, J20.1, J21.1, J22.1, J23.1, J24.1; also elsewhere on the board

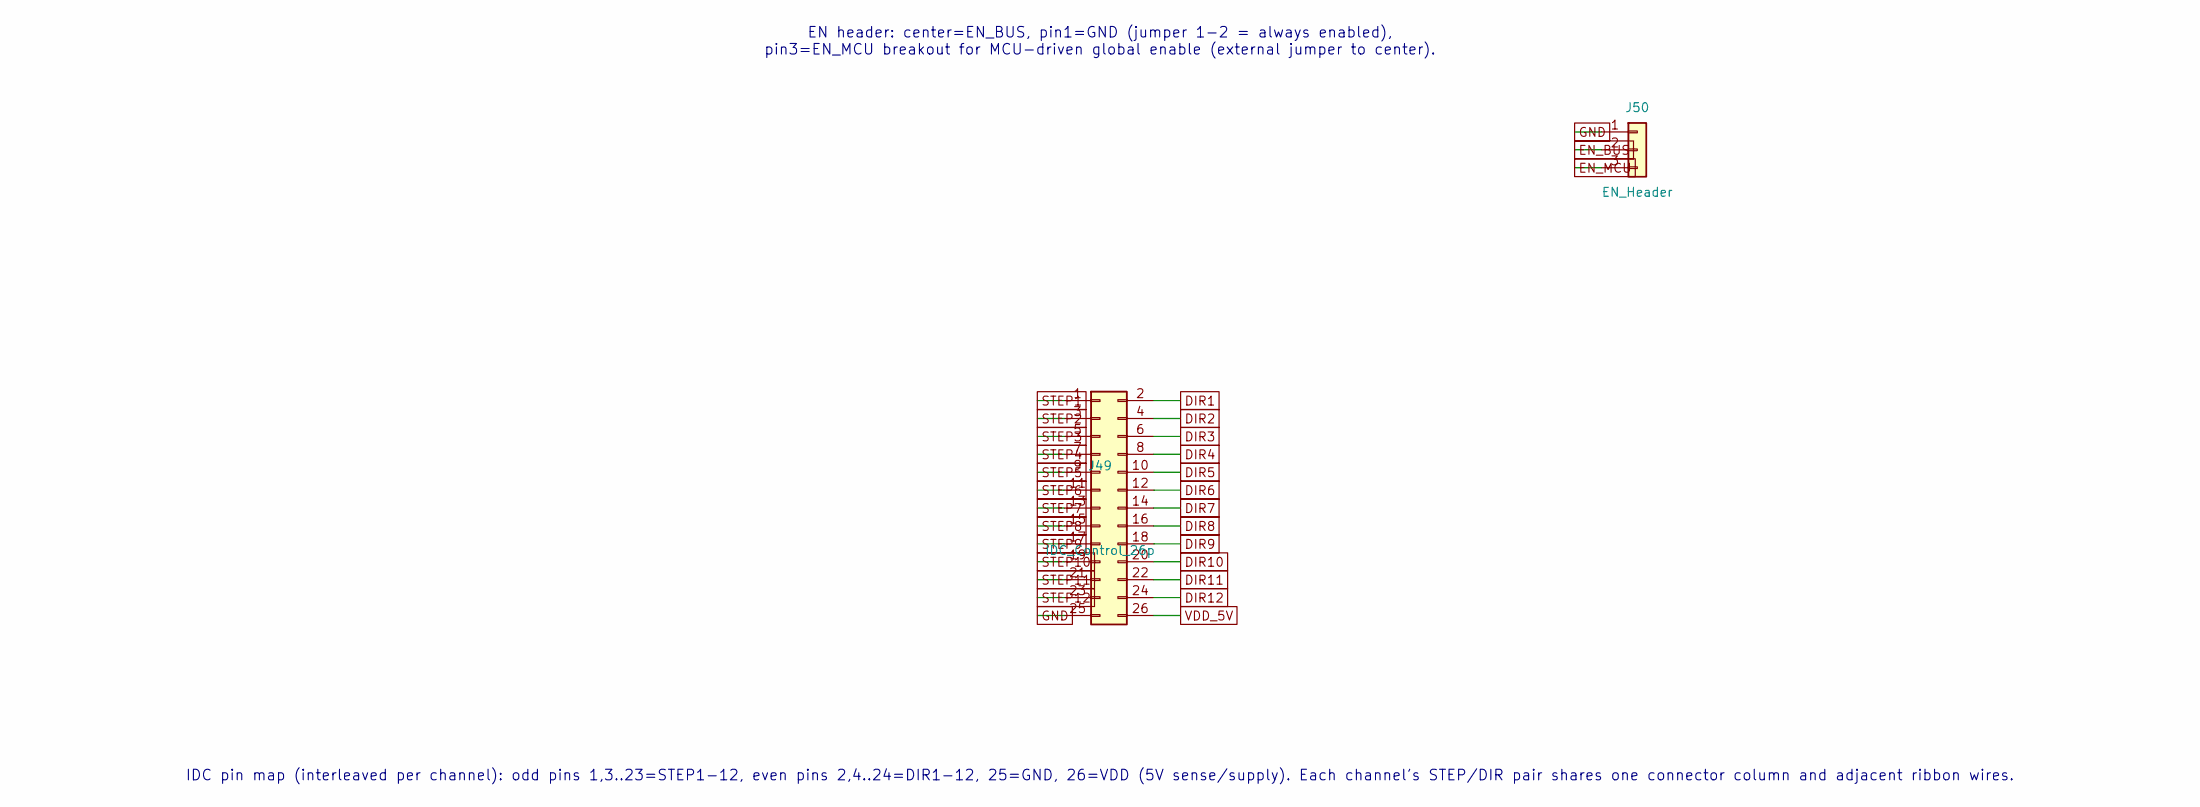
[picture p44: schematic Control.kicad_sch]

Parts:
J49: IDC_Control_26p; IDC-Header_2x13_P2.54mm_Vertical; MPN 302-S261
J50: EN_Header; PinHeader_1x03_P2.54mm_Vertical; MPN PREC003SAAN-RC

Connections:
DIR1: J49.2; also elsewhere on the board
DIR2: J49.4; also elsewhere on the board
DIR3: J49.6; also elsewhere on the board
DIR4: J49.8; also elsewhere on the board
DIR5: J49.10; also elsewhere on the board
DIR6: J49.12; also elsewhere on the board
DIR7: J49.14; also elsewhere on the board
DIR8: J49.16; also elsewhere on the board
DIR9: J49.18; also elsewhere on the board
DIR10: J49.20; also elsewhere on the board
DIR11: J49.22; also elsewhere on the board
DIR12: J49.24; also elsewhere on the board
EN_BUS: J50.2; also elsewhere on the board
EN_MCU: J50.3
GND: J49.25, J50.1; also elsewhere on the board
STEP1: J49.1; also elsewhere on the board
STEP2: J49.3; also elsewhere on the board
STEP3: J49.5; also elsewhere on the board
STEP4: J49.7; also elsewhere on the board
STEP5: J49.9; also elsewhere on the board
STEP6: J49.11; also elsewhere on the board
STEP7: J49.13; also elsewhere on the board
STEP8: J49.15; also elsewhere on the board
STEP9: J49.17; also elsewhere on the board
STEP10: J49.19; also elsewhere on the board
STEP11: J49.21; also elsewhere on the board
STEP12: J49.23; also elsewhere on the board
VDD_5V: J49.26; also elsewhere on the board

Notes on the sheet:
EN header: center=EN_BUS, pin1=GND (jumper 1-2 = always enabled), pin3=EN_MCU breakout for MCU-driven global enable (external jumper to center).
IDC pin map (interleaved per channel): odd pins 1,3..23=STEP1-12, even pins 2,4..24=DIR1-12, 25=GND, 26=VDD (5V sense/supply). Each channel's STEP/DIR pair shares one connector column and adjacent ribbon wires.

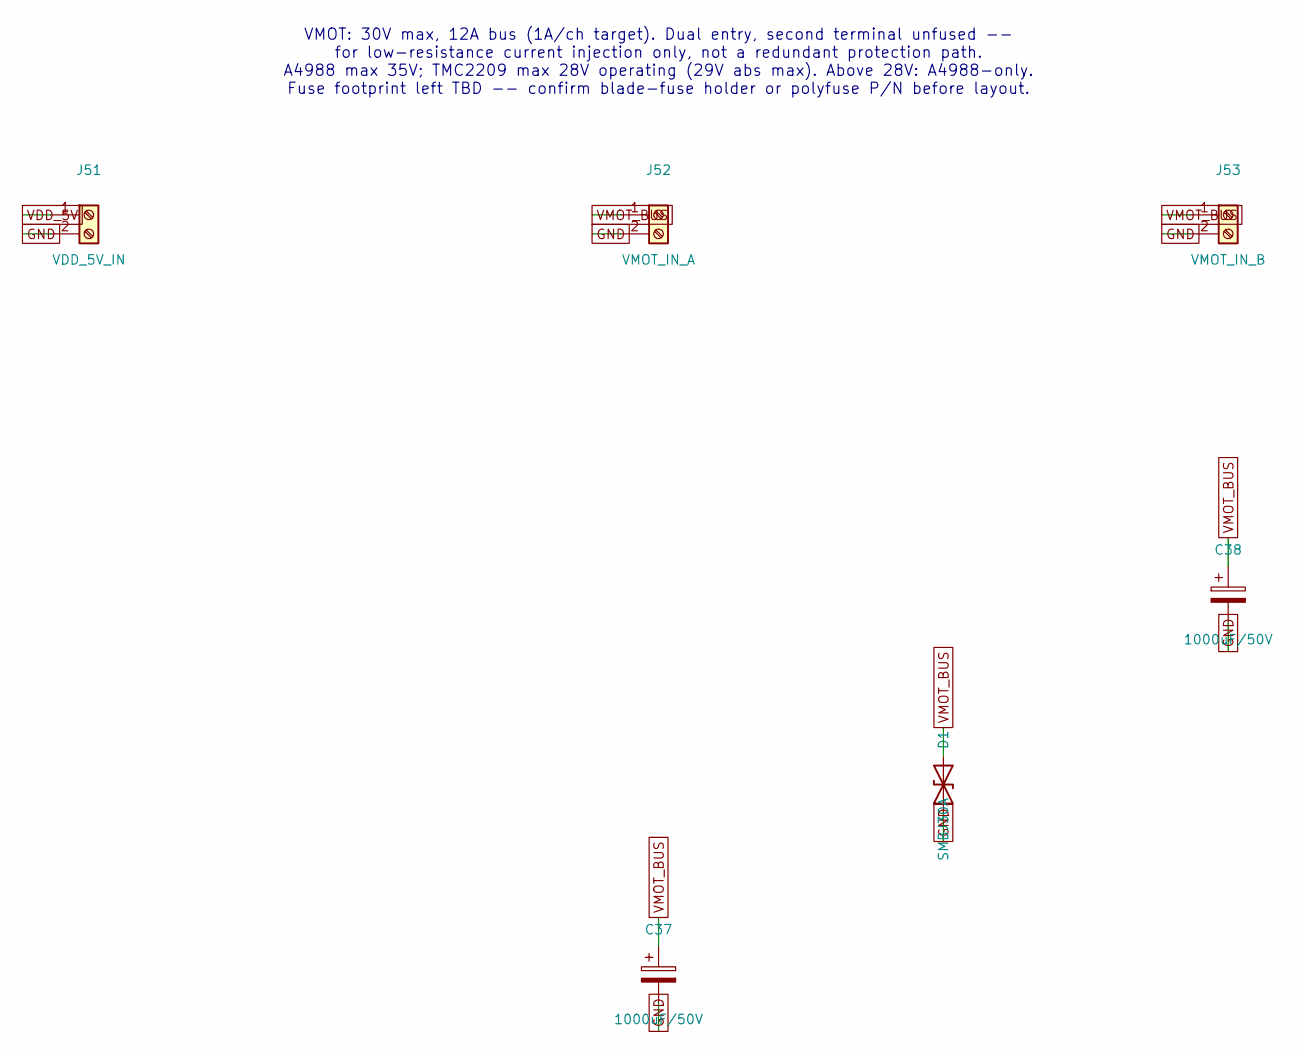
[picture p45: schematic Power.kicad_sch]

Parts:
C37, C38: 1000uF/50V; CP_Radial_D12.5mm_P5.00mm; MPN EEU-FR1H102
D1: SMBJ30A; D_SMB; MPN SMBJ30A
J51: VDD_5V_IN; TerminalBlock_Phoenix_MKDS-1,5-2-5.08_1x02_P5.08mm_Horizont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; MPN 1715721
J52: VMOT_IN_A; TerminalBlock_Phoenix_MKDS-3-2-5.08_1x02_P5.08mm_Horizontal; MPN 1711725
J53: VMOT_IN_B; TerminalBlock_Phoenix_MKDS-3-2-5.08_1x02_P5.08mm_Horizontal; MPN 1711725

Connections:
GND: C37.2, C38.2, D1.1 (A1), J51.2, J52.2, J53.2; also elsewhere on the board
VDD_5V: J51.1; also elsewhere on the board
VMOT_BUS: C37.1, C38.1, D1.2 (A2), J52.1, J53.1; also elsewhere on the board

Notes on the sheet:
VMOT: 30V max, 12A bus (1A/ch target). Dual entry, second terminal unfused -- for low-resistance current injection only, not a redundant protection path. A4988 max 35V; TMC2209 max 28V operating (29V abs max). Above 28V: A4988-only. Fuse footprint left TBD -- confirm blade-fuse holder or polyfuse P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

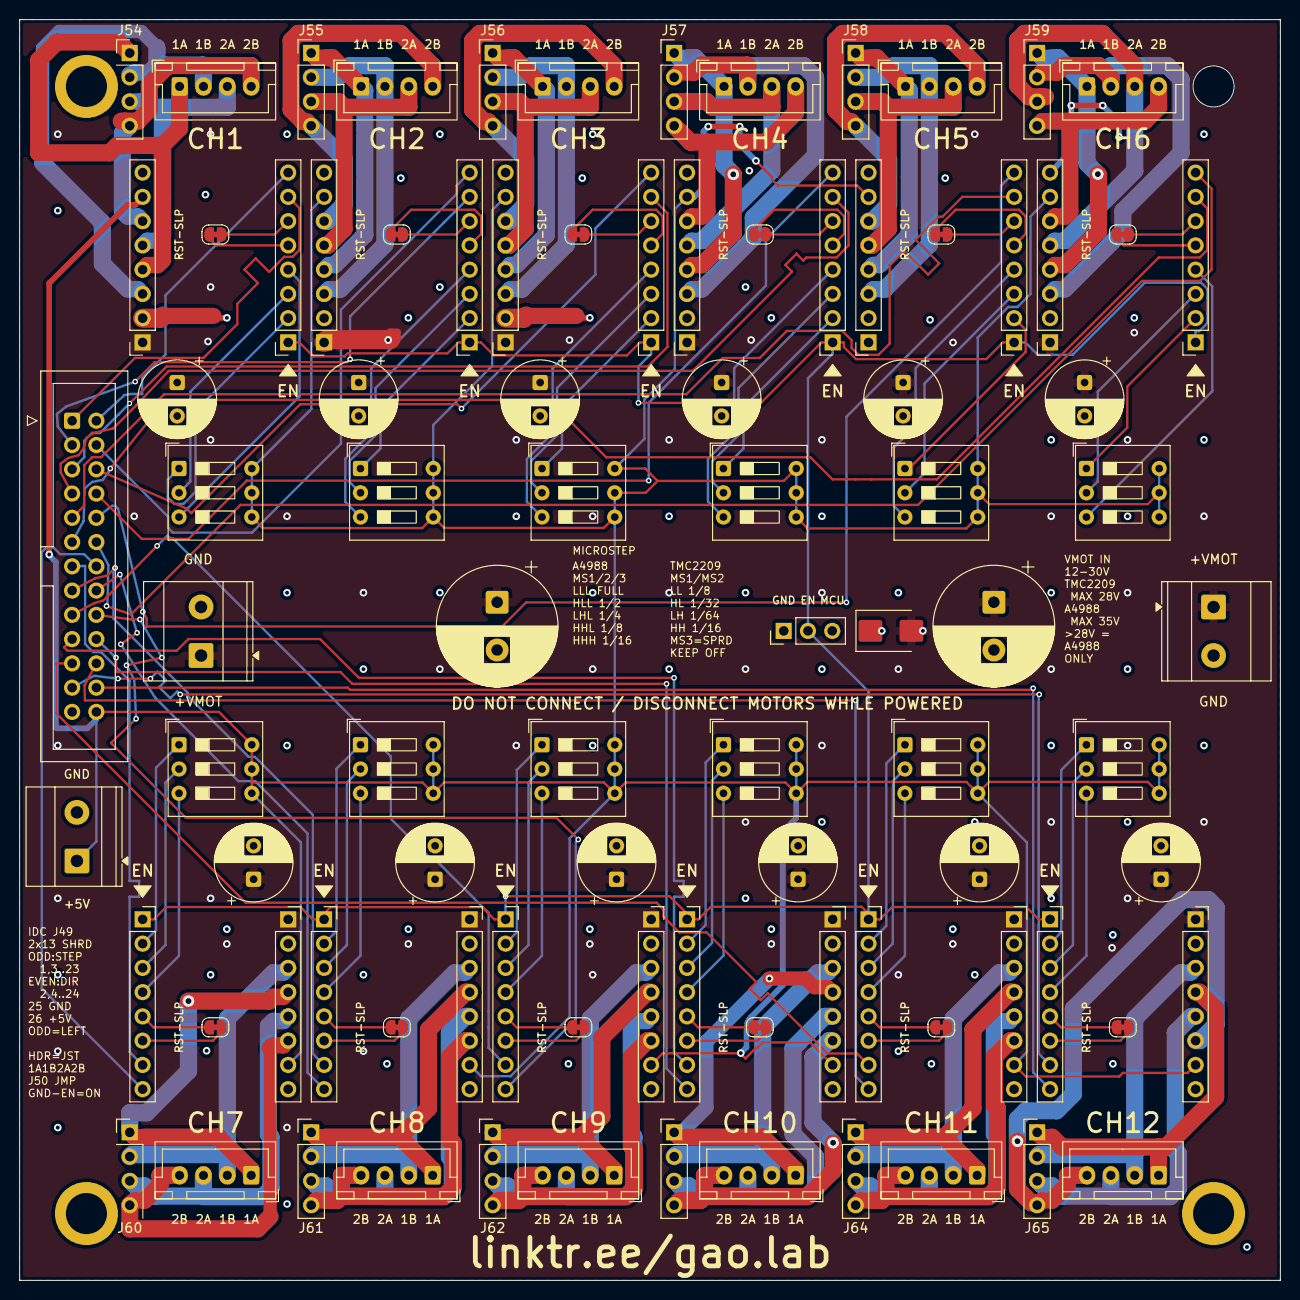
[picture p46: board 12StepperPCB.kicad_pcb from above]

Board: 4 copper layers, 132.0 x 132.0 mm, 96 parts (0 on the bottom side), 136 nets.

Other parts of the board:
H1, H2, H3, H4: MountingHole_3.2mm_M3_Pad

Their connections:
GND: H1.1, H3.1, H4.1; also elsewhere on the board
